RATsynthesizers/FXcursion-HW/3D/Common parts/tmp/iso-7380-din-7380-parafuso-oval-sextavado-1.snapshot.6/ISO 7380 - DIN 7380.JPG

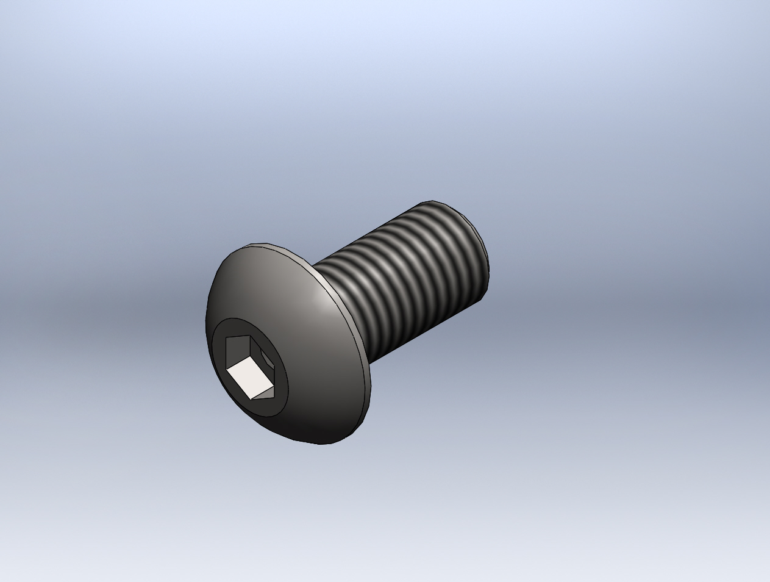
3D/Common parts/tmp/iso-7380-din-7380-parafuso-oval-sextavado-1.snapshot.6/ISO 7380 - DIN 7380.JPG
