RATsynthesizers/FXcursion-HW/HW/3D_design_approx/main.PcbDoc.htm

Reporting Options

# File in Newer Format

Date | : | 28.10.2026
Time | : | 22:34:09
Filename | : | C:\Users\romte\Desktop\FXcursion-HW\HW\3D_design_approx\main.PcbDoc

Version | Warning
Release 23.6 | CAUTION - The PCB document contains Footprint parameters. These will be lost when opening the document in a version of Altium Designer that does not support this functionality.

This file was generated by a later version of the software
