RATsynthesizers/FXcursion-HW/HW/H743ZI_SD_LCD_DRAM_Dev/Docs/NUCLEO-144pins_Altium_Schematics-Layout/MB1137.PcbDoc.htm

Reporting Options

# File in Newer Format

Date | : | 4/4/2026
Time | : | 5:01:34 PM
Filename | : | D:\TMP\Desktop\FXcursion-HW\HW\H743ZI_SD_LCD_DRAM_Dev\Docs\NUCLEO-144pins_Altium_Schematics-Layout\MB1137.PcbDoc

Version | Warning
Release 12 | CAUTION - Air Gap Width previously controlled by Clearance rule is now controlled by Polygon Connect Style rule's newly introduced Air Gap Width (set to default value). Suggest reviewing each Polygon Connect Style rule's Air Gap Width attribute for correctness.
Release 13 | CAUTION - Silkscreen Over Component Pads Rules are converted to Silk To Solder Mask Clearance Rules. Suggest examining rule scopes for accuracy.

This file was generated by an earlier version of the software
