RATsynthesizers/FXcursion-HW/HW/_3D/pcb's/3D_design_approx/test_4/IDFReport_3d_design_approx.html

Altium customize

# IDF File Translation Report

Date: | | 2/19/2024
Time: | | 11:19:47 PM
Elapsed Time: | | 00:00:00
PCB Filename | : | D:\YandexDisk\FXcursion-HW\HW\3D_design_approx\3d_design_approx.PcbDoc
IDF Board Filename | : | D:\YandexDisk\FXcursion-HW\HW\_3D\pcb's\3D_design_approx\test_4\3d_design_approx.brd
IDF Library Filename | : | D:\YandexDisk\FXcursion-HW\HW\_3D\pcb's\3D_design_approx\test_4\3d_design_approx.pro

Errors

Back to top

Warnings

Back to top

Save Warnings

Back to top

Save Errors

Back to top

Export Warnings

Library Component SOT-666 is missing Comment, resulting in missing Part Number. Suggest using 'Replace Blank Component Fields With' Export IDF option.

Back to top

Export Errors

Back to top
