RATsynthesizers/FXcursion-HW/HW/README_pedalboard_hw.docx

Actual pinouts are:

\HW\_Docs\ _AUDIO_PINOUT

\HW\_Docs\_GUI_PINOUT

Мы поняли, что у нас:

- По 2 плашки 512 мегабит ОЗУ (128 мегабайт в сумме) на каждом мк
- Из них где-то 25 мегабайт – активный размер лупера для сохранения на сд-карту (x2 на ctrl+z, и ещё x2 для двух луперов – всего 100 мегабайт под лупер в ОЗУ)
- Что даёт нам бюджет моно звука для обоих луперов (48khz, 25 мегабайт, данные упакованы):

16-bit: ~4 min 20 sec

24-bit: ~2 min 54 sec

32-bit: ~2 min 10 sec

- То есть, в самом худшем случае – 2 стерео-лупера – имеем макс. длину лупа:

16-bit: ~1 min 5 sec

24-bit: ~43 sec

32-bit: ~32sec

- При самом низком музыкальном BPM=40 длина 4 баров = 24сек, так что на 24-bit звуке будем иметь двойной запас при BPM=45. И на 32-bit звуке будет двойной запас при BPM=60.
- Передача 25 мегабайт по каналу SPI c выделенной для этого полосой 80 мегабит займёт ~2.5 сек. При этом по SPI 96MHz может ещё одновременно передаваться 4 канала рекордера.
- Размер ОЗУ GUI тоже составляет 128 мегабайт, так что туда спокойно поместится до 4 сохранений лупера. После этого нужно будет ждать сохранения этого буфера на SD-карту.

Last commit:

Pinout checking, bridging audio testboard and main board

Give SD_DETECT a defined inactive state, typically using about 10 kΩ with polarity chosen for the socket switch. Check the card controller's CMD/DAT pull-ups against the selected SD mode and card specification. Add a low-capacitance ESD protector close to the socket.

P0 — Power board, page 13: MT3608 boost output is set to approximately 6.6 V

The schematic shows R17 = 10 kΩ from the output to FB and R20 = 1 kΩ from FB to ground. The MT3608 uses a nominal 0.6 V feedback reference:

\[ V_{OUT}=0.6\left(1+\frac{10k}{1k}\right)=6.6\text{ V} \]

This conflicts with the +5V net label and could overvoltage the connected 5 V circuits. The MT3608 datasheet confirms the feedback equation.

Fix: If R20 remains 1 kΩ, use approximately 7.32 kΩ for R17 for about 4.99 V nominal. Recalculate using the chosen resistor tolerances and the actual converter variant, then verify output under light load, full load, startup, and battery-voltage extremes. Check the PCB feedback route is short and kept away from the switch node.

The project notes already flag recalculating this divider and adding 5 V overvoltage protection.

Codec interface, page 9: the two I2C1_SCL branches are gated using SN74LVC1G08 AND gates controlled by CODEC_GPIO1 and CODEC_GPIO2. TI specifies this device's output as push-pull, not open-drain.

I²C back propagation thru isolators, SDA ack problems

Pullups on every stage

SDMMC clock, QSPI clock, FMC/SDRAM clock, SPI SCK, SAI bit clock

These nets include high-edge-rate signals and some route through connectors

Add optional source-series resistor footprints, initially around 22–33 Ω, at the driver for clocks where ringing is a concern. Tune with the real PCB and oscilloscope; do not populate blanket resistors on every line without evidence.

DISPLAY LEDK CURRENT DRIVER instead of resistors
