RATsynthesizers/FXcursion-HW/HW/H743ZI_SD_LCD_DRAM_Dev/pinout_devboard.ods

PIN | FUNCTION | DEV_FUNCTION
PB5 | FMC_SDCKE1
PB6 | FMC_SDNE1
PC0 | FMC_SDNWE
PC2_C | FMC_SDNE0
PC3_C | FMC_SDCKE0
PC7 | FMC_NE1
PD0 | FMC_D2
PD1 | FMC_D3
PD4 | FMC_NOE
PD5 | FMC_NWE
PD8 | FMC_D13
PD9 | FMC_D14
PD10 | FMC_D15
PD14 | FMC_D0
PD15 | FMC_D1
PE0 | FMC_NBL0
PE1 | FMC_NBL1
PE5 | FMC_A21
PE6 | FMC_A22
PE7 | FMC_D4
PE8 | FMC_D5
PE9 | FMC_D6
PE10 | FMC_D7
PE11 | FMC_D8
PE12 | FMC_D9
PE13 | FMC_D10
PE14 | FMC_D11
PE15 | FMC_D12
PF0 | FMC_A0
PF1 | FMC_A1
PF2 | FMC_A2
PF3 | FMC_A3
PF4 | FMC_A4
PF5 | FMC_A5
PF11 | FMC_SDNRAS
PF12 | FMC_A6
PF13 | FMC_A7
PF14 | FMC_A8
PF15 | FMC_A9
PG0 | FMC_A10
PG1 | FMC_A11
PG4 | FMC_BA0
PG5 | FMC_BA1
PG8 | FMC_SDCLK
PG12 | FMC_NE4
PG15 | FMC_SDNCAS
PB2 | MY_LCD_TE_EXTI2
PC6 | MY_LCD_RESET
PC8 | SDMMC1_D0
PC9 | SDMMC1_D1
PC10 | SDMMC1_D2
PC11 | SDMMC1_D3
PC12 | SDMMC1_CK
PD2 | SDMMC1_CMD
PA10 | MY_SD_DETECT
PG2 | MY_FOOT3 | ENC_PARAM_B
PG3 | MY_FOOT2 | ENC_PARAM_A
PG7 | MY_FOOT1 | FOOT_1
PA7 | TIM8_CH1N | RGB_1
PB0 | TIM8_CH2N | RGB_2
PB1 | TIM8_CH3N | RGB_3
PG13 | MY_CHR2 | UP
PG14 | MY_CHR1 | DOWN
PB4 (NJTRST) | MY_CHST | YES
PB7 | MY_ADCON | NO
PE3 | MY_AUDIO_RST | ENC_A
PE4 | MY_AUDIO_BOOT | ENC_B
PA6 | ADC1_INP3 | ADC_VOL
PD11 | QUADSPI_BK1_IO0
PD12 | QUADSPI_BK1_IO1
PD13 | QUADSPI_BK1_IO3
PE2 | QUADSPI_BK1_IO2
PF10 | QUADSPI_CLK
PG6 | QUADSPI_BK1_NCS
PG9 | SPI1_MISO
PD7 | SPI1_MOSI
PG10 | SPI1_NSS
PG11 | SPI1_SCK
PB14 | SPI2_MISO
PB15 | SPI2_MOSI
PB12 | SPI2_NSS
PB13 | SPI2_SCK
PA2 | USART2_TX
PD6 | USART2_RX
PA0 | UART4_TX
PA1 | UART4_RX
PA8 | USB_OTG_FS_SOF
