RATsynthesizers/FXcursion-HW/3D/Pedal_V0/Fragment.png

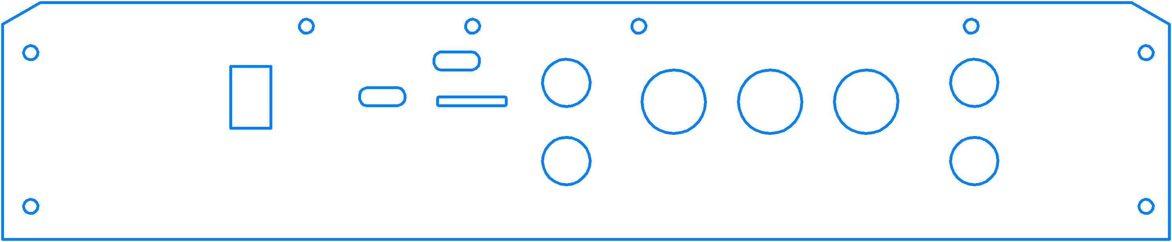
3D/Pedal_V0/Fragment.png
