RATsynthesizers/FXcursion-HW/3D/Pedal_V0/Pedal_assy_2/photo_export.jpg

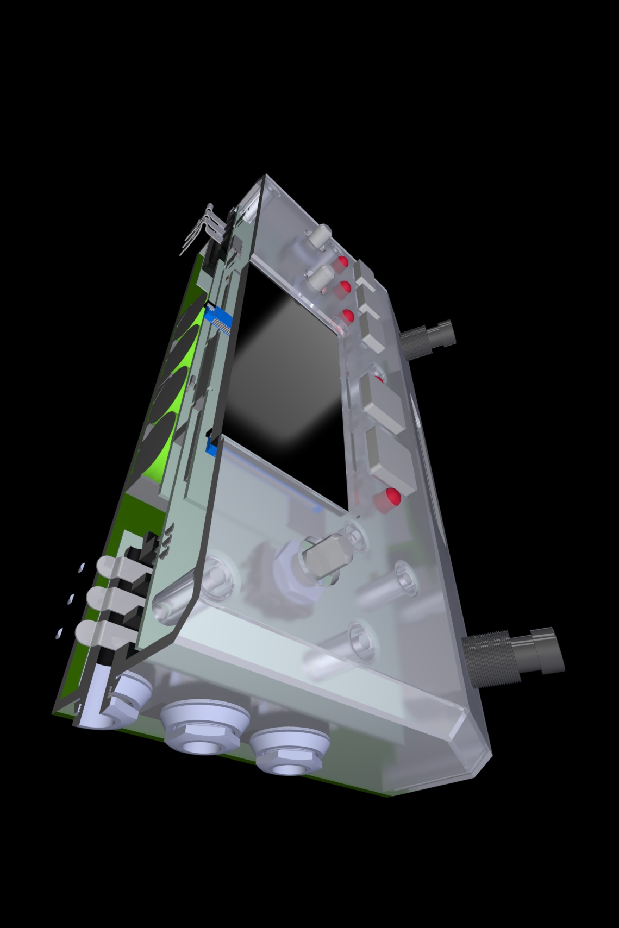
3D/Pedal_V0/Pedal_assy_2/photo_export.jpg
