RATsynthesizers/FXcursion-HW/3D/Pedal_V0/Pedal_assy_2/real_time_Pedal_assy_21.jpg

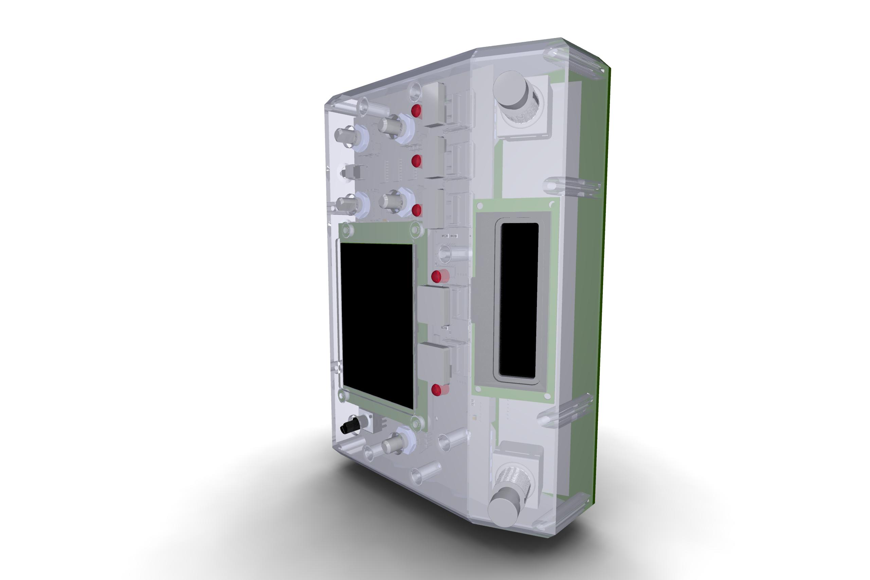
3D/Pedal_V0/Pedal_assy_2/real_time_Pedal_assy_21.jpg
