RATsynthesizers/FXcursion-HW/common docs/Pedal.png

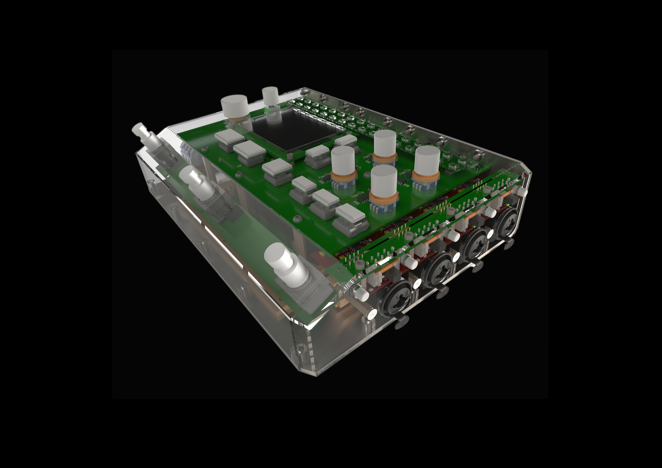
common docs/Pedal.png
