RATsynthesizers/FXcursion-HW/common docs/photo_2026-09-20_17-13-00.jpg

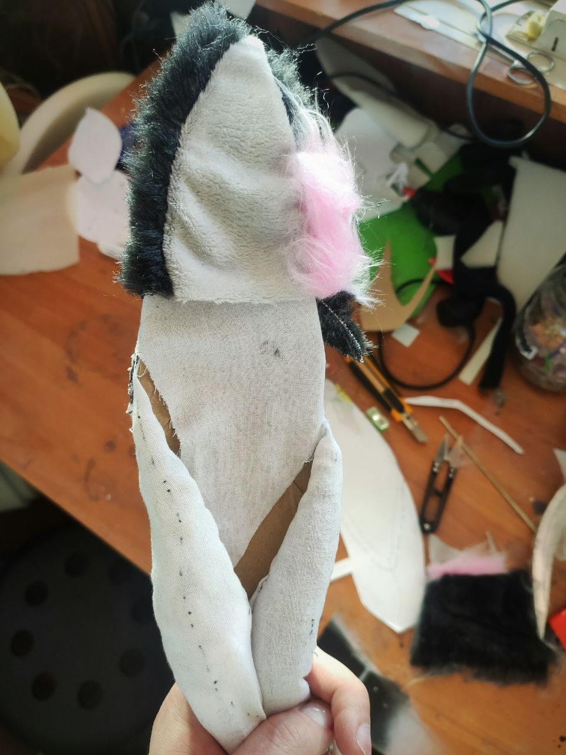
common docs/photo_2026-09-20_17-13-00.jpg
