RATsynthesizers/FXcursion-HW/common docs/photo_2026-09-29_17-15-21.jpg

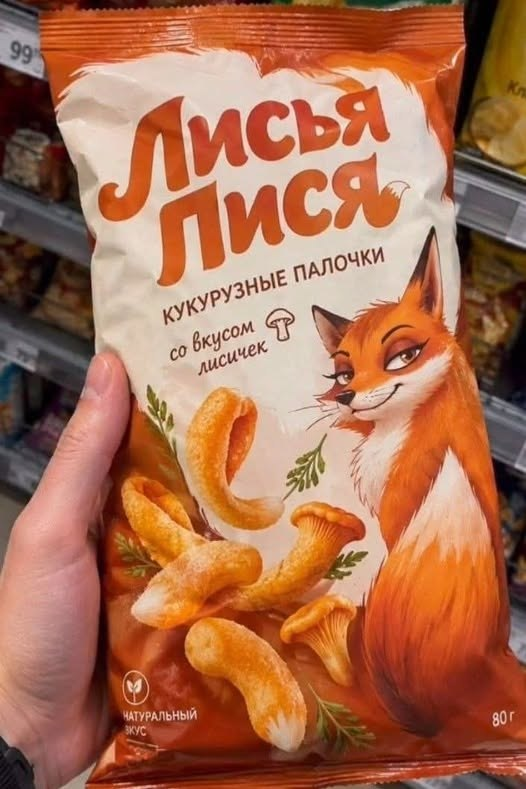
common docs/photo_2026-09-29_17-15-21.jpg
