RATsynthesizers/FXcursion-HW/HW/_Pics/MCP73831_loadshare_mcu2.png

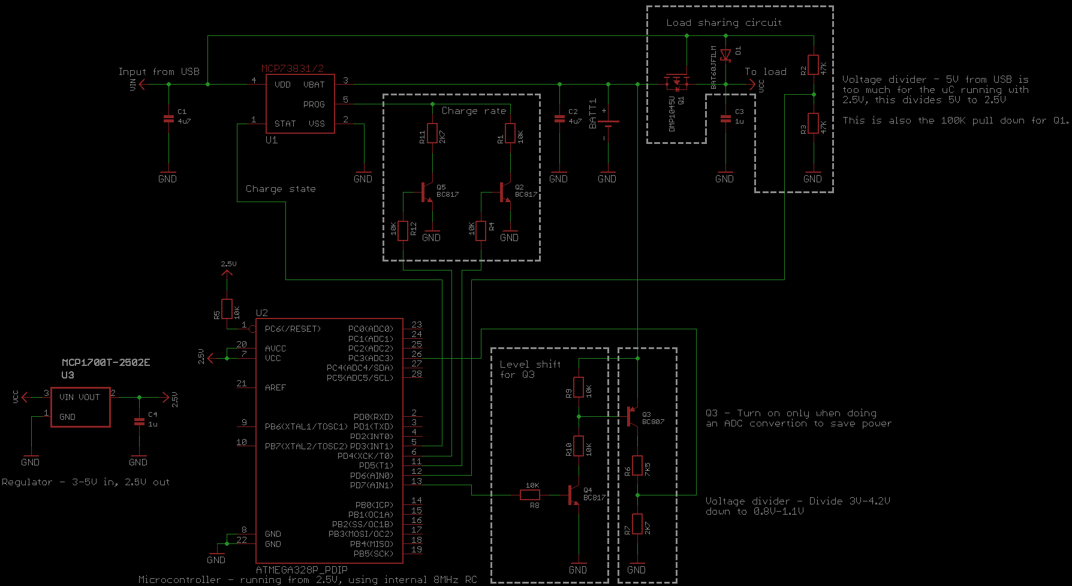
HW/_Pics/MCP73831_loadshare_mcu2.png
