RATsynthesizers/FXcursion-HW/HW/_Pics/xlr2.png

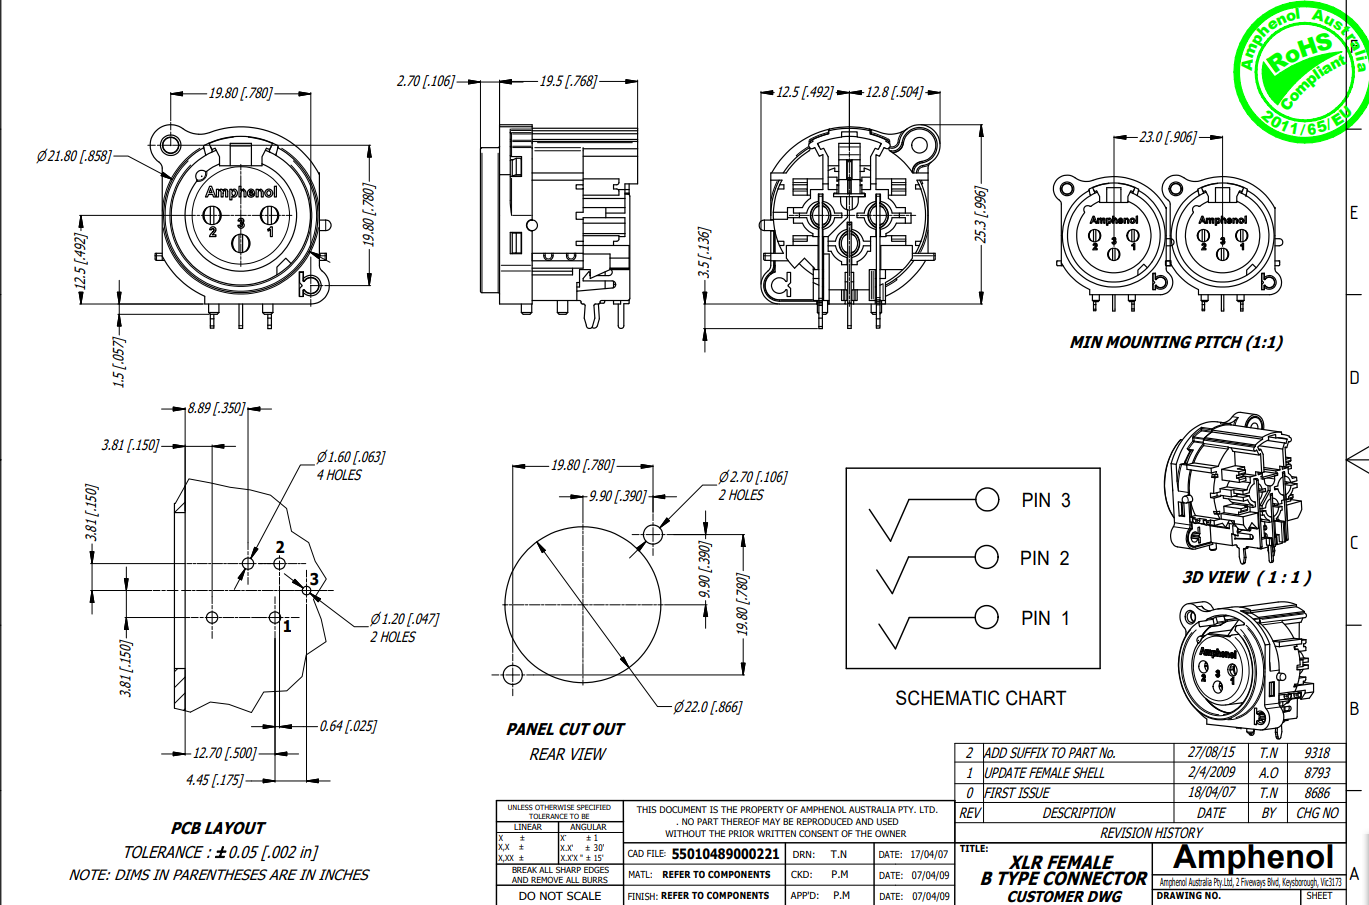
HW/_Pics/xlr2.png
