RATsynthesizers/FXcursion-HW/HW/Test_MultiBoard_Project/Project Outputs for Pedal_MultiBoard_Project/Pedal_MultiBoard_Project.xlsx

Line # | Name | Description | Designator | ModuleAssembly | Quantity | Part Number | Manufacturer 1 | Manufacturer Part Number 1 | Manufacturer Lifecycle 1 | Supplier 1 | Supplier Part Number 1 | Supplier Unit Price 1 | Supplier Subtotal 1
 |  |  |  | SOM_Codec_WM8731.PcbDoc, Pedal_XLR.PcbDoc, Pedal_SW.PcbDoc | 16
 | 1043 | BATTERY HOLDER 18650 PC PIN | B1, B2, B3, B4 | Pedal_Power.PcbDoc | 4 | 1043 |  |  |  | DigiKey | 36-1043-ND
 | 2.2 µF | CAP CER 2.2UF 10V X7R 0805 | C1, C2, C9, C10 | main.PcbDoc | 4 | C0805C225K8RAC7800 |  |  |  | DigiKey | 399-C0805C225K8RAC7800CT-ND
 | 10 µF | CAP CER 10UF 10V X5R 0805 | C1, C3, C4, C6, C7, C9, C11, C28, C30, C71, C74, C84, C85, C87, C88, C92, C93, C95 | SOM_Codec_WM8731.PcbDoc, Pedal_Power.PcbDoc, main.PcbDoc | 19 | C0805C106K8PAC7800 |  |  |  | DigiKey | 399-C0805C106K8PAC7800CT-ND
 | 0.1µF | CAP CER 0.1UF 16V X7R 0402 | C1, C3, C5, C7, C8, C10, C11, C12, C13, C14, C15, C16, C17, C18, C19, C20, C21, C22, C23, C24, C25, C26, C27, C28, C29, C30, C31, C32, C33, C34, C35, C36, C37, C38, C39, C40, C41, C42, C43, C44, C45, C46, C47, C48, C49, C50, C51, C52, C53, C54, C55, C56, C57, C58, C59, C60 | Pedal_SD_USB.PcbDoc, SOM_Codec_WM8731.PcbDoc, main.PcbDoc | 63 | C0402C104K4RACAUTO |  |  |  | DigiKey | 399-6828-1-ND
 | 10000 pF | CAP CER 10000PF 1KV X7R 1210 | C2 | Pedal_SD_USB.PcbDoc | 1 | C1210C103KDRAC7800 |  |  |  | DigiKey | 399-C1210C103KDRAC7800CT-ND
 | 1 µF | CAP CER 1UF 16V X7R 0805 | C2, C4, C5, C6, C69, C70, C72, C75, C76, C89 | SOM_Codec_WM8731.PcbDoc, Pedal_Power.PcbDoc, main.PcbDoc | 10 | C0805C105K4RAC7800 |  |  |  | DigiKey | 399-C0805C105K4RAC7800CT-ND
 | 9pF | CAP CER 9PF 250V C0G/NP0 0805 | C3, C4, C5, C6, C31, C32, C33 | main.PcbDoc, SOM_Codec_WM8731.PcbDoc | 7 | CBR08C909CAGAC |  |  |  | DigiKey | 399-8711-1-ND
 | 22 µF | CAP CER 22UF 25V X5R 0805 | C7, C8, C10, C12, C13 | Pedal_Power.PcbDoc | 5 | GRM21BR61E226ME44K |  |  |  | DigiKey | 490-14661-1-ND
 | 10µF | CAP TANT 10UF 10% 10V 1206 | C13, C14, C19, C20 | SOM_Codec_WM8731.PcbDoc | 4 | T491A106K010AT |  |  |  | DigiKey | 399-3684-1-ND
 | 220 pF | CAP CER 220PF 50V X7R 0603 | C17, C18, C21, C22 | SOM_Codec_WM8731.PcbDoc | 4 | C0603C221K5RAC7867 |  |  |  | DigiKey | 399-C0603C221K5RAC7867CT-ND
 | 47µF | CAP TANT 47UF 10% 10V 2917 | C23, C25 | SOM_Codec_WM8731.PcbDoc | 2 | 293D476X9010D2TE3 |  |  |  | DigiKey | 718-1088-1-ND
 | 0.1 µF | CAP CER 0.1UF 50V X7R 0603 | C61, C62, C63, C64, C65, C73, C77_IC101, C77_IC102, C77_IC103, C77_IC104, C77_IC105, C78_IC101, C78_IC102, C78_IC103, C78_IC104, C78_IC105, C79_IC101, C79_IC102, C79_IC103, C79_IC104, C79_IC105, C80, C81, C86 | main.PcbDoc | 24 | C0603C104K5RAC7411 |  |  |  | DigiKey | 399-C0603C104K5RAC7411CT-ND
 | 7 pF | CAP CER 7PF 50V C0G/NPO 0805 | C67, C68 | main.PcbDoc | 2 | CC0805DRNPO9BN7R0 |  |  |  | DigiKey | 311-1096-1-ND
 | 22 µF | CAP CER 22UF 25V X5R 0805 | C90, C91, C94, C96, C97 | main.PcbDoc | 5 | CC0805MKX5R8BB226 |  |  |  | DigiKey | 311-1903-1-ND
 | 1N4148W-TP | DIODE GEN PURP 100V 150MA SOD123 | D1 | main.PcbDoc | 1 | 1N4148W-TP |  |  |  | DigiKey | 1N4148WTPMSCT-ND
 | SS24 | DIODE SCHOTTKY 40V 2A DO214AA | D1, D2, D3 | Pedal_Power.PcbDoc, main.PcbDoc | 4 | SS24 |  |  |  | DigiKey | SS24FSCT-ND
 | Red | LED RED CLEAR 0805 SMD | D3, D4 | Pedal_Power.PcbDoc, main.PcbDoc | 2 | LSM0805412V |  |  |  | DigiKey | 28-LSM0805412VCT-ND
 | Comment |  | Designator3, Designator4, Designator5, Designator6 | Pedal_XLR.PcbDoc, Pedal_SW.PcbDoc | 8
 | Encoder_15mm |  | ENC1, ENC2, ENC3, ENC4, ENC5 | main.PcbDoc | 5
 | 220 Ohms @ 100 MHz | FERRITE BEAD 220 OHM 0805 1LN | FB1, FB2, FB3, FB4, FB5 | main.PcbDoc | 5 | BLM21PG221SN1D |  |  |  | DigiKey | 490-1054-1-ND
 | Z=90Ohm | ACM Series 0805 360 Ohm 220mA 500 mOhm DCR 50 V SMT Common Mode Filter | FL1 | Pedal_SD_USB.PcbDoc | 1
 | FootSwitch |  | FSW1, FSW2, FSW3 | FootSW.PcbDoc | 3
 | FFC_50_DBG |  | H1, H2, H3 | Pedal_Display.PcbDoc, main.PcbDoc | 3
 | arduino_header_6 |  | H1, H2, H3, H4 | main.PcbDoc, Pedal_SD_USB.PcbDoc | 6
 | STM32H743ZIT6U | Integrated Circuit | IC1, IC2 | main.PcbDoc | 2
 | ams1117-3.3v | Integrated Circuit | IC1, IC10 | SOM_Codec_WM8731.PcbDoc, main.PcbDoc | 2 |  |  |  |  | LCSC | C6186
 | DMP1045U-7 | MOSFET P-CH 12V 4A SOT23 | IC2, IC20 | Pedal_Power.PcbDoc, main.PcbDoc | 2 | DMP1045U-7 |  |  |  | DigiKey | DMP1045U-7DICT-ND
 | LY68L6400SLIT | Integrated Circuit | IC3 | main.PcbDoc | 1
 | MT3608 | Integrated Circuit | IC3, IC21 | Pedal_Power.PcbDoc, main.PcbDoc | 2
 | SN74LVC1G125DBVR | Integrated Circuit | IC4, IC18, IC19 | main.PcbDoc | 3
 | IP2312 | Integrated Circuit | IC4, IC23 | Pedal_Power.PcbDoc, main.PcbDoc | 2
 | N25Q128A13ESE40F | Integrated Circuit | IC6, IC55 | main.PcbDoc | 2
 | AT24C128BN-SH-B | Integrated Circuit | IC7, IC8 | main.PcbDoc | 2
 | LD1117DT33TR | Integrated Circuit | IC9, IC22 | main.PcbDoc | 2
 | 74VHCT14AM | Integrated Circuit | IC11_IC101, IC11_IC102, IC11_IC103, IC11_IC104, IC11_IC105 | main.PcbDoc | 5
 | SN74HC245PWR | Integrated Circuit | IC14 | main.PcbDoc | 1
 | 74HC165D_BJ_ | Integrated Circuit | IC15, IC16, IC17 | main.PcbDoc | 3
 | DF9-41P-1V_32_ | Connector | J1 | SOM_Codec_WM8731.PcbDoc | 1
 | 0528081271 | Connector | J1, J2, J3, J4, J5, J6, J7 | main.PcbDoc, Pedal_XLR.PcbDoc, Jacks.PcbDoc, FootSW.PcbDoc, Pedal_Power.PcbDoc, SOM_Codec_WM8731.PcbDoc | 17
 | TYPE-C-31-M-12 | USB Connectors 24 Receptacle 1 8.94*7.3mm RoHS | J1, J20 | Pedal_SD_USB.PcbDoc, main.PcbDoc | 2
 | SCHA4B0400 | SD card Connector | J2 | Pedal_SD_USB.PcbDoc | 1
 |  |  | J4, J5, J6, J7, J8, J9, J14, J15, J16, J17, J18, J19 | main.PcbDoc | 12
 | MIDI_IN | DIN5 | JK1 | main.PcbDoc | 1
 | MIDI_OUT/THRU | DIN5 | JK2 | main.PcbDoc | 1
 | 3.3 µH | FIXED IND 3.3UH 2.5A 28 MOHM SMD | L1, L2 | main.PcbDoc, SOM_Codec_WM8731.PcbDoc, Pedal_Power.PcbDoc | 5 | SRR6028-3R3Y |  |  |  | DigiKey | 118-SRR6028-3R3YCT-ND
 | WS2812B | Address LED | LED1, LED2, LED3, LED4, LED5, LED6, LED7, LED8, LED9, LED10, LED11, LED12, LED13, LED14, LED15, LED16, LED17, LED18, LED19, LED20, LED21, LED22, LED23, LED24, LED25, LED26, LED27, LED28, LED29, LED30, LED31, LED32 | main.PcbDoc | 32
 | MountingHole |  | MH1, MH2, MH3, MH4, MH5, MH6, MH7, MH8, MH9, MH10 | main.PcbDoc, SOM_Codec_WM8731.PcbDoc, Pedal_Display.PcbDoc, Pedal_SD_USB.PcbDoc | 20
 | PJ-609AE | 6.3mm jack HOOYA | PJ1, PJ2, PJ3, PJ4 | main.PcbDoc, Jacks.PcbDoc | 7
 | MMBT3904-7-F | TRANS NPN 40V 0.2A SOT23-3 | Q1, Q2, Q4, Q5, Q6 | main.PcbDoc, Pedal_Power.PcbDoc | 8 | MMBT3904-7-F |  |  |  | DigiKey | MMBT3904-FDICT-ND
 | 3906 |  | Q3 | main.PcbDoc, Pedal_Power.PcbDoc | 2
 |  | RES SMD 1M OHM 1% 1/10W 0603 | R1 | Pedal_SD_USB.PcbDoc | 1 | ERJ-3EKF1004V |  |  |  | DigiKey | P1.00MHCT-ND
 | YC164-JR-07100RL | RES ARRAY 4 RES 100 OHM 1206 | R1, R2 | main.PcbDoc | 2 | YC164-JR-07100RL |  |  |  | DigiKey | YC164J-100CT-ND
 | 5.6 kOhms | RES SMD 5.6K OHM 0.5% 1/10W 0603 | R1, R2, R3, R4, R5, R6, R7, R8, R13, R14, R15, R16, R17, R18 | SOM_Codec_WM8731.PcbDoc, main.PcbDoc | 14 | RT0603DRE075K6L |  |  |  | DigiKey | 311-2635-1-ND
 | 10 kOhms | RES SMD 10K OHM 1% 1/10W 0603 | R1, R3, R8, R9, R11, R13, R24, R25 | Pedal_Power.PcbDoc | 8 | RT0603FRE0710KL |  |  |  | DigiKey | YAG2321CT-ND
 | =Value | RES SMD 0 OHM JUMPER 1/10W 0603 | R2, R4, R135, R136 | Pedal_Power.PcbDoc, Pedal_SD_USB.PcbDoc, main.PcbDoc | 5 | RCA06030000ZSEA |  |  |  | DigiKey | 541-2192-1-ND
 | 100 Ohms | RES SMD 100 OHM 1% 1/16W 0402 | R3, R4, R8, R72, R73, R74, R75, R76, R77, R87, R88, R89, R90, R91, R92, R93, R94, R95, R96, R97, R98, R99, R100, R101, R108, R110, R111, R112, R113, R114, R115, R116, R117, R118, R119, R120, R121, R122, R123, R124, R132 | main.PcbDoc, Pedal_Power.PcbDoc | 42 | CRCW0402100RFKEE |  |  |  | DigiKey | 541-2953-1-ND
 | 10 kOhms | RES SMD 10K OHM 1% 1/10W 0603 | R5, R6, R7, R8, R9, R10, R11, R12, R17, R19, R21, R22, R23, R24, R25, R26, R27, R28, R29, R30, R31, R32, R33, R34, R35, R36, R38, R46, R47_IC101, R47_IC102, R47_IC103, R47_IC104, R47_IC105, R48_IC101, R48_IC102, R48_IC103, R48_IC104, R48_IC105, R49_IC101, R49_IC102, R49_IC103, R49_IC104, R49_IC105, R50, R78, R79, R80, R81, R82, R83, R84, R85, R86, R106, R107, R109, R133, R134 | main.PcbDoc, Pedal_SD_USB.PcbDoc | 63 | ERJ-3EKF1002V |  |  |  | DigiKey, [NoParam] | P10.0KHCT-ND, [NoParam]
 | 1 MOhms | RES SMD 1M OHM 1% 1/10W 0603 | R6 | Pedal_SD_USB.PcbDoc | 1 | ERJ-3EKF1004V |  |  |  | DigiKey | P1.00MHCT-ND
 | 47 kOhms | RES SMD 47K OHM 1% 1/10W 0603 | R9, R13 | SOM_Codec_WM8731.PcbDoc | 2 | RT0603FRE0747KL |  |  |  | DigiKey | YAG3355CT-ND
 | 7.5 kOhms | RES 7.5K OHM 1% 1/10W 0603 | R10 | Pedal_Power.PcbDoc | 1 | RC0603FR-077K5L |  |  |  | DigiKey | 311-7.50KHRCT-ND
 | YC164-JR-0733RL | RES ARRAY 4 RES 33 OHM 1206 | R11, R12 | SOM_Codec_WM8731.PcbDoc | 2 | YC164-JR-0733RL |  |  |  | DigiKey | YC164J-33CT-ND
 | 2.7 kOhms | RES 2.7K OHM 1% 1/10W 0603 | R12 | Pedal_Power.PcbDoc | 1 | RC0603FR-072K7L |  |  |  | DigiKey | 311-2.70KHRCT-ND
 | 1 kOhms | RES SMD 1K OHM 1% 1/10W 0603 | R14 | Pedal_Power.PcbDoc | 1 | RT0603FRE071KL |  |  |  | DigiKey | YAG2323CT-ND
 | 100 Ohms | RES SMD 100 OHM 1% 1/16W 0402 | R15, R16 | SOM_Codec_WM8731.PcbDoc | 2 | RT0402FRE07100RL |  |  |  | DigiKey | YAG3342CT-ND
 | 1 kOhms | RES 1K OHM 5% 1/10W 0603 | R15, R18, R19 | Pedal_Power.PcbDoc | 3 | RC0603JR-071KP |  |  |  | DigiKey | YAG1311CT-ND
 | 2 Ohms | RES 2 OHM 1% 1/10W 0603 | R16 | Pedal_Power.PcbDoc | 1 | RC0603FR-072RL |  |  |  | DigiKey | 311-2.00HRCT-ND
 | 500 mOhms | RES 0.5 OHM 1% 1/10W 0603 | R17 | Pedal_Power.PcbDoc | 1 | RL0603FR-070R5L |  |  |  | DigiKey | 311-.5QCT-ND
 | Value | RES SMD 0 OHM JUMPER 1/10W 0603 | R18 | main.PcbDoc | 1 | RCA06030000ZSEA |  |  |  | DigiKey | 541-2192-1-ND
 | 51 kOhms | RES 51K OHM 1% 1/10W 0603 | R20, R23 | Pedal_Power.PcbDoc | 2 | RC0603FR-0751KL |  |  |  | DigiKey | 311-51.0KHRCT-ND
 | 1 kOhms | RES SMD 1K OHM 1% 1/10W 0603 | R20, R52, R127 | main.PcbDoc | 3 | CRCW06031K00FKEB |  |  |  | DigiKey | 541-2985-1-ND
 | 330 kOhms | RES 330K OHM 5% 1/10W 0603 | R21 | Pedal_Power.PcbDoc | 1 | RC0603JR-07330KL |  |  |  | DigiKey | 311-330KGRCT-ND
 | 220 kOhms | RES 220K OHM 1% 1/10W 0603 | R22 | Pedal_Power.PcbDoc | 1 | RC0603FR-07220KL |  |  |  | DigiKey | 311-220KHRCT-ND
 | 100k |  | R37 | main.PcbDoc | 1
 | 7.5 kOhms | RES 7.5K OHM 1% 1/10W 0603 SMD | R39 | main.PcbDoc | 1 | ERJ-U03F7501V |  |  |  | DigiKey | 10-ERJ-U03F7501VCT-ND
 | 22 Ohms | RES 22 OHM 5% 1/16W 0402 | R40, R41, R54, R55, R56, R57, R58, R59, R60, R61, R62, R63, R64, R65, R66, R67, R68, R69, R70, R71, R104 | main.PcbDoc | 21 | RMCF0402JT22R0 |  |  |  | DigiKey | RMCF0402JT22R0CT-ND
 | 10 Ohms | RES SMD 10 OHM 1% 1/3W 0603 | R42, R43, R44, R45, R102, R103, R105 | main.PcbDoc | 7 | ERJ-PA3F10R0V |  |  |  | DigiKey | P10.00BYCT-ND
 | 2.7 kOhms | RES 2.7K OHM 1% 1/10W 0603 | R51 | main.PcbDoc | 1 | CRCW06032K70FKEAC |  |  |  | DigiKey | 541-5328-1-ND
 | 2 Ohms | RES 2 OHM 1% 1/10W 0603 SMD | R53 | main.PcbDoc | 1 | ERJ-U03F2R00V |  |  |  | DigiKey | 10-ERJ-U03F2R00VCT-ND
 | 500 mOhms | RES 0.5 OHM 1% 1/10W 0603 | R125 | main.PcbDoc | 1 | RLT0816-C-R500-FNH |  |  |  | DigiKey | 2037-RLT0816-C-R500-FNHCT-ND
 |  | RES SMD 1K OHM 1% 1/10W 0603 | R126 | main.PcbDoc | 1 | CRCW06031K00FKEB |  |  |  | DigiKey | 541-2985-1-ND
 | 51 kOhms | RES 51K OHM 1% 1/10W 0603 | R128, R131 | main.PcbDoc | 2 | RMCF0603FT51K0 |  |  |  | DigiKey | RMCF0603FT51K0CT-ND
 | 330 kOhms | RES 330K OHM 5% 1/10W 0603 | R129 | main.PcbDoc | 1 | RMCF0603JG330K |  |  |  | DigiKey | RMCF0603JG330KCT-ND
 | 220 kOhms | RES 220K OHM 1% 1/10W 0603 | R130 | main.PcbDoc | 1 | CRCW0603220KFKEAC |  |  |  | DigiKey | 541-4039-1-ND
 | SS312SAH4-R | SWITCH SLIDE SPDT 0.4VA 28V | S1 | main.PcbDoc | 1 | SS312SAH4-R |  |  |  | DigiKey | 360-2924-1-ND
 | Kailh | Kailh keyboard switch, hotswap rgb, dual-side hotswap options + low prifile variant | SW1, SW2, SW3, SW4, SW5, SW6, SW7 | main.PcbDoc | 7
 | UART4_TX |  | TP1 | main.PcbDoc | 1
 | UART4_RX |  | TP2 | main.PcbDoc | 1
 | SAI2_SCK |  | TP3 | main.PcbDoc | 1
 | SAI2_FS |  | TP4 | main.PcbDoc | 1
 | USER_DBG1 |  | TP5 | main.PcbDoc | 1
 | USER_DBG2 |  | TP6 | main.PcbDoc | 1
 |  |  | TP7, TP8, TP9 | main.PcbDoc | 3
 | UART1_RX_boot |  | TP10 | main.PcbDoc | 1
 | UART1_TX_boot |  | TP11 | main.PcbDoc | 1
 | ToPower |  | TP12, TP13, TP14 | main.PcbDoc | 3
 | ToBAT+ |  | TP15 | main.PcbDoc | 1
 | ToBAT- |  | TP16 | main.PcbDoc | 1
 |  | Very Low Capacitance Esd Protection | U1 | Pedal_SD_USB.PcbDoc | 1
 | WM8731 | Stero in/ot audio codec | U1, U2 | SOM_Codec_WM8731.PcbDoc | 2
 | CONN-TH_NCJ6FA-H |  | U1, U2, U3, U4 | Pedal_XLR.PcbDoc | 4
 | W9812G6KH-6 |  | U1, U2, U3, U4 | main.PcbDoc | 4
 | H11L1 | OPTOISO 4.17KV OPN COLL 6SMD | U6 | main.PcbDoc | 1
 | 24.576MHz | CRYSTAL 24.5760MHZ 10PF SMD | Y1 | SOM_Codec_WM8731.PcbDoc | 1 | ABM8G-24.576MHZ-B4Y-T |  |  |  | DigiKey | 535-10296-1-ND
 | 24MHz | CRYSTAL 24MHZ 9PF SMD | Y1, Y2 | main.PcbDoc | 2 | NX3225SA-24MHZ-EXS00A-CS07532 |  |  |  | DigiKey | 644-1393-1-ND
 | ABS07-32.768KHZ-7-T | Crystal or Oscillator | Y3 | main.PcbDoc | 1
