RATsynthesizers/FXcursion-HW/HW/_Docs/New Folder (2)/pinout ioc h743zi_gui/pinout ioc h743zi_gui.csv

Position | Name | Type | Signal | Label
1 | PE2 | I/O | QUADSPI_BK1_IO2
2 | PE3 | I/O
3 | PE4 | I/O
4 | PE5 | I/O | FMC_A21
5 | PE6 | I/O | FMC_A22
6 | VBAT | Power
7 | PC13 | Output | GPIO_Output | MY_UI_RESET
8 | PC14-OSC32_IN (OSC32_IN) | I/O | RCC_OSC32_IN
9 | PC15-OSC32_OUT (OSC32_OUT) | I/O | RCC_OSC32_OUT
10 | PF0 | I/O | FMC_A0
11 | PF1 | I/O | FMC_A1
12 | PF2 | I/O | FMC_A2
13 | PF3 | I/O | FMC_A3
14 | PF4 | I/O | FMC_A4
15 | PF5 | I/O | FMC_A5
16 | VSS | Power
17 | VDD | Power
18 | PF6 | I/O | SPI5_NSS
19 | PF7 | I/O | SPI5_SCK
20 | PF8 | I/O | SPI5_MISO
21 | PF9 | I/O | SPI5_MOSI
22 | PF10 | I/O | QUADSPI_CLK
23 | PH0-OSC_IN (PH0) | I/O | RCC_OSC_IN
24 | PH1-OSC_OUT (PH1) | I/O | RCC_OSC_OUT
25 | NRST | Reset
26 | PC0 | I/O | FMC_SDNWE
27 | PC1 | I/O | ADC1_INP11
28 | PC2_C | I/O | FMC_SDNE0
29 | PC3_C | I/O | FMC_SDCKE0
30 | VDD | Power
31 | VSSA | Power
32 | VREF+ | MonoIO
33 | VDDA | Power
34 | PA0 | I/O | UART4_TX
35 | PA1 | I/O | UART4_RX
36 | PA2 | I/O | USART2_TX
37 | PA3 | I/O | ADC1_INP15
38 | VSS | Power
39 | VDD | Power
40 | PA4 | I/O | ADC1_INP18
41 | PA5 | I/O | ADC1_INP19
42 | PA6 | I/O | ADC1_INP3
43 | PA7 | I/O | ADC1_INP7
44 | PC4 | I/O | ADC1_INP4
45 | PC5 | I/O | ADC1_INP8
46 | PB0 | I/O | ADC1_INP9
47 | PB1 | I/O | ADC1_INP5
48 | PB2 | Output | GPIO_Output | MY_GUI_PB2
49 | PF11 | I/O | FMC_SDNRAS
50 | PF12 | I/O | FMC_A6
51 | VSS | Power
52 | VDD | Power
53 | PF13 | I/O | FMC_A7
54 | PF14 | I/O | FMC_A8
55 | PF15 | I/O | FMC_A9
56 | PG0 | I/O | FMC_A10
57 | PG1 | I/O | FMC_A11
58 | PE7 | I/O | FMC_D4
59 | PE8 | I/O | FMC_D5
60 | PE9 | I/O | FMC_D6
61 | VSS | Power
62 | VDD | Power
63 | PE10 | I/O | FMC_D7
64 | PE11 | I/O | FMC_D8
65 | PE12 | I/O | FMC_D9
66 | PE13 | I/O | FMC_D10
67 | PE14 | I/O | FMC_D11
68 | PE15 | I/O | FMC_D12
69 | PB10 | I/O | I2C2_SCL
70 | PB11 | I/O | I2C2_SDA
71 | VCAP | Power
72 | VDD | Power
73 | PB12 | I/O | SPI2_NSS
74 | PB13 | I/O | SPI2_SCK
75 | PB14 | I/O | SPI2_MISO
76 | PB15 | I/O | SPI2_MOSI
77 | PD8 | I/O | FMC_D13
78 | PD9 | I/O | FMC_D14
79 | PD10 | I/O | FMC_D15
80 | PD11 | I/O | QUADSPI_BK1_IO0
81 | PD12 | I/O | QUADSPI_BK1_IO1
82 | PD13 | I/O | QUADSPI_BK1_IO3
83 | VSS | Power
84 | VDD | Power
85 | PD14 | I/O | FMC_D0
86 | PD15 | I/O | FMC_D1
87 | PG2 | I/O
88 | PG3 | I/O
89 | PG4 | I/O | FMC_BA0
90 | PG5 | I/O | FMC_BA1
91 | PG6 | I/O | QUADSPI_BK1_NCS
92 | PG7 | I/O
93 | PG8 | I/O | FMC_SDCLK
94 | VSS | Power
95 | VDD33_USB | Power
96 | PC6 | Output | GPIO_Output | MY_LCD_RESET
97 | PC7 | I/O | FMC_NE1
98 | PC8 | I/O | SDMMC1_D0
99 | PC9 | I/O | SDMMC1_D1
100 | PA8 | I/O | USB_OTG_FS_SOF
101 | PA9 | I/O | USB_OTG_FS_VBUS
102 | PA10 | Input | GPIO_Input | MY_SD_DETECT
103 | PA11 | I/O | USB_OTG_FS_DM
104 | PA12 | I/O | USB_OTG_FS_DP
105 | PA13 (JTMS/SWDIO) | I/O | DEBUG_JTMS-SWDIO
106 | VCAP | Power
107 | VSS | Power
108 | VDD | Power
109 | PA14 (JTCK/SWCLK) | I/O | DEBUG_JTCK-SWCLK
110 | PA15 (JTDI) | I/O | DEBUG_JTDI
111 | PC10 | I/O | SDMMC1_D2
112 | PC11 | I/O | SDMMC1_D3
113 | PC12 | I/O | SDMMC1_CK
114 | PD0 | I/O | FMC_D2
115 | PD1 | I/O | FMC_D3
116 | PD2 | I/O | SDMMC1_CMD
117 | PD3 | I/O
118 | PD4 | I/O | FMC_NOE
119 | PD5 | I/O | FMC_NWE
120 | VSS | Power
121 | VDD | Power
122 | PD6 | I/O | USART2_RX
123 | PD7 | I/O | SPI1_MOSI
124 | PG9 | I/O | SPI1_MISO
125 | PG10 | I/O | SPI1_NSS
126 | PG11 | I/O | SPI1_SCK
127 | PG12 | I/O | FMC_NE4
128 | PG13 | I/O | SPI6_SCK
129 | PG14 | I/O | SPI6_MOSI
130 | VSS | Power
131 | VDD | Power
132 | PG15 | I/O | FMC_SDNCAS
133 | PB3 (JTDO/TRACESWO) | I/O | DEBUG_JTDO-SWO
134 | PB4 (NJTRST) | I/O | DEBUG_JTRST
135 | PB5 | I/O | FMC_SDCKE1
136 | PB6 | I/O | FMC_SDNE1
137 | PB7 | I/O
138 | BOOT0 | Boot
139 | PB8 | I/O | I2C4_SCL
140 | PB9 | I/O | I2C4_SDA
141 | PE0 | I/O | FMC_NBL0
142 | PE1 | I/O | FMC_NBL1
143 | PDR_ON | Reset
144 | VDD | Power
