RATsynthesizers/FXcursion-HW/HW/_Docs/New Folder (2)/pinout ioc h743zi_gui/pinout ioc h743zi_gui_alt.csv

Position | Name | Type | Signal | Label | AF0 | AF1 | AF2 | AF3 | AF4 | AF5 | AF6 | AF7 | AF8 | AF9 | AF10 | AF11 | AF12 | AF13 | AF14
1 | PE2 | I/O | QUADSPI_BK1_IO2 |  | DEBUG_TRACECLK |  | SAI1_CK1 |  |  | SPI4_SCK | SAI1_MCLK_A |  | SAI4_MCLK_A | QUADSPI_BK1_IO2 | SAI4_CK1 | ETH_TXD3 | FMC_A23
2 | PE3 | I/O |  |  | DEBUG_TRACED0 |  |  |  | TIM15_BKIN |  | SAI1_SD_B |  | SAI4_SD_B |  |  |  | FMC_A19
3 | PE4 | I/O |  |  | DEBUG_TRACED1 |  | SAI1_D2 | DFSDM1_DATIN3 | TIM15_CH1N | SPI4_NSS | SAI1_FS_A |  | SAI4_FS_A |  | SAI4_D2 |  | FMC_A20 | DCMI_D4 | LTDC_B0
4 | PE5 | I/O | FMC_A21 |  | DEBUG_TRACED2 |  | SAI1_CK2 | DFSDM1_CKIN3 | TIM15_CH1 | SPI4_MISO | SAI1_SCK_A |  | SAI4_SCK_A |  | SAI4_CK2 |  | FMC_A21 | DCMI_D6 | LTDC_G0
5 | PE6 | I/O | FMC_A22 |  | DEBUG_TRACED3 | TIM1_BKIN2 | SAI1_D1 |  | TIM15_CH2 | SPI4_MOSI | SAI1_SD_A |  | SAI4_SD_A | SAI4_D1 | SAI2_MCLK_B | TIM1_BKIN2_COMP1/TIM1_BKIN2_COMP2 | FMC_A22 | DCMI_D7 | LTDC_G1
6 | VBAT | Power
7 | PC13 | Output | GPIO_Output | MY_UI_RESET
8 | PC14-OSC32_IN (OSC32_IN) | I/O | RCC_OSC32_IN
9 | PC15-OSC32_OUT (OSC32_OUT) | I/O | RCC_OSC32_OUT
10 | PF0 | I/O | FMC_A0 |  |  |  |  |  | I2C2_SDA |  |  |  |  |  |  |  | FMC_A0
11 | PF1 | I/O | FMC_A1 |  |  |  |  |  | I2C2_SCL |  |  |  |  |  |  |  | FMC_A1
12 | PF2 | I/O | FMC_A2 |  |  |  |  |  | I2C2_SMBA |  |  |  |  |  |  |  | FMC_A2
13 | PF3 | I/O | FMC_A3 |  |  |  |  |  |  |  |  |  |  |  |  |  | FMC_A3
14 | PF4 | I/O | FMC_A4 |  |  |  |  |  |  |  |  |  |  |  |  |  | FMC_A4
15 | PF5 | I/O | FMC_A5 |  |  |  |  |  |  |  |  |  |  |  |  |  | FMC_A5
16 | VSS | Power
17 | VDD | Power
18 | PF6 | I/O | SPI5_NSS |  |  | TIM16_CH1 |  |  |  | SPI5_NSS | SAI1_SD_B | UART7_RX | SAI4_SD_B | QUADSPI_BK1_IO3
19 | PF7 | I/O | SPI5_SCK |  |  | TIM17_CH1 |  |  |  | SPI5_SCK | SAI1_MCLK_B | UART7_TX | SAI4_MCLK_B | QUADSPI_BK1_IO2
20 | PF8 | I/O | SPI5_MISO |  |  | TIM16_CH1N |  |  |  | SPI5_MISO | SAI1_SCK_B | UART7_DE/UART7_RTS | SAI4_SCK_B | TIM13_CH1 | QUADSPI_BK1_IO0
21 | PF9 | I/O | SPI5_MOSI |  |  | TIM17_CH1N |  |  |  | SPI5_MOSI | SAI1_FS_B | UART7_CTS | SAI4_FS_B | TIM14_CH1 | QUADSPI_BK1_IO1
22 | PF10 | I/O | QUADSPI_CLK |  |  | TIM16_BKIN | SAI1_D3 |  |  |  |  |  |  | QUADSPI_CLK | SAI4_D3 |  |  | DCMI_D11 | LTDC_DE
23 | PH0-OSC_IN (PH0) | I/O | RCC_OSC_IN
24 | PH1-OSC_OUT (PH1) | I/O | RCC_OSC_OUT
25 | NRST | Reset
26 | PC0 | I/O | FMC_SDNWE |  |  |  |  | DFSDM1_CKIN0 |  |  | DFSDM1_DATIN4 |  | SAI2_FS_B |  | USB_OTG_HS_ULPI_STP |  | FMC_SDNWE |  | LTDC_R5
27 | PC1 | I/O | ADC1_INP11 |  | DEBUG_TRACED0 |  | SAI1_D1 | DFSDM1_DATIN0 | DFSDM1_CKIN4 | I2S2_SDO/SPI2_MOSI | SAI1_SD_A |  | SAI4_SD_A | SDMMC2_CK | SAI4_D1 | ETH_MDC | MDIOS_MDC
28 | PC2_C | I/O | FMC_SDNE0 |  |  |  |  | DFSDM1_CKIN1 |  | I2S2_SDI/SPI2_MISO | DFSDM1_CKOUT |  |  |  | USB_OTG_HS_ULPI_DIR | ETH_TXD2 | FMC_SDNE0
29 | PC3_C | I/O | FMC_SDCKE0 |  |  |  |  | DFSDM1_DATIN1 |  | I2S2_SDO/SPI2_MOSI |  |  |  |  | USB_OTG_HS_ULPI_NXT | ETH_TX_CLK | FMC_SDCKE0
30 | VDD | Power
31 | VSSA | Power
32 | VREF+ | MonoIO
33 | VDDA | Power
34 | PA0 | I/O | UART4_TX |  |  | TIM2_CH1/TIM2_ETR | TIM5_CH1 | TIM8_ETR | TIM15_BKIN |  |  | USART2_CTS/USART2_NSS | UART4_TX | SDMMC2_CMD | SAI2_SD_B | ETH_CRS
35 | PA1 | I/O | UART4_RX |  |  | TIM2_CH2 | TIM5_CH2 | LPTIM3_OUT | TIM15_CH1N |  |  | USART2_DE/USART2_RTS | UART4_RX | QUADSPI_BK1_IO3 | SAI2_MCLK_B | ETH_REF_CLK/ETH_RX_CLK |  |  | LTDC_R2
36 | PA2 | I/O | USART2_TX |  |  | TIM2_CH3 | TIM5_CH3 | LPTIM4_OUT | TIM15_CH1 |  |  | USART2_TX | SAI2_SCK_B |  |  | ETH_MDIO | MDIOS_MDIO |  | LTDC_R1
37 | PA3 | I/O | ADC1_INP15 |  |  | TIM2_CH4 | TIM5_CH4 | LPTIM5_OUT | TIM15_CH2 |  |  | USART2_RX |  | LTDC_B2 | USB_OTG_HS_ULPI_D0 | ETH_COL |  |  | LTDC_B5
38 | VSS | Power
39 | VDD | Power
40 | PA4 | I/O | ADC1_INP18 |  |  |  | TIM5_ETR |  |  | I2S1_WS/SPI1_NSS | I2S3_WS/SPI3_NSS | USART2_CK | SPI6_NSS |  |  |  | USB_OTG_HS_SOF | DCMI_HSYNC | LTDC_VSYNC
41 | PA5 | I/O | ADC1_INP19 |  |  | TIM2_CH1/TIM2_ETR |  | TIM8_CH1N |  | I2S1_CK/SPI1_SCK |  |  | SPI6_SCK |  | USB_OTG_HS_ULPI_CK |  |  |  | LTDC_R4
42 | PA6 | I/O | ADC1_INP3 |  |  | TIM1_BKIN | TIM3_CH1 | TIM8_BKIN |  | I2S1_SDI/SPI1_MISO |  |  | SPI6_MISO | TIM13_CH1 | TIM8_BKIN_COMP1/TIM8_BKIN_COMP2 | MDIOS_MDC | TIM1_BKIN_COMP1/TIM1_BKIN_COMP2 | DCMI_PIXCLK | LTDC_G2
43 | PA7 | I/O | ADC1_INP7 |  |  | TIM1_CH1N | TIM3_CH2 | TIM8_CH1N |  | I2S1_SDO/SPI1_MOSI |  |  | SPI6_MOSI | TIM14_CH1 |  | ETH_CRS_DV/ETH_RX_DV | FMC_SDNWE
44 | PC4 | I/O | ADC1_INP4 |  |  |  |  | DFSDM1_CKIN2 |  | I2S1_MCK |  |  |  | SPDIFRX1_IN2 |  | ETH_RXD0 | FMC_SDNE0
45 | PC5 | I/O | ADC1_INP8 |  |  |  | SAI1_D3 | DFSDM1_DATIN2 |  |  |  |  |  | SPDIFRX1_IN3 | SAI4_D3 | ETH_RXD1 | FMC_SDCKE0 | COMP1_OUT
46 | PB0 | I/O | ADC1_INP9 |  |  | TIM1_CH2N | TIM3_CH3 | TIM8_CH2N |  |  | DFSDM1_CKOUT |  | UART4_CTS | LTDC_R3 | USB_OTG_HS_ULPI_D1 | ETH_RXD2 |  |  | LTDC_G1
47 | PB1 | I/O | ADC1_INP5 |  |  | TIM1_CH3N | TIM3_CH4 | TIM8_CH3N |  |  | DFSDM1_DATIN1 |  |  | LTDC_R6 | USB_OTG_HS_ULPI_D2 | ETH_RXD3 |  |  | LTDC_G0
48 | PB2 | Output | GPIO_Output | MY_GUI_PB2 | RTC_OUT_ALARM/RTC_OUT_CALIB |  | SAI1_D1 |  | DFSDM1_CKIN1 |  | SAI1_SD_A | I2S3_SDO/SPI3_MOSI | SAI4_SD_A | QUADSPI_CLK | SAI4_D1
49 | PF11 | I/O | FMC_SDNRAS |  |  |  |  |  |  | SPI5_MOSI |  |  |  |  | SAI2_SD_B |  | FMC_SDNRAS | DCMI_D12
50 | PF12 | I/O | FMC_A6 |  |  |  |  |  |  |  |  |  |  |  |  |  | FMC_A6
51 | VSS | Power
52 | VDD | Power
53 | PF13 | I/O | FMC_A7 |  |  |  |  | DFSDM1_DATIN6 | I2C4_SMBA |  |  |  |  |  |  |  | FMC_A7
54 | PF14 | I/O | FMC_A8 |  |  |  |  | DFSDM1_CKIN6 | I2C4_SCL |  |  |  |  |  |  |  | FMC_A8
55 | PF15 | I/O | FMC_A9 |  |  |  |  |  | I2C4_SDA |  |  |  |  |  |  |  | FMC_A9
56 | PG0 | I/O | FMC_A10 |  |  |  |  |  |  |  |  |  |  |  |  |  | FMC_A10
57 | PG1 | I/O | FMC_A11 |  |  |  |  |  |  |  |  |  |  |  |  |  | FMC_A11
58 | PE7 | I/O | FMC_D4 |  |  | TIM1_ETR |  | DFSDM1_DATIN2 |  |  |  | UART7_RX |  |  | QUADSPI_BK2_IO0 |  | FMC_D4/FMC_DA4
59 | PE8 | I/O | FMC_D5 |  |  | TIM1_CH1N |  | DFSDM1_CKIN2 |  |  |  | UART7_TX |  |  | QUADSPI_BK2_IO1 |  | FMC_D5/FMC_DA5 | COMP2_OUT
60 | PE9 | I/O | FMC_D6 |  |  | TIM1_CH1 |  | DFSDM1_CKOUT |  |  |  | UART7_DE/UART7_RTS |  |  | QUADSPI_BK2_IO2 |  | FMC_D6/FMC_DA6
61 | VSS | Power
62 | VDD | Power
63 | PE10 | I/O | FMC_D7 |  |  | TIM1_CH2N |  | DFSDM1_DATIN4 |  |  |  | UART7_CTS |  |  | QUADSPI_BK2_IO3 |  | FMC_D7/FMC_DA7
64 | PE11 | I/O | FMC_D8 |  |  | TIM1_CH2 |  | DFSDM1_CKIN4 |  | SPI4_NSS |  |  |  |  | SAI2_SD_B |  | FMC_D8/FMC_DA8 |  | LTDC_G3
65 | PE12 | I/O | FMC_D9 |  |  | TIM1_CH3N |  | DFSDM1_DATIN5 |  | SPI4_SCK |  |  |  |  | SAI2_SCK_B |  | FMC_D9/FMC_DA9 | COMP1_OUT | LTDC_B4
66 | PE13 | I/O | FMC_D10 |  |  | TIM1_CH3 |  | DFSDM1_CKIN5 |  | SPI4_MISO |  |  |  |  | SAI2_FS_B |  | FMC_D10/FMC_DA10 | COMP2_OUT | LTDC_DE
67 | PE14 | I/O | FMC_D11 |  |  | TIM1_CH4 |  |  |  | SPI4_MOSI |  |  |  |  | SAI2_MCLK_B |  | FMC_D11/FMC_DA11 |  | LTDC_CLK
68 | PE15 | I/O | FMC_D12 |  |  | TIM1_BKIN |  |  |  |  |  |  |  |  |  |  | FMC_D12/FMC_DA12 | TIM1_BKIN_COMP1/TIM1_BKIN_COMP2 | LTDC_R7
69 | PB10 | I/O | I2C2_SCL |  |  | TIM2_CH3 | HRTIM_SCOUT | LPTIM2_IN1 | I2C2_SCL | I2S2_CK/SPI2_SCK | DFSDM1_DATIN7 | USART3_TX |  | QUADSPI_BK1_NCS | USB_OTG_HS_ULPI_D3 | ETH_RX_ER |  |  | LTDC_G4
70 | PB11 | I/O | I2C2_SDA |  |  | TIM2_CH4 | HRTIM_SCIN | LPTIM2_ETR | I2C2_SDA |  | DFSDM1_CKIN7 | USART3_RX |  |  | USB_OTG_HS_ULPI_D4 | ETH_TX_EN |  |  | LTDC_G5
71 | VCAP | Power
72 | VDD | Power
73 | PB12 | I/O | SPI2_NSS |  |  | TIM1_BKIN |  |  | I2C2_SMBA | I2S2_WS/SPI2_NSS | DFSDM1_DATIN1 | USART3_CK |  | FDCAN2_RX | USB_OTG_HS_ULPI_D5 | ETH_TXD0 | USB_OTG_HS_ID | TIM1_BKIN_COMP1/TIM1_BKIN_COMP2 | UART5_RX
74 | PB13 | I/O | SPI2_SCK |  |  | TIM1_CH1N |  | LPTIM2_OUT |  | I2S2_CK/SPI2_SCK | DFSDM1_CKIN1 | USART3_CTS/USART3_NSS |  | FDCAN2_TX | USB_OTG_HS_ULPI_D6 | ETH_TXD1 |  |  | UART5_TX
75 | PB14 | I/O | SPI2_MISO |  |  | TIM1_CH2N | TIM12_CH1 | TIM8_CH2N | USART1_TX | I2S2_SDI/SPI2_MISO | DFSDM1_DATIN2 | USART3_DE/USART3_RTS | UART4_DE/UART4_RTS | SDMMC2_D0 |  |  | USB_OTG_HS_DM
76 | PB15 | I/O | SPI2_MOSI |  | RTC_REFIN | TIM1_CH3N | TIM12_CH2 | TIM8_CH3N | USART1_RX | I2S2_SDO/SPI2_MOSI | DFSDM1_CKIN2 |  | UART4_CTS | SDMMC2_D1 |  |  | USB_OTG_HS_DP
77 | PD8 | I/O | FMC_D13 |  |  |  |  | DFSDM1_CKIN3 |  |  | SAI3_SCK_B | USART3_TX |  | SPDIFRX1_IN1 |  |  | FMC_D13/FMC_DA13
78 | PD9 | I/O | FMC_D14 |  |  |  |  | DFSDM1_DATIN3 |  |  | SAI3_SD_B | USART3_RX |  |  |  |  | FMC_D14/FMC_DA14
79 | PD10 | I/O | FMC_D15 |  |  |  |  | DFSDM1_CKOUT |  |  | SAI3_FS_B | USART3_CK |  |  |  |  | FMC_D15/FMC_DA15 |  | LTDC_B3
80 | PD11 | I/O | QUADSPI_BK1_IO0 |  |  |  |  | LPTIM2_IN2 | I2C4_SMBA |  |  | USART3_CTS/USART3_NSS |  | QUADSPI_BK1_IO0 | SAI2_SD_A |  | FMC_A16
81 | PD12 | I/O | QUADSPI_BK1_IO1 |  |  | LPTIM1_IN1 | TIM4_CH1 | LPTIM2_IN1 | I2C4_SCL |  |  | USART3_DE/USART3_RTS |  | QUADSPI_BK1_IO1 | SAI2_FS_A |  | FMC_A17
82 | PD13 | I/O | QUADSPI_BK1_IO3 |  |  | LPTIM1_OUT | TIM4_CH2 |  | I2C4_SDA |  |  |  |  | QUADSPI_BK1_IO3 | SAI2_SCK_A |  | FMC_A18
83 | VSS | Power
84 | VDD | Power
85 | PD14 | I/O | FMC_D0 |  |  |  | TIM4_CH3 |  |  |  | SAI3_MCLK_B |  | UART8_CTS |  |  |  | FMC_D0/FMC_DA0
86 | PD15 | I/O | FMC_D1 |  |  |  | TIM4_CH4 |  |  |  | SAI3_MCLK_A |  | UART8_DE/UART8_RTS |  |  |  | FMC_D1/FMC_DA1
87 | PG2 | I/O |  |  |  |  |  | TIM8_BKIN |  |  |  |  |  |  |  | TIM8_BKIN_COMP1/TIM8_BKIN_COMP2 | FMC_A12
88 | PG3 | I/O |  |  |  |  |  | TIM8_BKIN2 |  |  |  |  |  |  |  | TIM8_BKIN2_COMP1/TIM8_BKIN2_COMP2 | FMC_A13
89 | PG4 | I/O | FMC_BA0 |  |  | TIM1_BKIN2 |  |  |  |  |  |  |  |  |  | TIM1_BKIN2_COMP1/TIM1_BKIN2_COMP2 | FMC_A14/FMC_BA0
90 | PG5 | I/O | FMC_BA1 |  |  | TIM1_ETR |  |  |  |  |  |  |  |  |  |  | FMC_A15/FMC_BA1
91 | PG6 | I/O | QUADSPI_BK1_NCS |  |  | TIM17_BKIN | HRTIM_CHE1 |  |  |  |  |  |  |  | QUADSPI_BK1_NCS |  | FMC_NE3 | DCMI_D12 | LTDC_R7
92 | PG7 | I/O |  |  |  |  | HRTIM_CHE2 |  |  |  | SAI1_MCLK_A | USART6_CK |  |  |  |  | FMC_INT | DCMI_D13 | LTDC_CLK
93 | PG8 | I/O | FMC_SDCLK |  |  |  |  | TIM8_ETR |  | SPI6_NSS |  | USART6_DE/USART6_RTS | SPDIFRX1_IN2 |  |  | ETH_PPS_OUT | FMC_SDCLK |  | LTDC_G7
94 | VSS | Power
95 | VDD33_USB | Power
96 | PC6 | Output | GPIO_Output | MY_LCD_RESET |  | HRTIM_CHA1 | TIM3_CH1 | TIM8_CH1 | DFSDM1_CKIN3 | I2S2_MCK |  | USART6_TX | SDMMC1_D0DIR | FMC_NWAIT | SDMMC2_D6 |  | SDMMC1_D6 | DCMI_D0 | LTDC_HSYNC
97 | PC7 | I/O | FMC_NE1 |  | DEBUG_TRGIO | HRTIM_CHA2 | TIM3_CH2 | TIM8_CH2 | DFSDM1_DATIN3 |  | I2S3_MCK | USART6_RX | SDMMC1_D123DIR | FMC_NE1 | SDMMC2_D7 | SWPMI1_TX | SDMMC1_D7 | DCMI_D1 | LTDC_G6
98 | PC8 | I/O | SDMMC1_D0 |  | DEBUG_TRACED1 | HRTIM_CHB1 | TIM3_CH3 | TIM8_CH3 |  |  |  | USART6_CK | UART5_DE/UART5_RTS | FMC_NCE/FMC_NE2 |  | SWPMI1_RX | SDMMC1_D0 | DCMI_D2
99 | PC9 | I/O | SDMMC1_D1 |  | RCC_MCO_2 |  | TIM3_CH4 | TIM8_CH4 | I2C3_SDA | I2S_CKIN |  |  | UART5_CTS | QUADSPI_BK1_IO0 | LTDC_G3 | SWPMI1_SUSPEND | SDMMC1_D1 | DCMI_D3 | LTDC_B2
100 | PA8 | I/O | USB_OTG_FS_SOF |  | RCC_MCO_1 | TIM1_CH1 | HRTIM_CHB2 | TIM8_BKIN2 | I2C3_SCL |  |  | USART1_CK |  |  | USB_OTG_FS_SOF | UART7_RX | TIM8_BKIN2_COMP1/TIM8_BKIN2_COMP2 | LTDC_B3 | LTDC_R6
101 | PA9 | I/O | USB_OTG_FS_VBUS |  |  | TIM1_CH2 | HRTIM_CHC1 | LPUART1_TX | I2C3_SMBA | I2S2_CK/SPI2_SCK |  | USART1_TX |  |  |  |  |  | DCMI_D0 | LTDC_R5
102 | PA10 | Input | GPIO_Input | MY_SD_DETECT |  | TIM1_CH3 | HRTIM_CHC2 | LPUART1_RX |  |  |  | USART1_RX |  |  | USB_OTG_FS_ID | MDIOS_MDIO | LTDC_B4 | DCMI_D1 | LTDC_B1
103 | PA11 | I/O | USB_OTG_FS_DM |  |  | TIM1_CH4 | HRTIM_CHD1 | LPUART1_CTS |  | I2S2_WS/SPI2_NSS | UART4_RX | USART1_CTS/USART1_NSS |  | FDCAN1_RX | USB_OTG_FS_DM |  |  |  | LTDC_R4
104 | PA12 | I/O | USB_OTG_FS_DP |  |  | TIM1_ETR | HRTIM_CHD2 | LPUART1_DE/LPUART1_RTS |  | I2S2_CK/SPI2_SCK | UART4_TX | USART1_DE/USART1_RTS | SAI2_FS_B | FDCAN1_TX | USB_OTG_FS_DP |  |  |  | LTDC_R5
105 | PA13 (JTMS/SWDIO) | I/O | DEBUG_JTMS-SWDIO |  | DEBUG_JTMS-SWDIO
106 | VCAP | Power
107 | VSS | Power
108 | VDD | Power
109 | PA14 (JTCK/SWCLK) | I/O | DEBUG_JTCK-SWCLK |  | DEBUG_JTCK-SWCLK
110 | PA15 (JTDI) | I/O | DEBUG_JTDI |  | DEBUG_JTDI | TIM2_CH1/TIM2_ETR | HRTIM_FLT1 |  | CEC | I2S1_WS/SPI1_NSS | I2S3_WS/SPI3_NSS | SPI6_NSS | UART4_DE/UART4_RTS |  |  | UART7_TX
111 | PC10 | I/O | SDMMC1_D2 |  |  |  | HRTIM_EEV1 | DFSDM1_CKIN5 |  |  | I2S3_CK/SPI3_SCK | USART3_TX | UART4_TX | QUADSPI_BK1_IO1 |  |  | SDMMC1_D2 | DCMI_D8 | LTDC_R2
112 | PC11 | I/O | SDMMC1_D3 |  |  |  | HRTIM_FLT2 | DFSDM1_DATIN5 |  |  | I2S3_SDI/SPI3_MISO | USART3_RX | UART4_RX | QUADSPI_BK2_NCS |  |  | SDMMC1_D3 | DCMI_D4
113 | PC12 | I/O | SDMMC1_CK |  | DEBUG_TRACED3 |  | HRTIM_EEV2 |  |  |  | I2S3_SDO/SPI3_MOSI | USART3_CK | UART5_TX |  |  |  | SDMMC1_CK | DCMI_D9
114 | PD0 | I/O | FMC_D2 |  |  |  |  | DFSDM1_CKIN6 |  |  | SAI3_SCK_A |  | UART4_RX | FDCAN1_RX |  |  | FMC_D2/FMC_DA2
115 | PD1 | I/O | FMC_D3 |  |  |  |  | DFSDM1_DATIN6 |  |  | SAI3_SD_A |  | UART4_TX | FDCAN1_TX |  |  | FMC_D3/FMC_DA3
116 | PD2 | I/O | SDMMC1_CMD |  | DEBUG_TRACED2 |  | TIM3_ETR |  |  |  |  |  | UART5_RX |  |  |  | SDMMC1_CMD | DCMI_D11
117 | PD3 | I/O |  |  |  |  |  | DFSDM1_CKOUT |  | I2S2_CK/SPI2_SCK |  | USART2_CTS/USART2_NSS |  |  |  |  | FMC_CLK | DCMI_D5 | LTDC_G7
118 | PD4 | I/O | FMC_NOE |  |  |  | HRTIM_FLT3 |  |  |  | SAI3_FS_A | USART2_DE/USART2_RTS |  |  |  |  | FMC_NOE
119 | PD5 | I/O | FMC_NWE |  |  |  | HRTIM_EEV3 |  |  |  |  | USART2_TX |  |  |  |  | FMC_NWE
120 | VSS | Power
121 | VDD | Power
122 | PD6 | I/O | USART2_RX |  |  |  | SAI1_D1 | DFSDM1_CKIN4 | DFSDM1_DATIN1 | I2S3_SDO/SPI3_MOSI | SAI1_SD_A | USART2_RX | SAI4_SD_A |  | SAI4_D1 | SDMMC2_CK | FMC_NWAIT | DCMI_D10 | LTDC_B2
123 | PD7 | I/O | SPI1_MOSI |  |  |  |  | DFSDM1_DATIN4 |  | I2S1_SDO/SPI1_MOSI | DFSDM1_CKIN1 | USART2_CK |  | SPDIFRX1_IN0 |  | SDMMC2_CMD | FMC_NE1
124 | PG9 | I/O | SPI1_MISO |  |  |  |  |  |  | I2S1_SDI/SPI1_MISO |  | USART6_RX | SPDIFRX1_IN3 | QUADSPI_BK2_IO2 | SAI2_FS_B |  | FMC_NCE/FMC_NE2 | DCMI_VSYNC
125 | PG10 | I/O | SPI1_NSS |  |  |  | HRTIM_FLT5 |  |  | I2S1_WS/SPI1_NSS |  |  |  | LTDC_G3 | SAI2_SD_B |  | FMC_NE3 | DCMI_D2 | LTDC_B2
126 | PG11 | I/O | SPI1_SCK |  |  | LPTIM1_IN2 | HRTIM_EEV4 |  |  | I2S1_CK/SPI1_SCK |  |  | SPDIFRX1_IN0 |  | SDMMC2_D2 | ETH_TX_EN |  | DCMI_D3 | LTDC_B3
127 | PG12 | I/O | FMC_NE4 |  |  | LPTIM1_IN1 | HRTIM_EEV5 |  |  | SPI6_MISO |  | USART6_DE/USART6_RTS | SPDIFRX1_IN1 | LTDC_B4 |  | ETH_TXD1 | FMC_NE4 |  | LTDC_B1
128 | PG13 | I/O | SPI6_SCK |  | DEBUG_TRACED0 | LPTIM1_OUT | HRTIM_EEV10 |  |  | SPI6_SCK |  | USART6_CTS/USART6_NSS |  |  |  | ETH_TXD0 | FMC_A24 |  | LTDC_R0
129 | PG14 | I/O | SPI6_MOSI |  | DEBUG_TRACED1 | LPTIM1_ETR |  |  |  | SPI6_MOSI |  | USART6_TX |  | QUADSPI_BK2_IO3 |  | ETH_TXD1 | FMC_A25 |  | LTDC_B0
130 | VSS | Power
131 | VDD | Power
132 | PG15 | I/O | FMC_SDNCAS |  |  |  |  |  |  |  |  | USART6_CTS/USART6_NSS |  |  |  |  | FMC_SDNCAS | DCMI_D13
133 | PB3 (JTDO/TRACESWO) | I/O | DEBUG_JTDO-SWO |  | DEBUG_JTDO-SWO | TIM2_CH2 | HRTIM_FLT4 |  |  | I2S1_CK/SPI1_SCK | I2S3_CK/SPI3_SCK |  | SPI6_SCK | SDMMC2_D2 | CRS_SYNC | UART7_RX
134 | PB4 (NJTRST) | I/O | DEBUG_JTRST |  |  | TIM16_BKIN | TIM3_CH1 | HRTIM_EEV6 |  | I2S1_SDI/SPI1_MISO | I2S3_SDI/SPI3_MISO | I2S2_WS/SPI2_NSS | SPI6_MISO | SDMMC2_D3 |  | UART7_TX
135 | PB5 | I/O | FMC_SDCKE1 |  |  | TIM17_BKIN | TIM3_CH2 | HRTIM_EEV7 | I2C1_SMBA | I2S1_SDO/SPI1_MOSI | I2C4_SMBA | I2S3_SDO/SPI3_MOSI | SPI6_MOSI | FDCAN2_RX | USB_OTG_HS_ULPI_D7 | ETH_PPS_OUT | FMC_SDCKE1 | DCMI_D10 | UART5_RX
136 | PB6 | I/O | FMC_SDNE1 |  |  | TIM16_CH1N | TIM4_CH1 | HRTIM_EEV8 | I2C1_SCL | CEC | I2C4_SCL | USART1_TX | LPUART1_TX | FDCAN2_TX | QUADSPI_BK1_NCS | DFSDM1_DATIN5 | FMC_SDNE1 | DCMI_D5 | UART5_TX
137 | PB7 | I/O |  |  |  | TIM17_CH1N | TIM4_CH2 | HRTIM_EEV9 | I2C1_SDA |  | I2C4_SDA | USART1_RX | LPUART1_RX |  |  | DFSDM1_CKIN5 | FMC_NL | DCMI_VSYNC
138 | BOOT0 | Boot
139 | PB8 | I/O | I2C4_SCL |  |  | TIM16_CH1 | TIM4_CH3 | DFSDM1_CKIN7 | I2C1_SCL |  | I2C4_SCL | SDMMC1_CKIN | UART4_RX | FDCAN1_RX | SDMMC2_D4 | ETH_TXD3 | SDMMC1_D4 | DCMI_D6 | LTDC_B6
140 | PB9 | I/O | I2C4_SDA |  |  | TIM17_CH1 | TIM4_CH4 | DFSDM1_DATIN7 | I2C1_SDA | I2S2_WS/SPI2_NSS | I2C4_SDA | SDMMC1_CDIR | UART4_TX | FDCAN1_TX | SDMMC2_D5 | I2C4_SMBA | SDMMC1_D5 | DCMI_D7 | LTDC_B7
141 | PE0 | I/O | FMC_NBL0 |  |  | LPTIM1_ETR | TIM4_ETR | HRTIM_SCIN | LPTIM2_ETR |  |  |  | UART8_RX |  | SAI2_MCLK_A |  | FMC_NBL0 | DCMI_D2
142 | PE1 | I/O | FMC_NBL1 |  |  | LPTIM1_IN2 |  | HRTIM_SCOUT |  |  |  |  | UART8_TX |  |  |  | FMC_NBL1 | DCMI_D3
143 | PDR_ON | Reset
144 | VDD | Power
