RATsynthesizers/FXcursion-HW/common docs/закупки на 14.09.25.ods

date | item | price | group | comment | financed
06.09 | SW rings | 115 | keybd
06.09 | Keys for keybd | 147 | keybd | sample
06.09 | RGB ws2812 2020 | 376 | keybd
06.09 | FFC 24p bottom contact | 385 | keybd
01.09 | stm32f103c4t6 | 360 | keybd
21.08 | stm32f103c6t6 | 112 | keybd
 | 1n4148 sod-123 | 57 | keybd
-------------- | -------------- | -------------- | -------------- | --------------
 | TOTAL: | 1552
30.08 | Push SW DPDT | 63 | modular
30.08 | Push SW cap | 37 | modular
06.09 | Rotary SW | 92 | modular | sample
06.09 | IDC 10 | 79 | modular
06.09 | pls 2x40 | 136 | modular
06.09 | IDC 10 female | 93 | modular
06.09 | Jack 6.3mm korp | 57 | modular | sample
06.09 | SP12T rotary sw | 83 | modular | sample
06.09 | Push SW DPDT | 60 | modular
06.09 | галетный toggle | 150 | modular | sample
21.08 | pots 9mm 100k & 10k & 50k | 117 | modular
 | галетный toggle | 206 | modular
 | pbs 2x3 | 549 | modular
 | rotary SW | 296 | modular
 | pld 2x3 2mm | 312 | modular | waste
05.08 | stm32f103rct6 | 832 | modular | future
22.08 | chipdip | 872 | modular | caps res
-------------- | -------------- | -------------- | -------------- | --------------
 | TOTAL: | 4034
30.08 | Sd-sniffer | 96 | pedal
30.08 | Kailh LP SW | 3359 | pedal
06.09 | Slide SW | 165 | pedal
06.09 | FFC pcb adapter | 71 | pedal
06.09 | FFC pcb adapter | 63 | pedal
06.09 | FFC pcb adapter | 60 | pedal
06.09 | FFC pcb adapter | 77 | pedal
06.09 | pbs 1x6 | 84 | pedal
06.09 | 8 MHz | 115 | pedal
06.09 | стойки платик | 100 | pedal
06.09 | pls 1x40 | 88 | pedal
06.09 | AMS 3v3 | 106 | pedal
06.09 | sw on/off pins | 73 | pedal | sample
06.09 | sw on/off | 68 | pedal | sample
06.09 | KLS SPDT sw | 121 | pedal
06.09 | Encoder 12.5mm 20pos | 156 | pedal
21.08 | XLR | 163 | pedal | sample
21.08 | trimpots 10k & 1meg | 188 | pedal | future
21.08 | XLR | 140 | pedal | sample
21.08 | Jacks 6.3mm | 375 | pedal
18.08 | Nucleo F743ZIT | 4794 | pedal
 | power module 1w | 372 | pedal | modular
24.07 | RGB ws2812 2020 | 323 | pedal | keybd
26.08 | chipdip | 1120 | pedal
21.08 | CHIPdip | 1259 | pedal | maket
20.10.24 | chipdip | 5510 | pedal | stm32h743zit
22.08 | rezonit | 8566 | pedal | maket
-------------- | -------------- | -------------- | -------------- | --------------
 | TOTAL: | 27612
06.09 | pls 1x40 angle | 83 |  | future
06.09 | кабель для диска | 65
21.08 | USB module | 150 |  | future
21.08 | magnetic encoder module | 98 |  | future
09.08 | slide SW | 64 |  | future
-------------- | -------------- | -------------- | -------------- | --------------
 | TOTAL: | 460
-------------------------------------------------------------
receiveed
07.08 | на хлр, изол питальники и джеки | 2000
-------------- | -------------- | -------------- | -------------- | --------------
18.Sep | чид микры для тьюритга | 1475 | modular
18.Sep | али микры тьюринг | 687 | modular
Закуп на макет гуи
17.11 | чид детали и разъёмы | 717
17.11 | али экран | 589
17.11 | али нуклео H743ZIT | 4028
17.11 | али жала паяльника | 233
-------------- | -------------- | -------------- | -------------- | --------------
 | TOTAL: | 5567
