RATsynthesizers/FXcursion-HW/common docs/BOM tepl tutorial.txt

https://youtu.be/PqFtSpAXB9Q?si=GuggSsbu07vH1htT&t=5349
