RATsynthesizers/FXcursion-HW/3d tmp/Assembly6/assebly6_1_bomScrew.txt

===Винтики===шпунтики:====

----- loop led ------
o m2.5x3     x2
o m2.5x3c    x2
l m2.5x6.3   x2
----- usb -----------
o m2.5x3     x6
l m2.5x11    x3
----- disp ----------
o m2.5x3     x4
l m2.5x4     x4
----- codec ---------
o m3x10      x5
l m3x4       x5
----- filt ----------
o m3x4       x5
l m3x6.5     x5
----- battery -------
o m3x8c      x4
l m3x3       x4
l m3x6.5     x4
----- main ----------
o m3x10      x7
o m3x8c      x7
grover m3    x7
l m3x36      x7
----- xlr -----------
o m3x8c      x8
l m3x24      x4
----- bottom --------
o m3x8c      x21

======total==========
-----------om2.5----
o m2.5x3c    x12
o m2.5x4     x4
o m2.5x6.3   x5
-----------om3------
o m3x4       x10
o m3x8c      x19+21
o m3x10      x12
-----------gr3------
grover m3    x7
-----------lm2.5----
l m2.5x4     x4
l m2.5x6.3
l m2.5x11    x2
-----------lm3------
l m3x3       x4
l m3x4       x5
l m3x6.5     x5
l m3x24      x4
l m3x36      x7
=====================

===внешние штуки:====
шайб энк    x5
шайб пот    x?
держ xlr    x1
кноп pad    x4
ножк рез    x2
держ нож    x2
держ стнд   x1

кноб мал    x5
кноб бол    x1
кноп мал    x5
кноп квд    x1
кноп бол    x2
                
световод    x1
свет xlr    x8
стекло      x1
кноп вкл    x1
