RATsynthesizers/FXcursion-HW/3D/Common parts/screws/Metric Socket Countersunk Screws/M2.5/Render.png

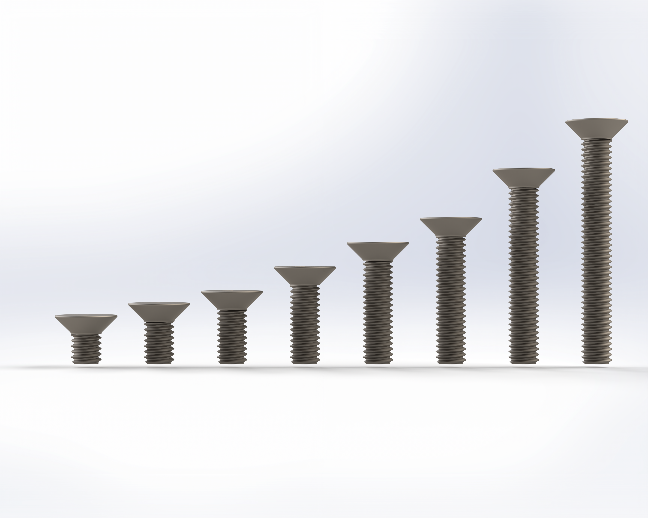
3D/Common parts/screws/Metric Socket Countersunk Screws/M2.5/Render.png
