RATsynthesizers/FXcursion-HW/3D/Common parts/Standoffs/male-female/Standoffs mf.png

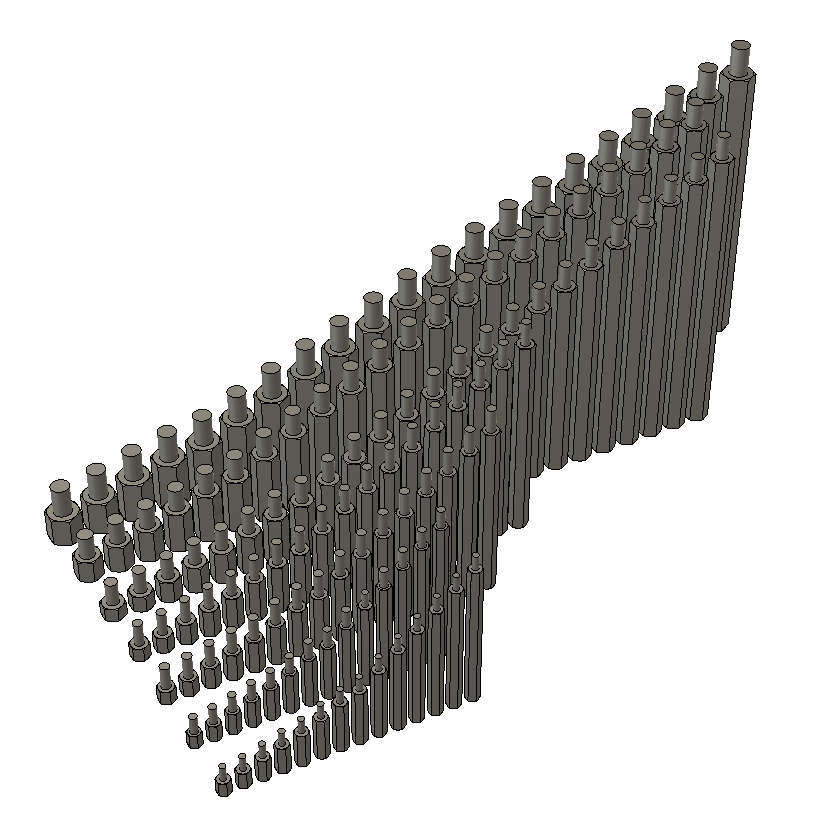
3D/Common parts/Standoffs/male-female/Standoffs mf.png
