RATsynthesizers/FXcursion-HW/3D/Common parts/tmp/18650-retainers-1.snapshot.4/18650 Retainers.PNG

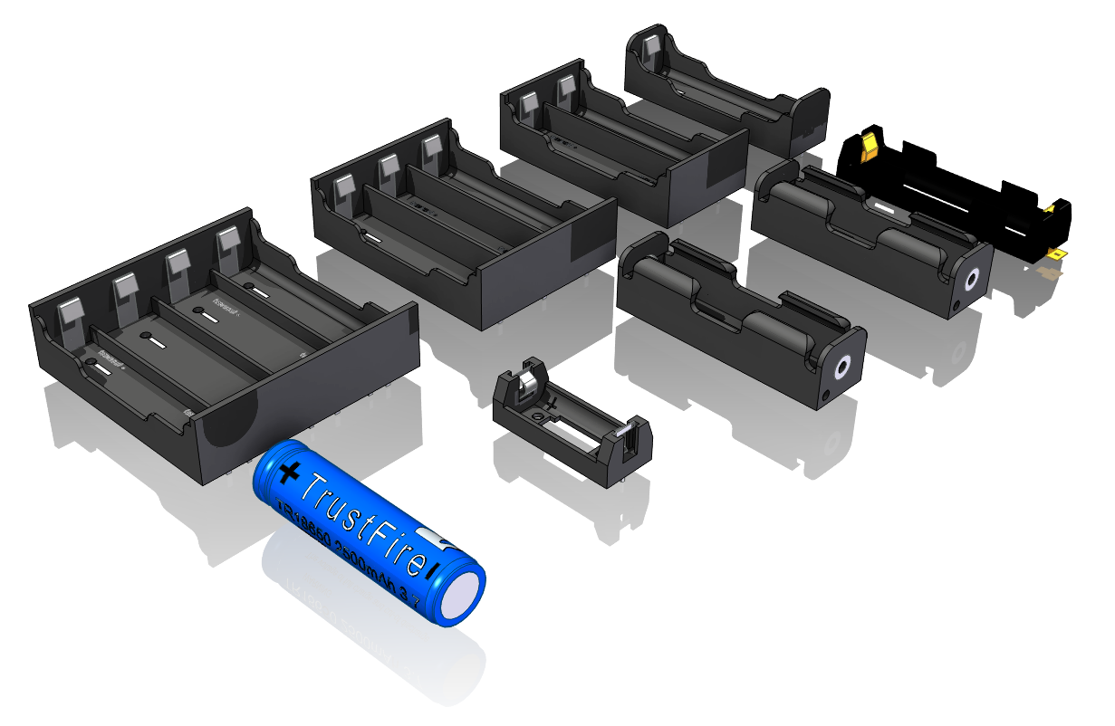
3D/Common parts/tmp/18650-retainers-1.snapshot.4/18650 Retainers.PNG
