RATsynthesizers/FXcursion-HW/3D/Common parts/tmp/cad-library_m3-m12-socket-head-cap-screw-1.snapshot.4/Socket Head Cap Screw_M3~M12__01.jpg

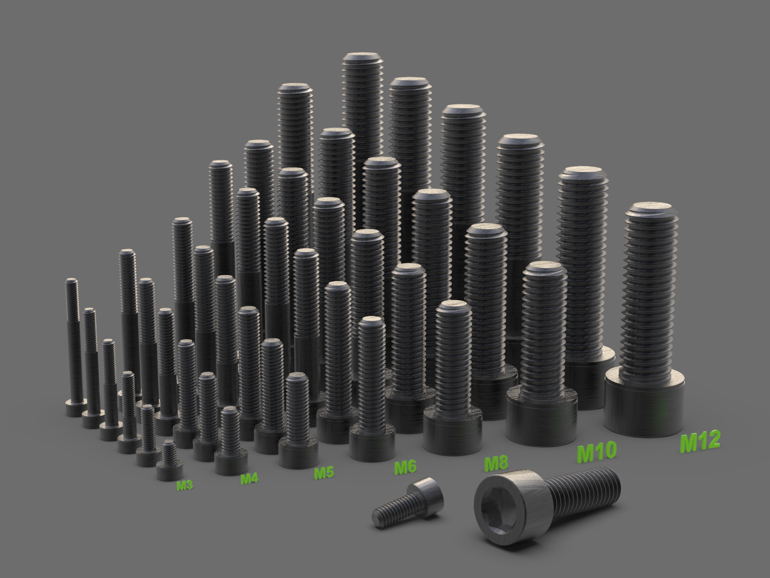
3D/Common parts/tmp/cad-library_m3-m12-socket-head-cap-screw-1.snapshot.4/Socket Head Cap Screw_M3~M12__01.jpg
