RATsynthesizers/FXcursion-HW/3D/Common parts/tmp/m3-allen-bolt-socket-cap-various-lenghts-1.snapshot.23/Renderings/M3.jpg

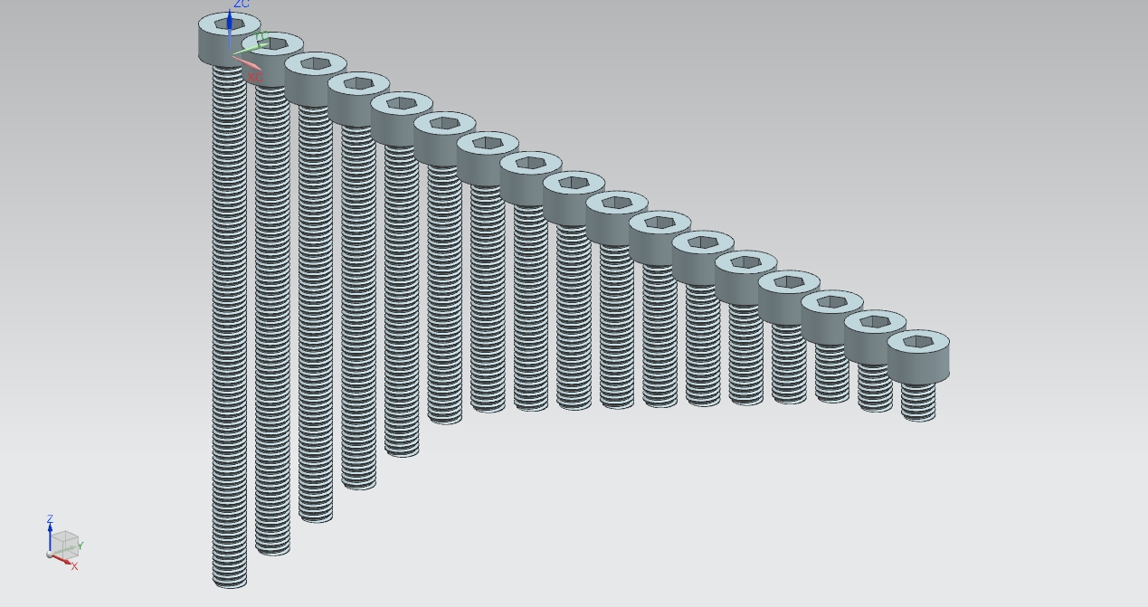
3D/Common parts/tmp/m3-allen-bolt-socket-cap-various-lenghts-1.snapshot.23/Renderings/M3.jpg
