RATsynthesizers/FXcursion-HW/3D/Common parts/tmp/m3-metric-socket-cap-head-screws-1.snapshot.11/Metric Socket Cap Head Screws/M3/Render.png

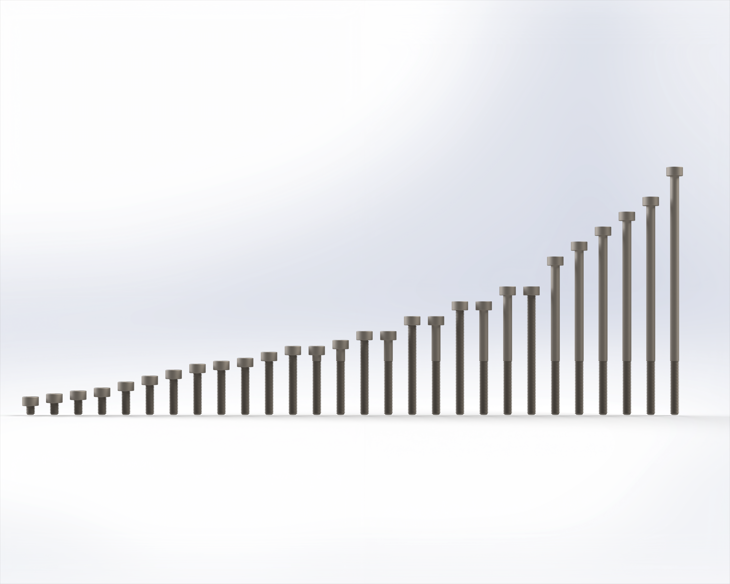
3D/Common parts/tmp/m3-metric-socket-cap-head-screws-1.snapshot.11/Metric Socket Cap Head Screws/M3/Render.png
