RATsynthesizers/FXcursion-HW/3d tmp/3d for picture/main pcb outline.dxf

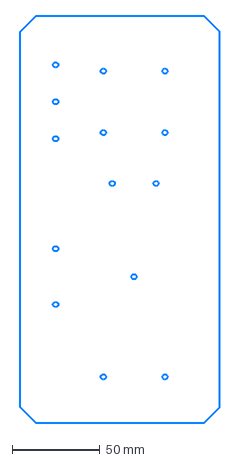
[picture p20: CAD file, 2025-07-26]
3d tmp/3d for picture/main pcb outline.dxf
113.5 x 231.3 mm
