RATsynthesizers/FXcursion-HW/3d tmp/print/main standoff holder.stl

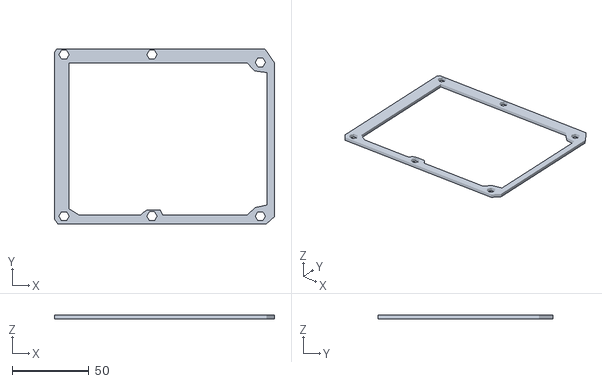
[picture p21: CAD file, 2026-10-26]
3d tmp/print/main standoff holder.stl
143.3 x 113.9 x 2.50
