RATsynthesizers/FXcursion-HW/3d tmp/Assembly6/step/solidworks/stupid_test/Assem1_ms.SLDASM

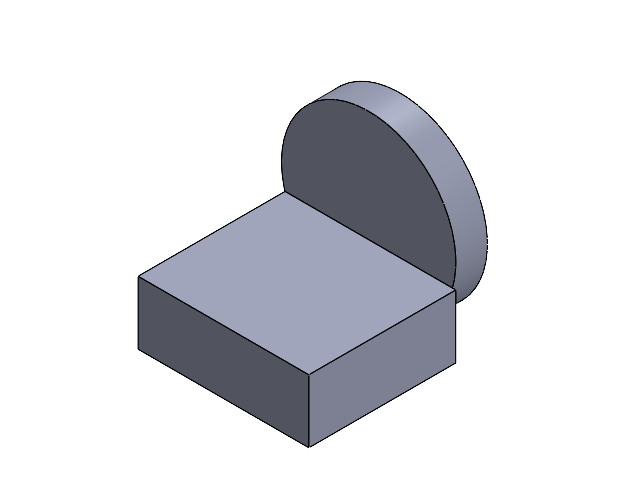
[picture p22: CAD file, 2026-04-04]
3d tmp/Assembly6/step/solidworks/stupid_test/Assem1_ms.SLDASM
ISO 7380-1 M3x4mm v7
