RATsynthesizers/FXcursion-HW/(list of files, cad)

Other CAD files:
HW/_3D/pcb's/3D_design_approx/New folder (16)/Pedal_SD_USB.SLDASM
HW/_3D/pcb's/Batteries/New folder/ENC4_1.step.SLDASM
3d tmp/Assembly6/step/solidworks/main standoff holder.stp
HW/_3D/pcb's/Batteries/New folder/C64_1.step.SLDASM
HW/_3D/pcb's/Batteries/New folder/DS1023-1x6SF11_1.step.SLDASM
HW/_3D/pcb's/Batteries/New folder/R56_1.step.SLDASM
HW/_3D/pcb's/Batteries/New folder/R84_1.step.SLDASM
HW/_3D/pcb's/Batteries/New folder/Y3_1.step.SLDASM
HW/_3D/pcb's/Batteries/New folder/C68_1.step.SLDASM
HW/_3D/pcb's/Batteries/New folder/MH11_1.step.SLDASM
HW/_3D/pcb's/Batteries/New folder/ENC5_1.step.SLDASM
HW/_3D/pcb's/Batteries/New folder/C7_1.step.SLDASM
HW/_3D/pcb's/Batteries/New folder/R86_1.step.SLDASM
HW/_3D/pcb's/Batteries/New folder/IC11_IC102_1.step.SLDASM
HW/_3D/pcb's/Batteries/New folder/Board_2.step.SLDASM
HW/_3D/pcb's/Batteries/New folder/C69_1.step.SLDASM
HW/_3D/pcb's/Batteries/New folder/R26_1.step.SLDASM
HW/_3D/pcb's/Batteries/New folder/R156_1.step.SLDASM
HW/_3D/pcb's/Batteries/New folder/C63_1.step.SLDASM
HW/_3D/pcb's/Batteries/New folder/D1_1.step.SLDASM
HW/_3D/pcb's/Batteries/New folder/C88_1.step.SLDASM
HW/_3D/pcb's/Batteries/New folder/C92_1.step.SLDASM
HW/_3D/pcb's/Batteries/New folder/R12_1.step.SLDASM
HW/_3D/pcb's/Batteries/New folder/R125_1.step.SLDASM
HW/_3D/pcb's/Batteries/New folder/C40_1.step.SLDASM
HW/_3D/pcb's/Batteries/New folder/MH10_1.step.SLDASM
HW/_3D/pcb's/Batteries/New folder/R67_1.step.SLDASM
HW/_3D/pcb's/Batteries/New folder/R33_1.step.SLDASM
HW/_3D/pcb's/Batteries/New folder/J20_1.step.SLDASM
HW/_3D/pcb's/Batteries/New folder/C37_1.step.SLDASM
HW/_3D/pcb's/Batteries/New folder/R49_IC103_1.step.SLDASM
HW/_3D/pcb's/Batteries/New folder/C74_1.step.SLDASM
HW/_3D/pcb's/Batteries/New folder/C34_1.step.SLDASM
HW/_3D/pcb's/Batteries/New folder/R154_1.step.SLDASM
HW/_3D/pcb's/Batteries/New folder/C29_1.step.SLDASM
HW/_3D/pcb's/Batteries/New folder/R11_1.step.SLDASM
HW/_3D/pcb's/Batteries/New folder/R40_1.step.SLDASM
HW/_3D/pcb's/Batteries/New folder/R49_IC102_1.step.SLDASM
HW/_3D/pcb's/Batteries/New folder/R104_1.step.SLDASM
HW/_3D/pcb's/Batteries/New folder/FB2_1.step.SLDASM
HW/_3D/pcb's/Batteries/New folder/Q3_1.step.SLDASM
HW/_3D/pcb's/Batteries/New folder/R19_1.step.SLDASM
HW/_3D/pcb's/Batteries/New folder/R8_1.step.SLDASM
HW/_3D/pcb's/Batteries/New folder/R55_1.step.SLDASM
HW/_3D/pcb's/Batteries/New folder/SMD DIP-6_1.step.SLDASM
HW/_3D/pcb's/Batteries/New folder/C11_1.step.SLDASM
HW/_3D/pcb's/Batteries/New folder/R38_1.step.SLDASM
HW/_3D/pcb's/Batteries/New folder/Q2_1.step.SLDASM
HW/_3D/pcb's/Batteries/New folder/IC11_IC103_1.step.SLDASM
HW/_3D/pcb's/Batteries/New folder/ENC2_1.step.SLDASM
HW/_3D/pcb's/Batteries/New folder/D4_1.step.SLDASM
HW/_3D/pcb's/Batteries/New folder/C10_1.step.SLDASM
HW/_3D/pcb's/Batteries/New folder/JK1_1.step.SLDASM
HW/_3D/pcb's/Batteries/New folder/R18_1.step.SLDASM
HW/_3D/pcb's/Batteries/New folder/C50_1.step.SLDASM
HW/_3D/pcb's/Batteries/New folder/R65_1.step.SLDASM
HW/_3D/pcb's/Batteries/New folder/C41_1.step.SLDASM
HW/_3D/pcb's/Batteries/New folder/C54_1.step.SLDASM
HW/_3D/pcb's/Batteries/New folder/IC2_1.step.SLDASM
HW/_3D/pcb's/Batteries/New folder/C15_1.step.SLDASM
HW/_3D/pcb's/Batteries/New folder/C97_1.step.SLDASM
HW/_3D/pcb's/Batteries/New folder/R62_1.step.SLDASM
HW/_3D/pcb's/Batteries/New folder/R57_1.step.SLDASM
HW/_3D/pcb's/Batteries/New folder/C47_1.step.SLDASM
HW/_3D/pcb's/Batteries/New folder/R54_1.step.SLDASM
HW/_3D/pcb's/Batteries/New folder/Q4_1.step.SLDASM
HW/_3D/pcb's/Batteries/New folder/R48_IC102_1.step.SLDASM
HW/_3D/pcb's/Batteries/New folder/R76_1.step.SLDASM
HW/_3D/pcb's/Batteries/New folder/C93_1.step.SLDASM
HW/_3D/pcb's/Batteries/New folder/C2_1.step.SLDASM
HW/_3D/pcb's/Batteries/New folder/IC4_1.step.SLDASM
HW/_3D/pcb's/Batteries/New folder/IC11_IC104_1.step.SLDASM
HW/_3D/pcb's/Batteries/New folder/C27_1.step.SLDASM
HW/_3D/pcb's/Batteries/New folder/C77_IC102_1.step.SLDASM
HW/_3D/pcb's/Batteries/New folder/R47_IC102_1.step.SLDASM
HW/_3D/pcb's/Batteries/New folder/B3.SLDASM
HW/_3D/pcb's/Batteries/New folder/U5_1.step.SLDASM
HW/_3D/pcb's/Batteries/New folder/C79_IC104_1.step.SLDASM
HW/_3D/pcb's/Batteries/New folder/MH7_1.step.SLDASM
HW/_3D/pcb's/Batteries/New folder/R30_1.step.SLDASM
HW/_3D/pcb's/Batteries/New folder/FB4_1.step.SLDASM
HW/_3D/pcb's/Batteries/New folder/C75_1.step.SLDASM
HW/_3D/pcb's/Batteries/New folder/R5_1.step.SLDASM
HW/_3D/pcb's/Batteries/New folder/H1_2.step.SLDASM
HW/_3D/pcb's/Batteries/New folder/R128_1.step.SLDASM
HW/_3D/pcb's/Batteries/New folder/IC16_1.step.SLDASM
HW/_3D/pcb's/Batteries/New folder/R63_1.step.SLDASM
HW/_3D/pcb's/Batteries/New folder/R25_1.step.SLDASM
HW/_3D/pcb's/Batteries/New folder/SW3_1.step.SLDASM
HW/_3D/pcb's/Batteries/New folder/R132_1.step.SLDASM
HW/_3D/pcb's/Batteries/New folder/R6_1.step.SLDASM
HW/_3D/pcb's/Batteries/New folder/C49_1.step.SLDASM
HW/_3D/pcb's/Batteries/New folder/C26_1.step.SLDASM
HW/_3D/pcb's/Batteries/New folder/R127_1.step.SLDASM
HW/_3D/pcb's/Batteries/New folder/R49_IC101_1.step.SLDASM
HW/_3D/pcb's/Batteries/New folder/C8_1.step.SLDASM
HW/_3D/pcb's/Batteries/New folder/R157_1.step.SLDASM
HW/_3D/pcb's/Batteries/New folder/R141_1.step.SLDASM
HW/_3D/pcb's/Batteries/New folder/Y2_1.step.SLDASM
HW/_3D/pcb's/Batteries/New folder/R82_1.step.SLDASM
HW/_3D/pcb's/Batteries/New folder/MH7_2.step.SLDASM
HW/_3D/pcb's/Batteries/New folder/C45_1.step.SLDASM
HW/_3D/pcb's/Batteries/New folder/C87_1.step.SLDASM
HW/_3D/pcb's/Batteries/New folder/R35_1.step.SLDASM
HW/_3D/pcb's/Batteries/New folder/R23_1.step.SLDASM
HW/_3D/pcb's/Batteries/New folder/MH13_1.step.SLDASM
HW/_3D/pcb's/Batteries/New folder/C18_1.step.SLDASM
HW/_3D/pcb's/Batteries/New folder/R149_1.step.SLDASM
HW/_3D/pcb's/Batteries/New folder/PJ2_1.step.SLDASM
HW/_3D/pcb's/Batteries/New folder/C77_IC103_1.step.SLDASM
HW/_3D/pcb's/Batteries/New folder/IC8_1.step.SLDASM
HW/_3D/pcb's/Batteries/New folder/MH10_2.step.SLDASM
HW/_3D/pcb's/Batteries/New folder/R43_1.step.SLDASM
HW/_3D/pcb's/Batteries/New folder/R21_1.step.SLDASM
HW/_3D/pcb's/Batteries/New folder/MH6_1.step.SLDASM
HW/_3D/pcb's/Batteries/New folder/R155_1.step.SLDASM
HW/_3D/pcb's/Batteries/New folder/J10_1.step.SLDASM
HW/_3D/pcb's/Batteries/New folder/R107_1.step.SLDASM
HW/_3D/pcb's/Batteries/New folder/R4_1.step.SLDASM
HW/_3D/pcb's/Batteries/New folder/SC-59A_1.step.SLDASM
HW/_3D/pcb's/Batteries/New folder/C72_1.step.SLDASM
HW/_3D/pcb's/Batteries/New folder/U1_1.step.SLDASM
HW/_3D/pcb's/Batteries/New folder/R77_1.step.SLDASM
HW/_3D/pcb's/Batteries/New folder/C22_1.step.SLDASM
HW/_3D/pcb's/Batteries/New folder/R37_1.step.SLDASM
HW/_3D/pcb's/Batteries/New folder/R16_1.step.SLDASM
HW/_3D/pcb's/Batteries/New folder/EC11B-SW-Vert-15F-blue_1.step.SLDASM
HW/_3D/pcb's/Batteries/New folder/J12_1.step.SLDASM
HW/_3D/pcb's/Batteries/New folder/IC19_1.step.SLDASM
HW/_3D/pcb's/Batteries/New folder/R15_1.step.SLDASM
HW/_3D/pcb's/Batteries/New folder/U6_1.step.SLDASM
HW/_3D/pcb's/Batteries/New folder/R49_IC105_1.step.SLDASM
HW/_3D/pcb's/Batteries/New folder/C77_IC101_1.step.SLDASM
HW/_3D/pcb's/Batteries/New folder/C78_IC104_1.step.SLDASM
HW/_3D/pcb's/Batteries/New folder/R73_1.step.SLDASM
HW/_3D/pcb's/Batteries/New folder/SW6_1.step.SLDASM
HW/_3D/pcb's/Batteries/New folder/C6_1.step.SLDASM
HW/_3D/pcb's/Batteries/New folder/IC17_1.step.SLDASM
HW/_3D/pcb's/Batteries/New folder/C21_1.step.SLDASM
HW/_3D/pcb's/Batteries/New folder/R130_1.step.SLDASM
HW/_3D/pcb's/Batteries/New folder/L2_1.step.SLDASM
HW/_3D/pcb's/Batteries/New folder/C1_1.step.SLDASM
HW/_3D/pcb's/Batteries/New folder/R139_1.step.SLDASM
HW/_3D/pcb's/Batteries/New folder/C80_1.step.SLDASM
HW/_3D/pcb's/Batteries/New folder/C59_1.step.SLDASM
HW/_3D/pcb's/Batteries/New folder/J11_1.step.SLDASM
3D/Common parts/Standoffs/male-female/Standoff mf - M2 x 10 across flats 4mm.step
3D/Common parts/Standoffs/male-female/Standoff mf - M2 x 12 across flats 4mm.step
3D/Common parts/Standoffs/male-female/Standoff mf - M2 x 15 across flats 4mm.step
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
