RATsynthesizers/FXcursion-HW/3d tmp/Assembly5/real_time_Assembly51.jpg

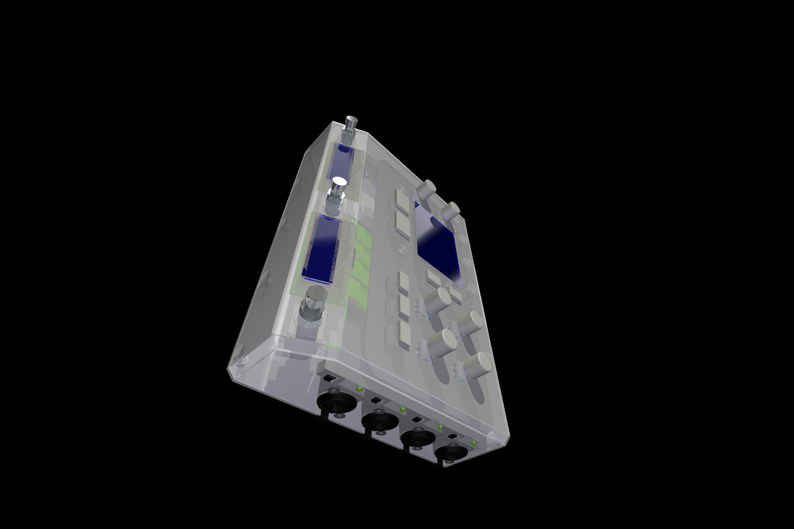
3d tmp/Assembly5/real_time_Assembly51.jpg
