RATsynthesizers/FXcursion-HW/3d tmp/Assembly6/photo_CurrSnapshot1.png

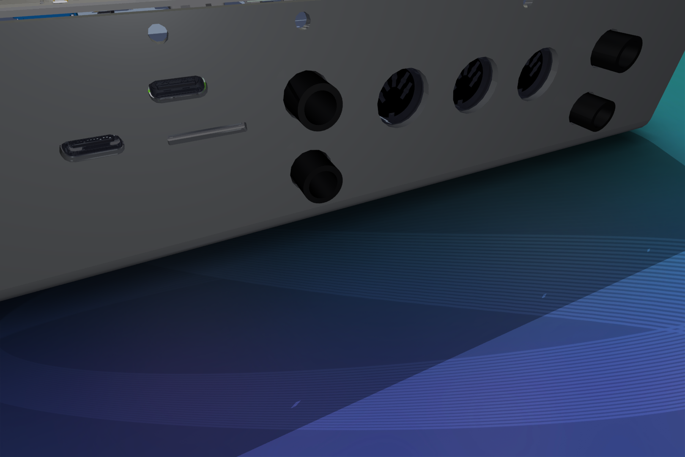
3d tmp/Assembly6/photo_CurrSnapshot1.png
