RATsynthesizers/FXcursion-HW/3d tmp/Assembly6/photo_CurrSnapshot2.png

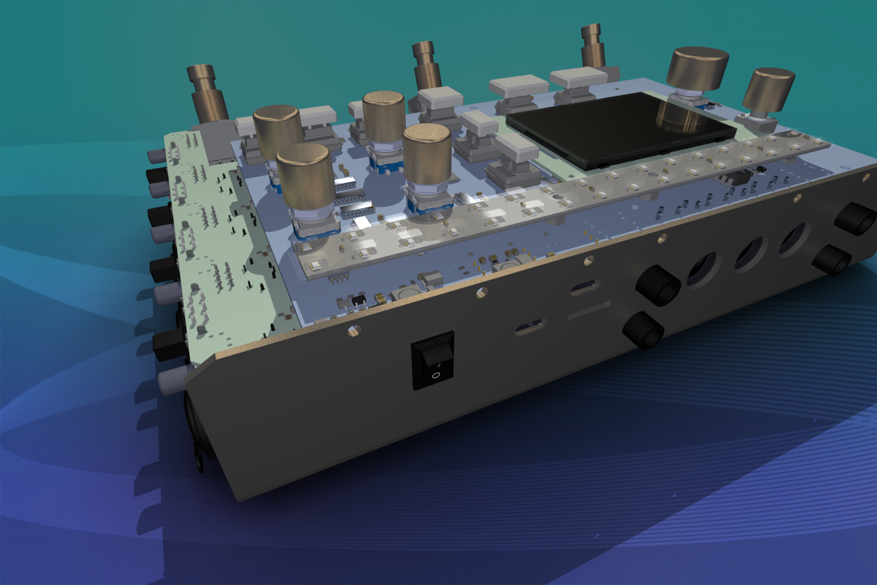
3d tmp/Assembly6/photo_CurrSnapshot2.png
