RATsynthesizers/FXcursion-HW/3d tmp/Assembly6/photo_CurrSnapshot.png

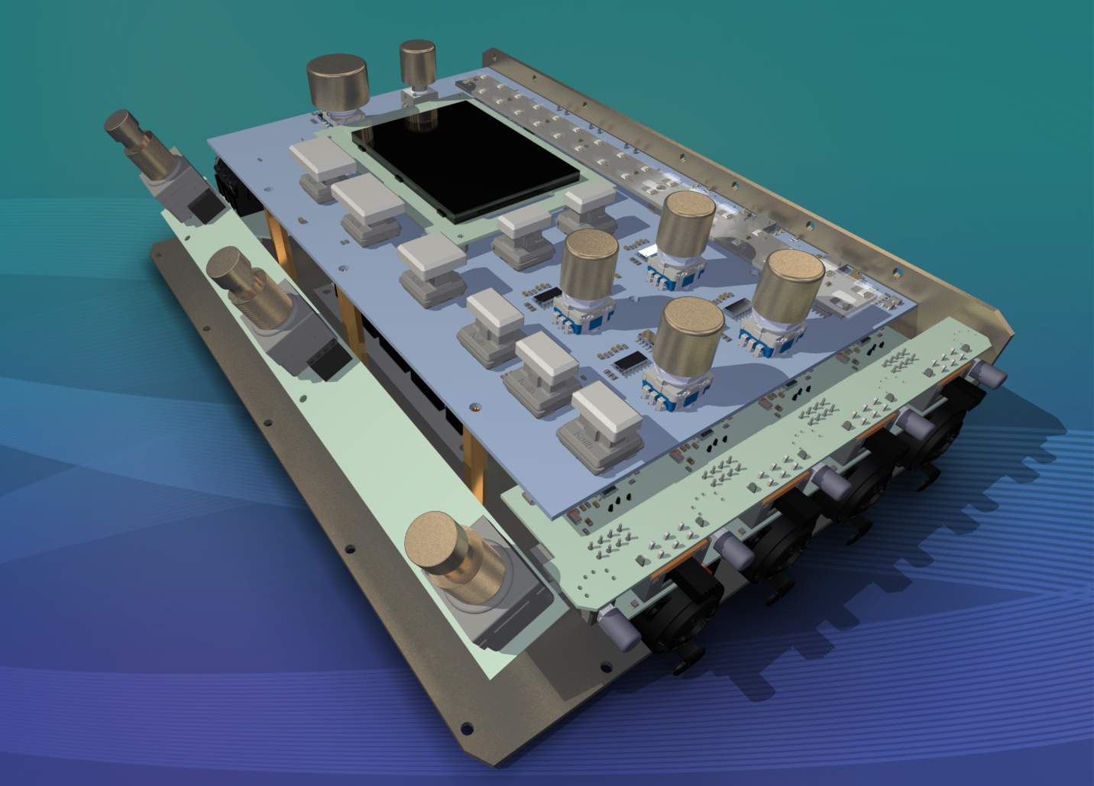
3d tmp/Assembly6/photo_CurrSnapshot.png
