RATsynthesizers/FXcursion-HW/3d tmp/Assembly6/real_time_Assembly62.jpg

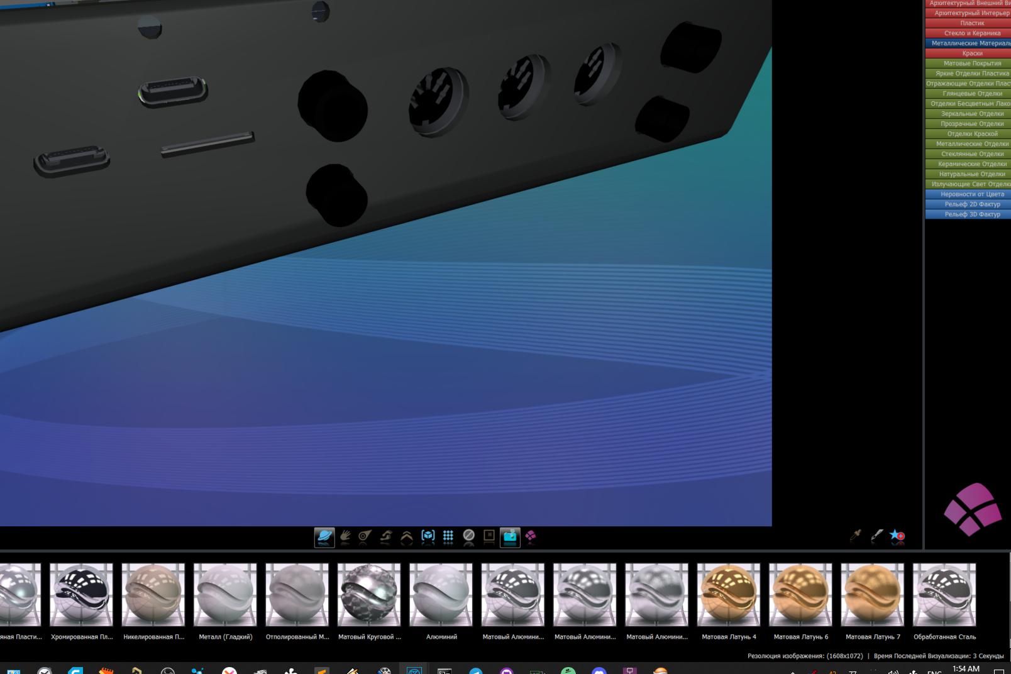
3d tmp/Assembly6/real_time_Assembly62.jpg
