RATsynthesizers/FXcursion-HW/HW/Audio_testboard/Audio_testboard.PcbDoc.htm

Reporting Options

# File in Newer Format

Date | : | 20.07.2026
Time | : | 18:35:37
Filename | : | C:\Users\romte\Desktop\FXcursion-HW\HW\Audio_testboard\Audio_testboard.PcbDoc

Version | Warning
Release 23.6 | CAUTION - The PCB document contains Footprint parameters. These will be lost when opening the document in a version of Altium Designer that does not support this functionality.

This file was generated by a later version of the software
