RATsynthesizers/FXcursion-HW/HW/Audio_testboard/aydio testboard pinout.ods

SAI1_SD_A | PE6
SAI1_SD_B | PE3
SAI1_FS | PE4
SAI1_SCK | PE5
SAI1_MCLK | PE2
SAI2_SD_A | PD11
SAI2_SD_B | PA0
I2S_CKIN | PC9
SPI2_MOSI | PB15
SPI2_MISO | PB14
SPI2_SCK | PB13
SPI2_NSS | PB12
I2S3_SDI | PC11
I2S3_SDO | PC12
I2S3_WS | PA15
I2S3_CK | PC10
I2S3_MCK | PC7
I2C1_SDA | PB9
I2C1_SCL | PB8
GPIO1 | PC13
GPIO2 | PC14
UART2 RX | PA3 | M
UART2 TX | PA2
SPI1_MOSI | PD7
SPI1_MISO | PG9
SPI1_SCK | PG11
SPI1_NSS | PG10
UART1 RX | PA10
UART1 TX | PA9 | O
DBG1 | PA12 | O
DBG2 | PA11 | O
FMC????
