RATsynthesizers/FXcursion-HW/HW/3D_design_approx/Pedal_MB.pdf

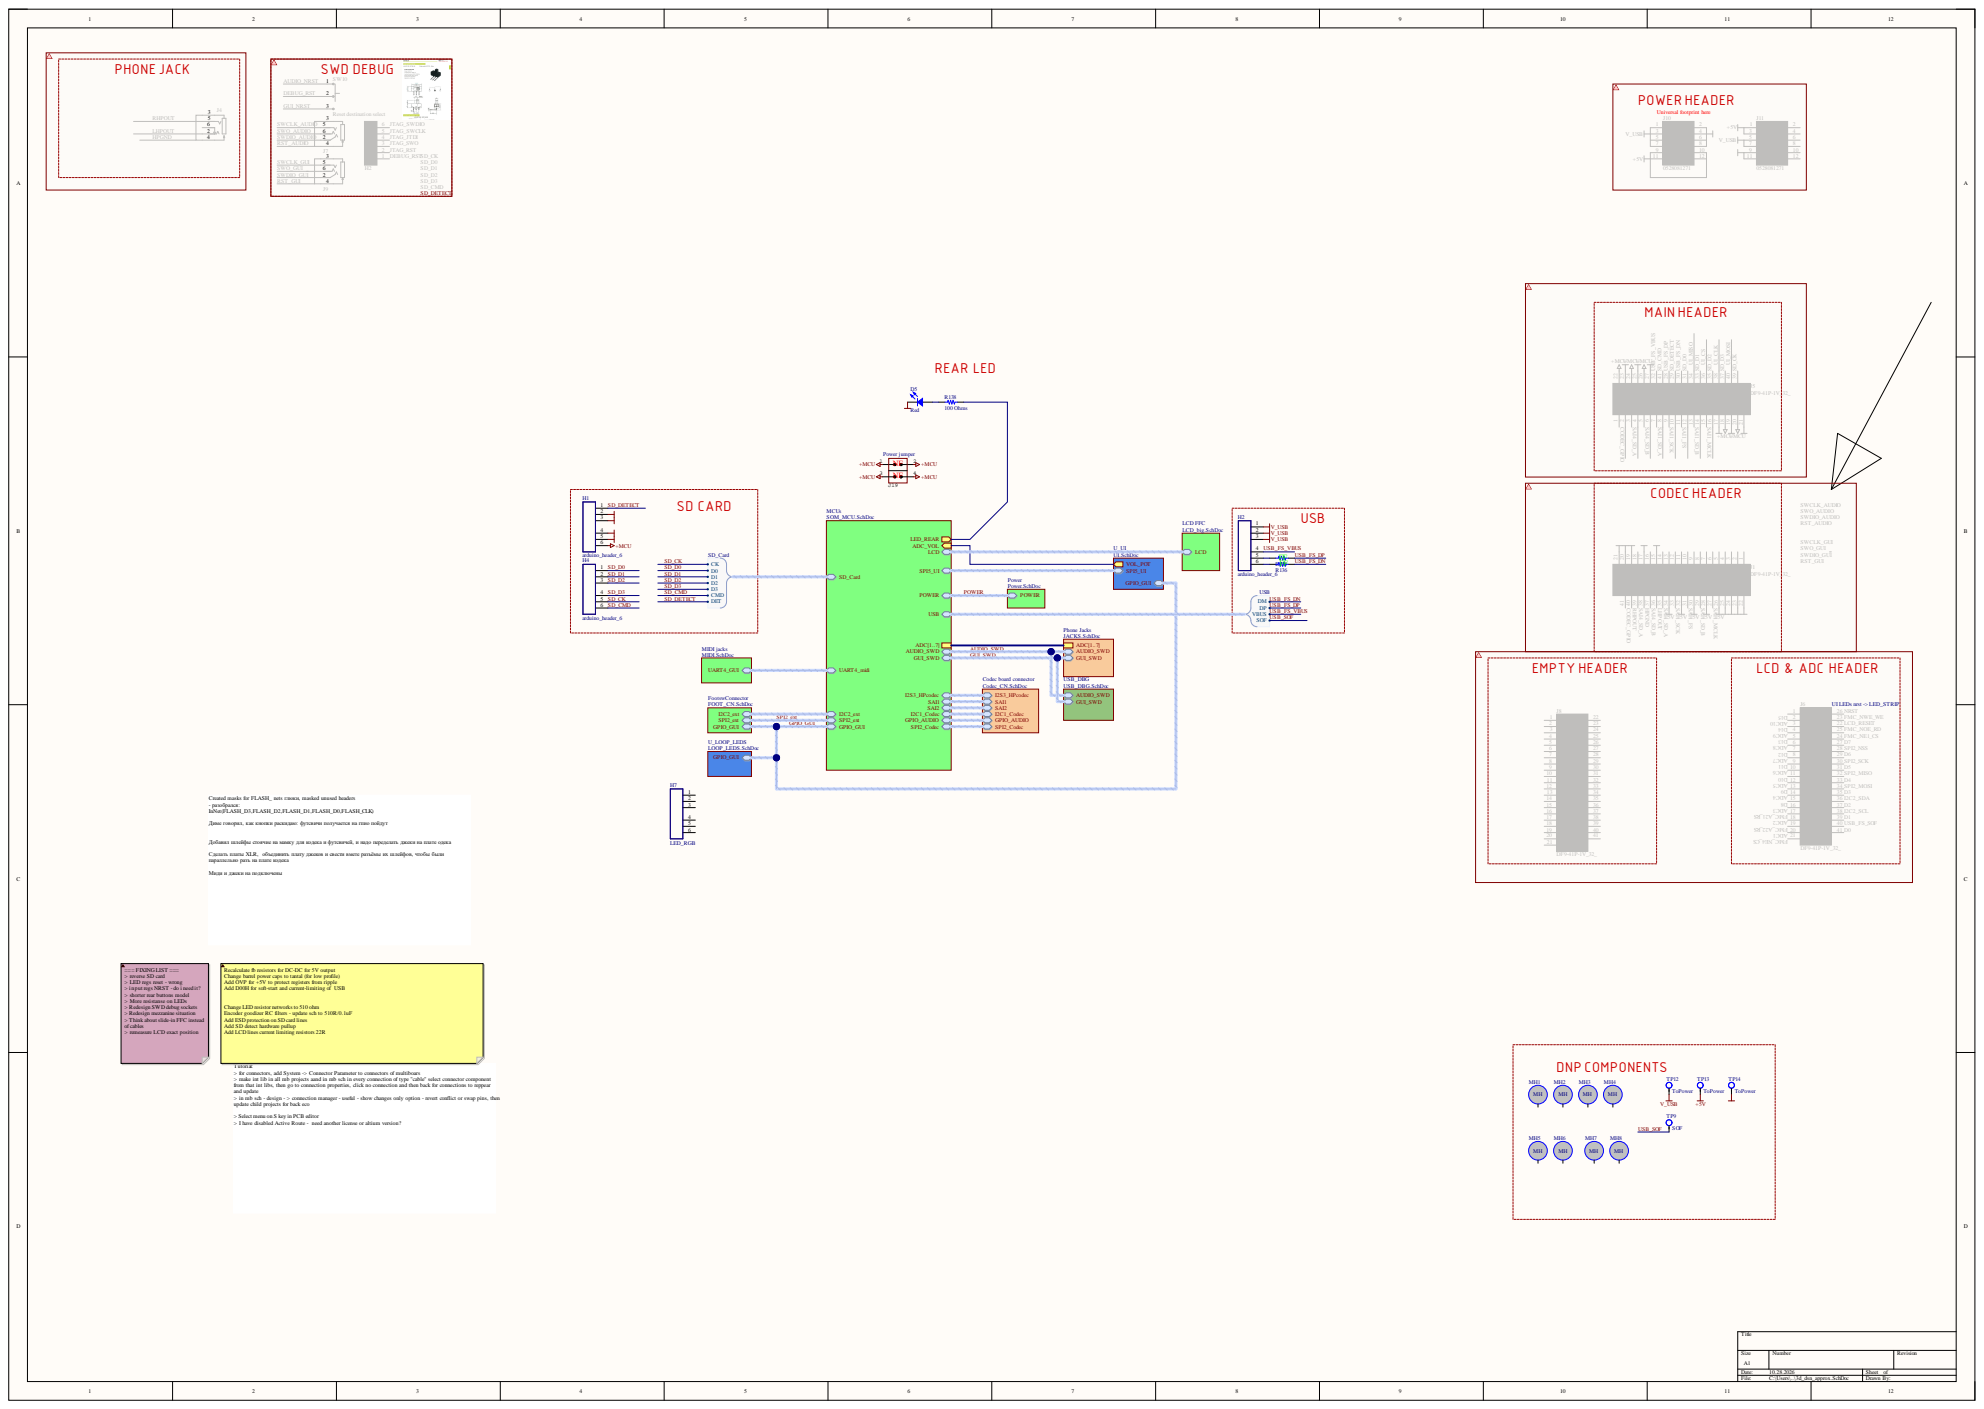
[picture p30: page 1]

UI.SchDoc VOL_POT SPI5_UI GPIO_GUI

Created masks for FLASH_ nets глюки, masked unused headers
- разобрался:
InNet(FLASH_D3,FLASH_D2,FLASH_D1,FLASH_D0,FLASH_CLK)

Диме говорил, как кнопки раскидаю: футсвичи получается на гпио пойдут

Добавил шлейфы стоячие на мамку для кодека и футсвичей, и надо переделать джеки на плате одека

Сделать платы XLR, объединить плату джеков и свести вмете разъёмы их шлейфов, чтобы были
параллельно разъ на плате кодека

Миди и джеки на подключены

=== FIXING LIST ===
> reverse SD card
> LED regs reset - wrong
> input regs NRST - do i need it?
> shorter rear buttons model
> More resistanse on LEDs
> Redesign SWD debug sockets
> Redesign mezzanine situation
> Think about slide-in FFC instead
of cables
> remeasure LCD exact position

Recalculate fb resistors for DC-DC for 5V output
Change barrel power caps to tantal (for low profile)
Add OVP for +5V to protect registers from ripple
Add D00H for soft-start and current-limiting of USB

Change LED resistor networks to 510 ohm
Encoder goodizer RC filters - update sch to 510R/0.1uF
Add ESD protection on SD card lines
Add SD detect hardware pullup
Add LCD lines current limiting resistors 22R

Tutorial:
> for connectors, add System -> Connector Parameter to connectors of multiboars
> make int lib in all mb projects aand in mb sch in every connection of type "cable" select connector component
from that int libs, then go to connection properties, click no connection and then back for connections to reppear
and update
> in mb sch - design - > connection manager - useful - show changes only option - revert conflict or swap pins, then
update child projects for back eco

> Select menu on S key in PCB editor
> I have disabled Active Route - need another license or altium version?

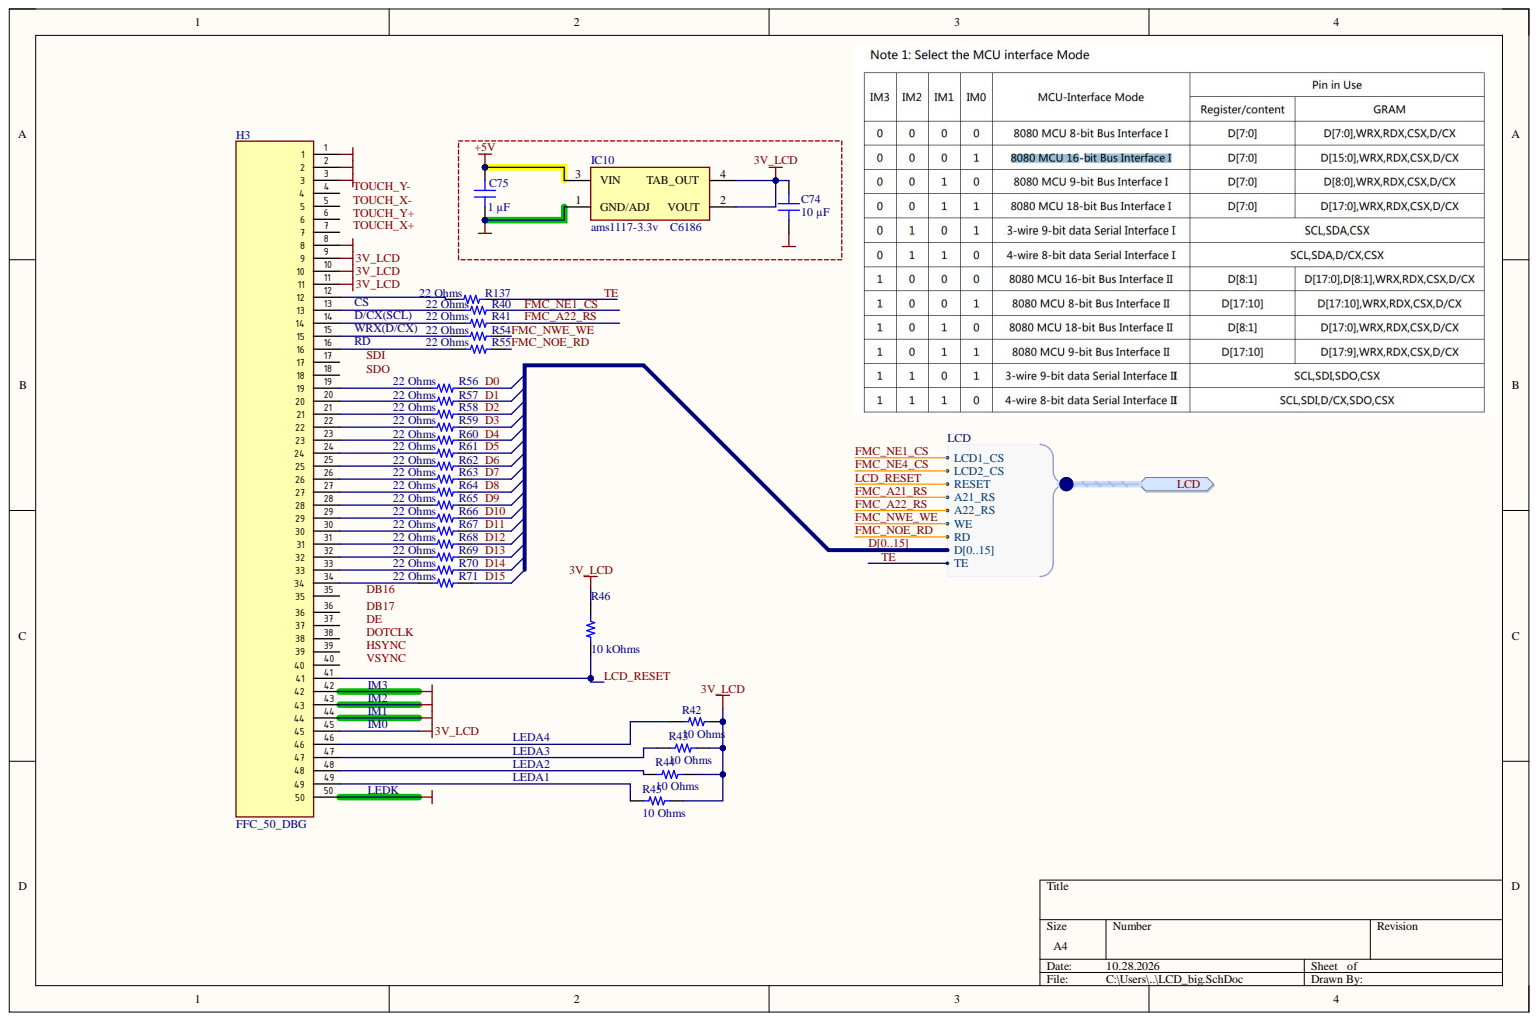
[picture p31: page 2]

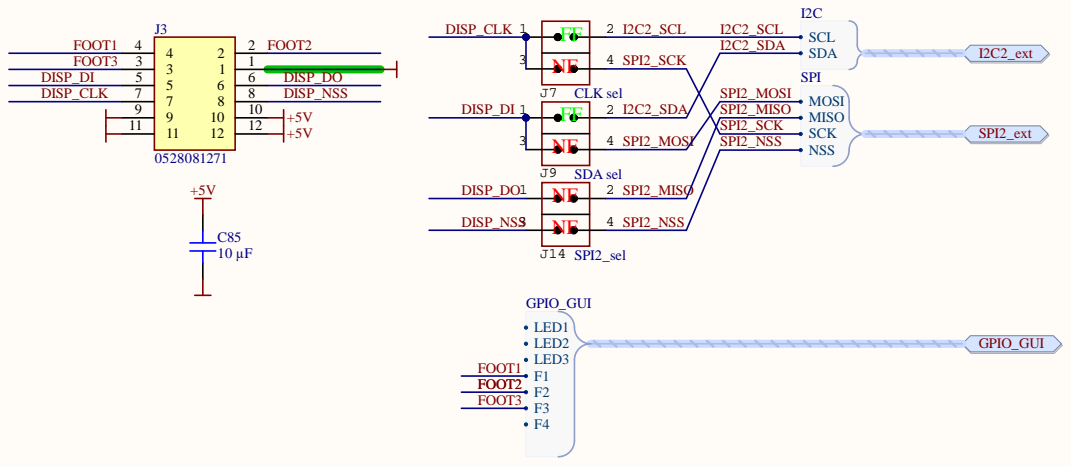
[picture p32: page 3]

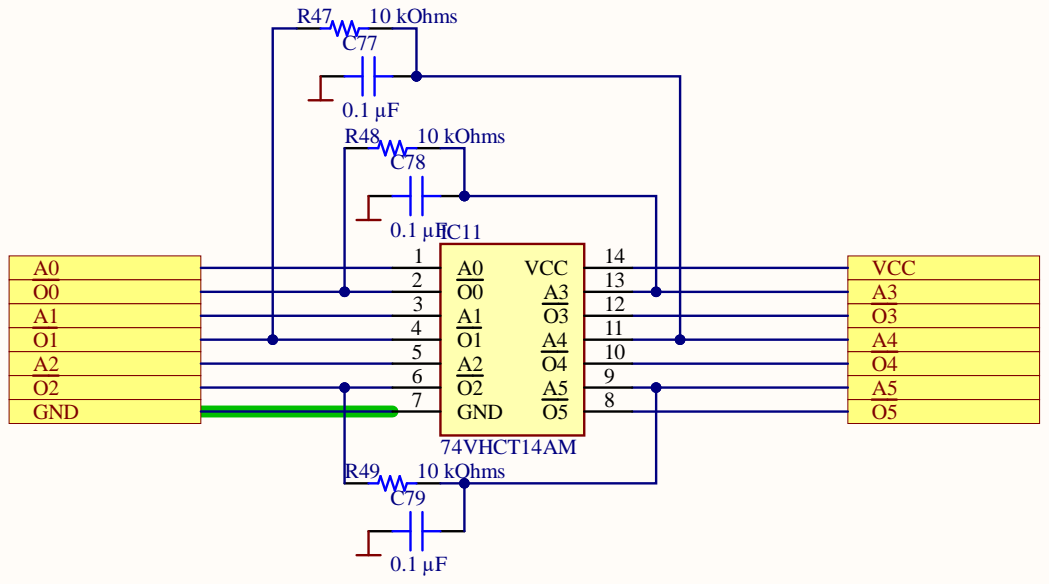
[picture p33: page 4]

A1 | O3
O1 | A4

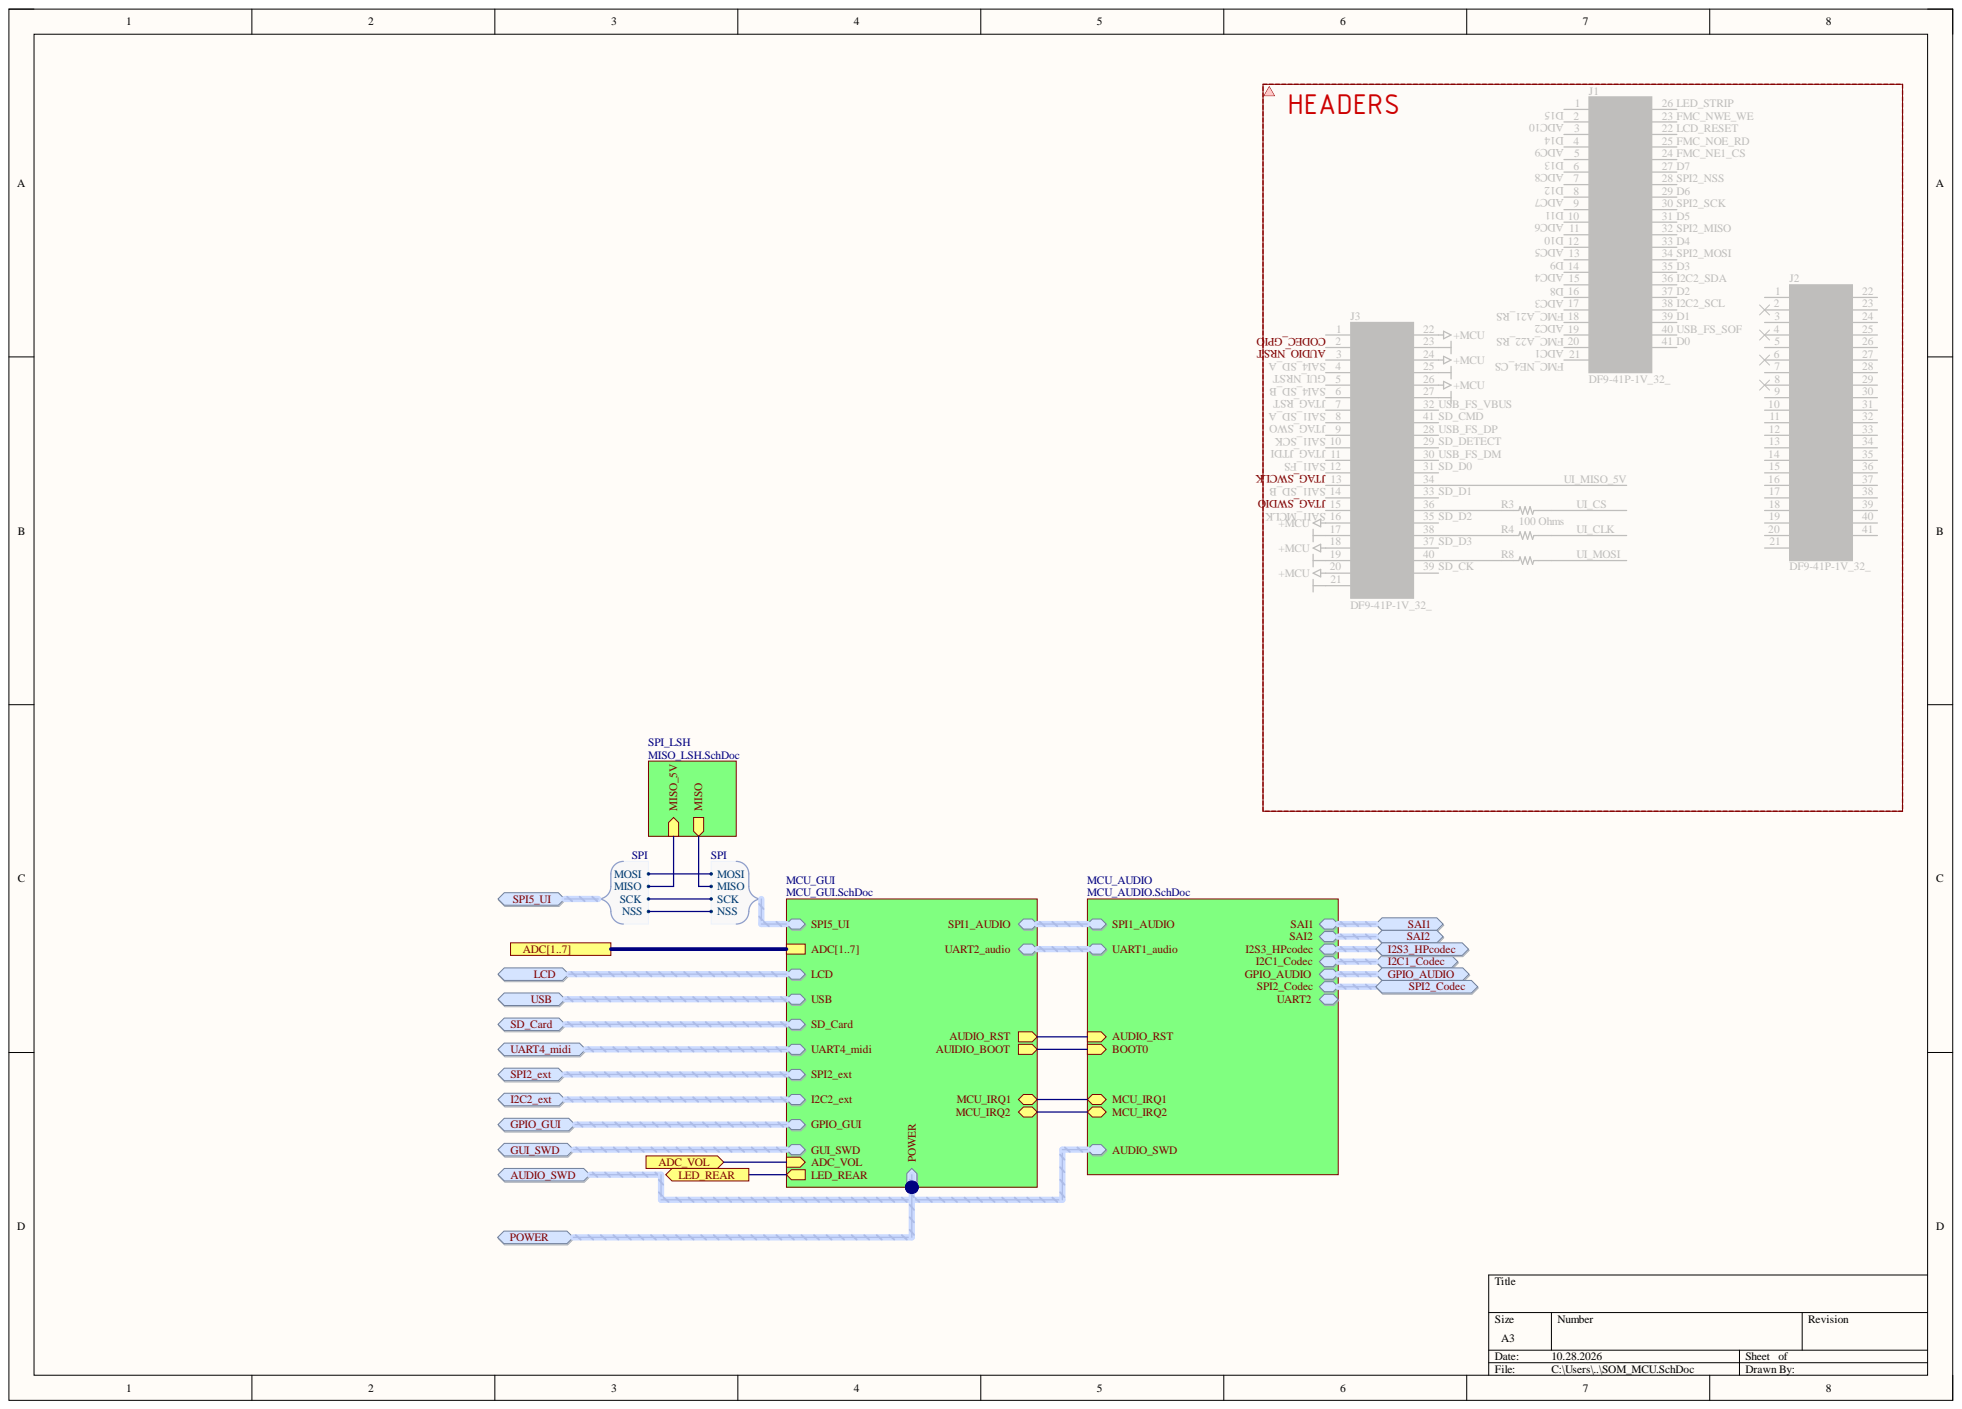
[picture p34: page 5]

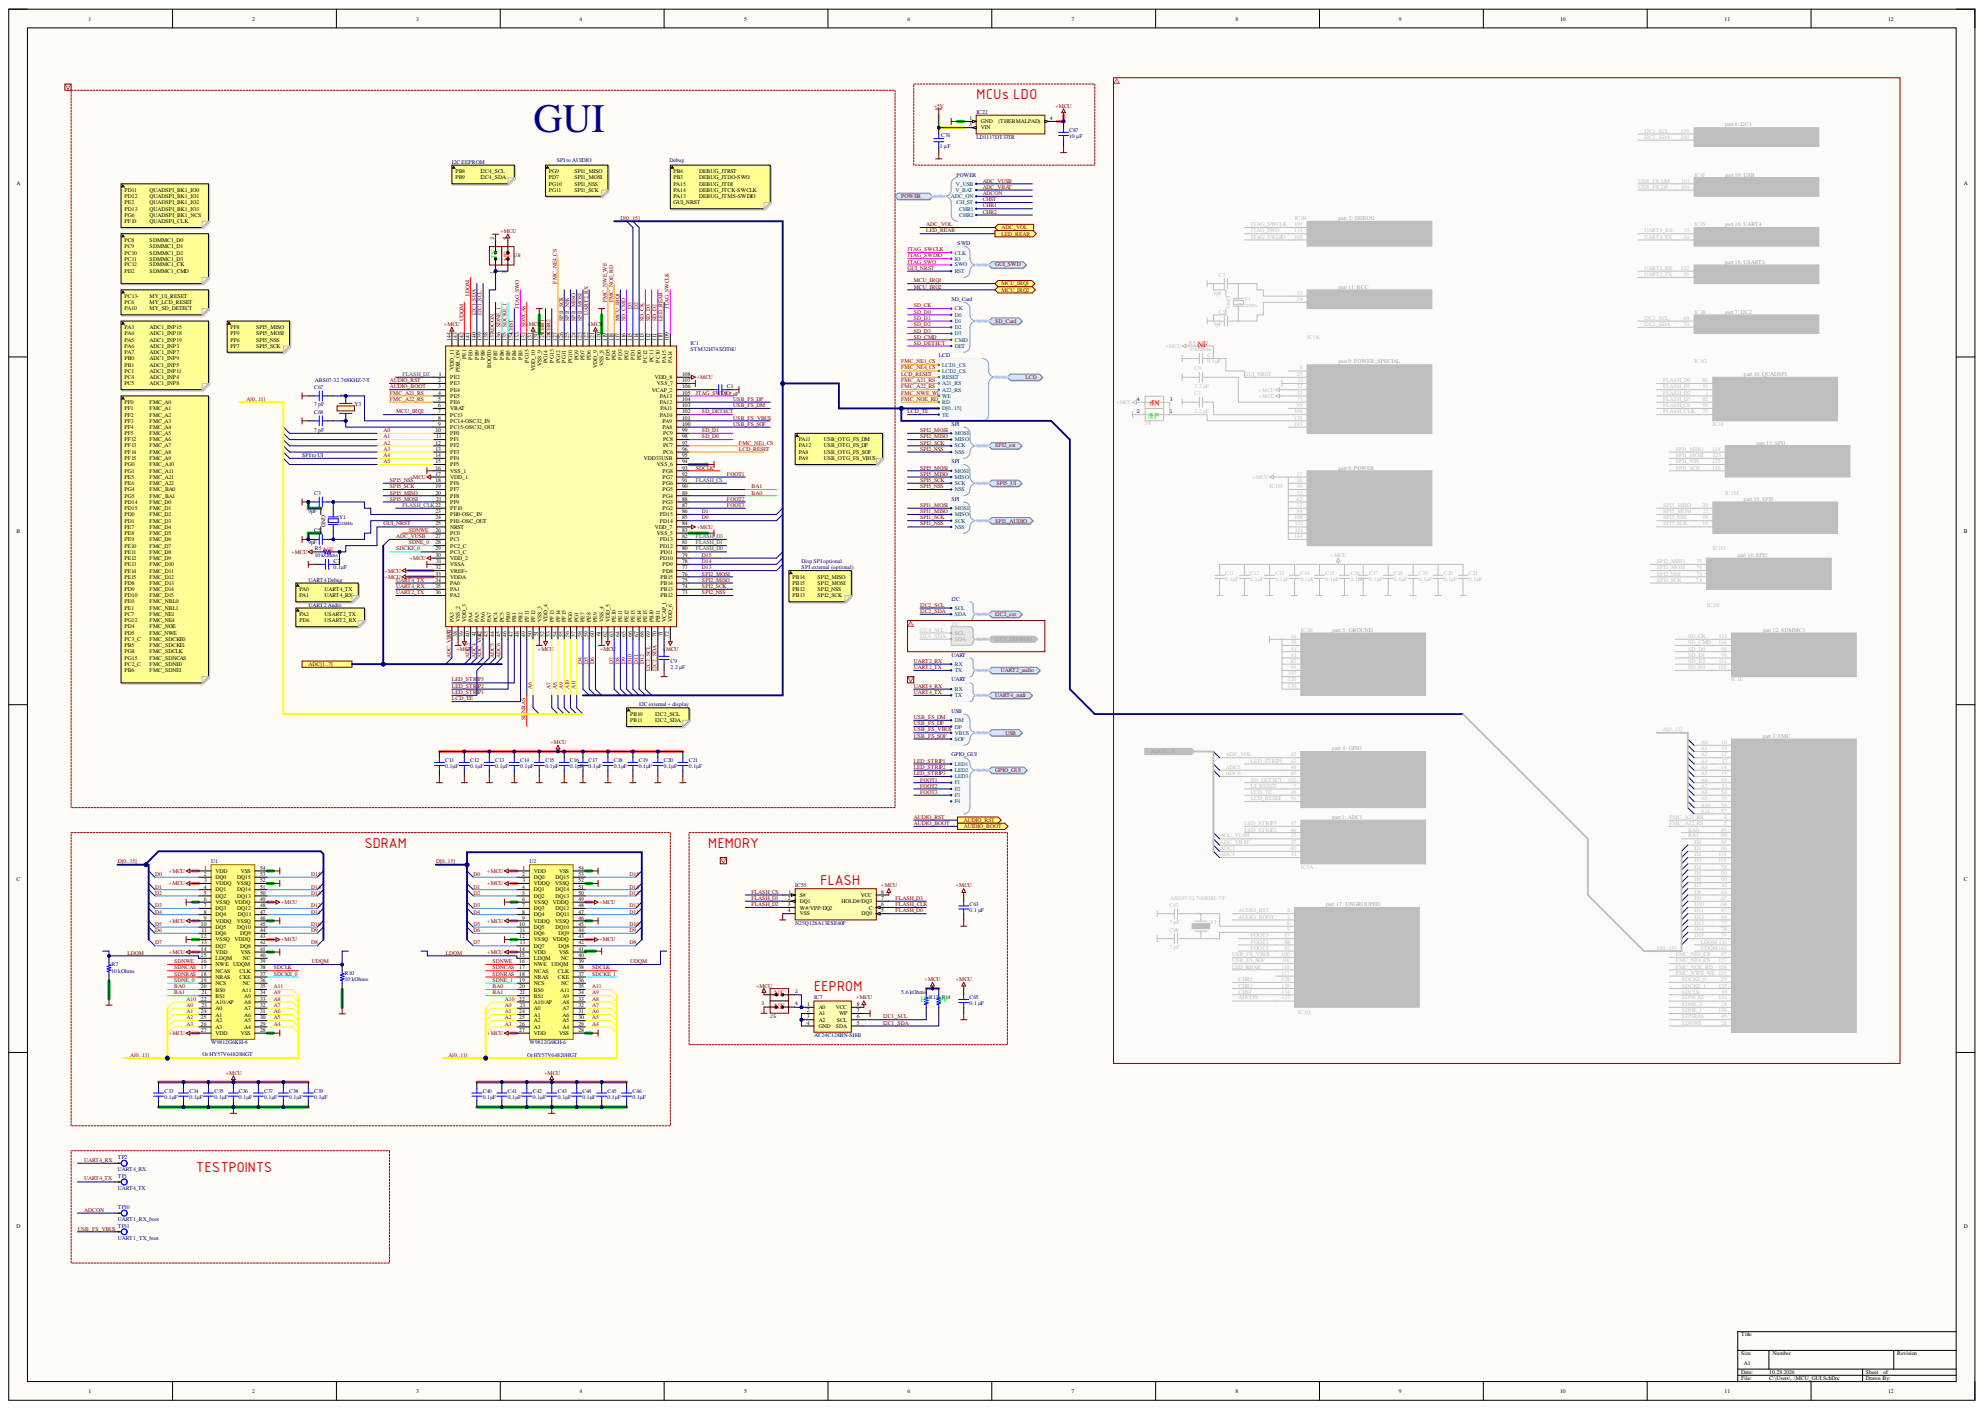
[picture p35: page 6]

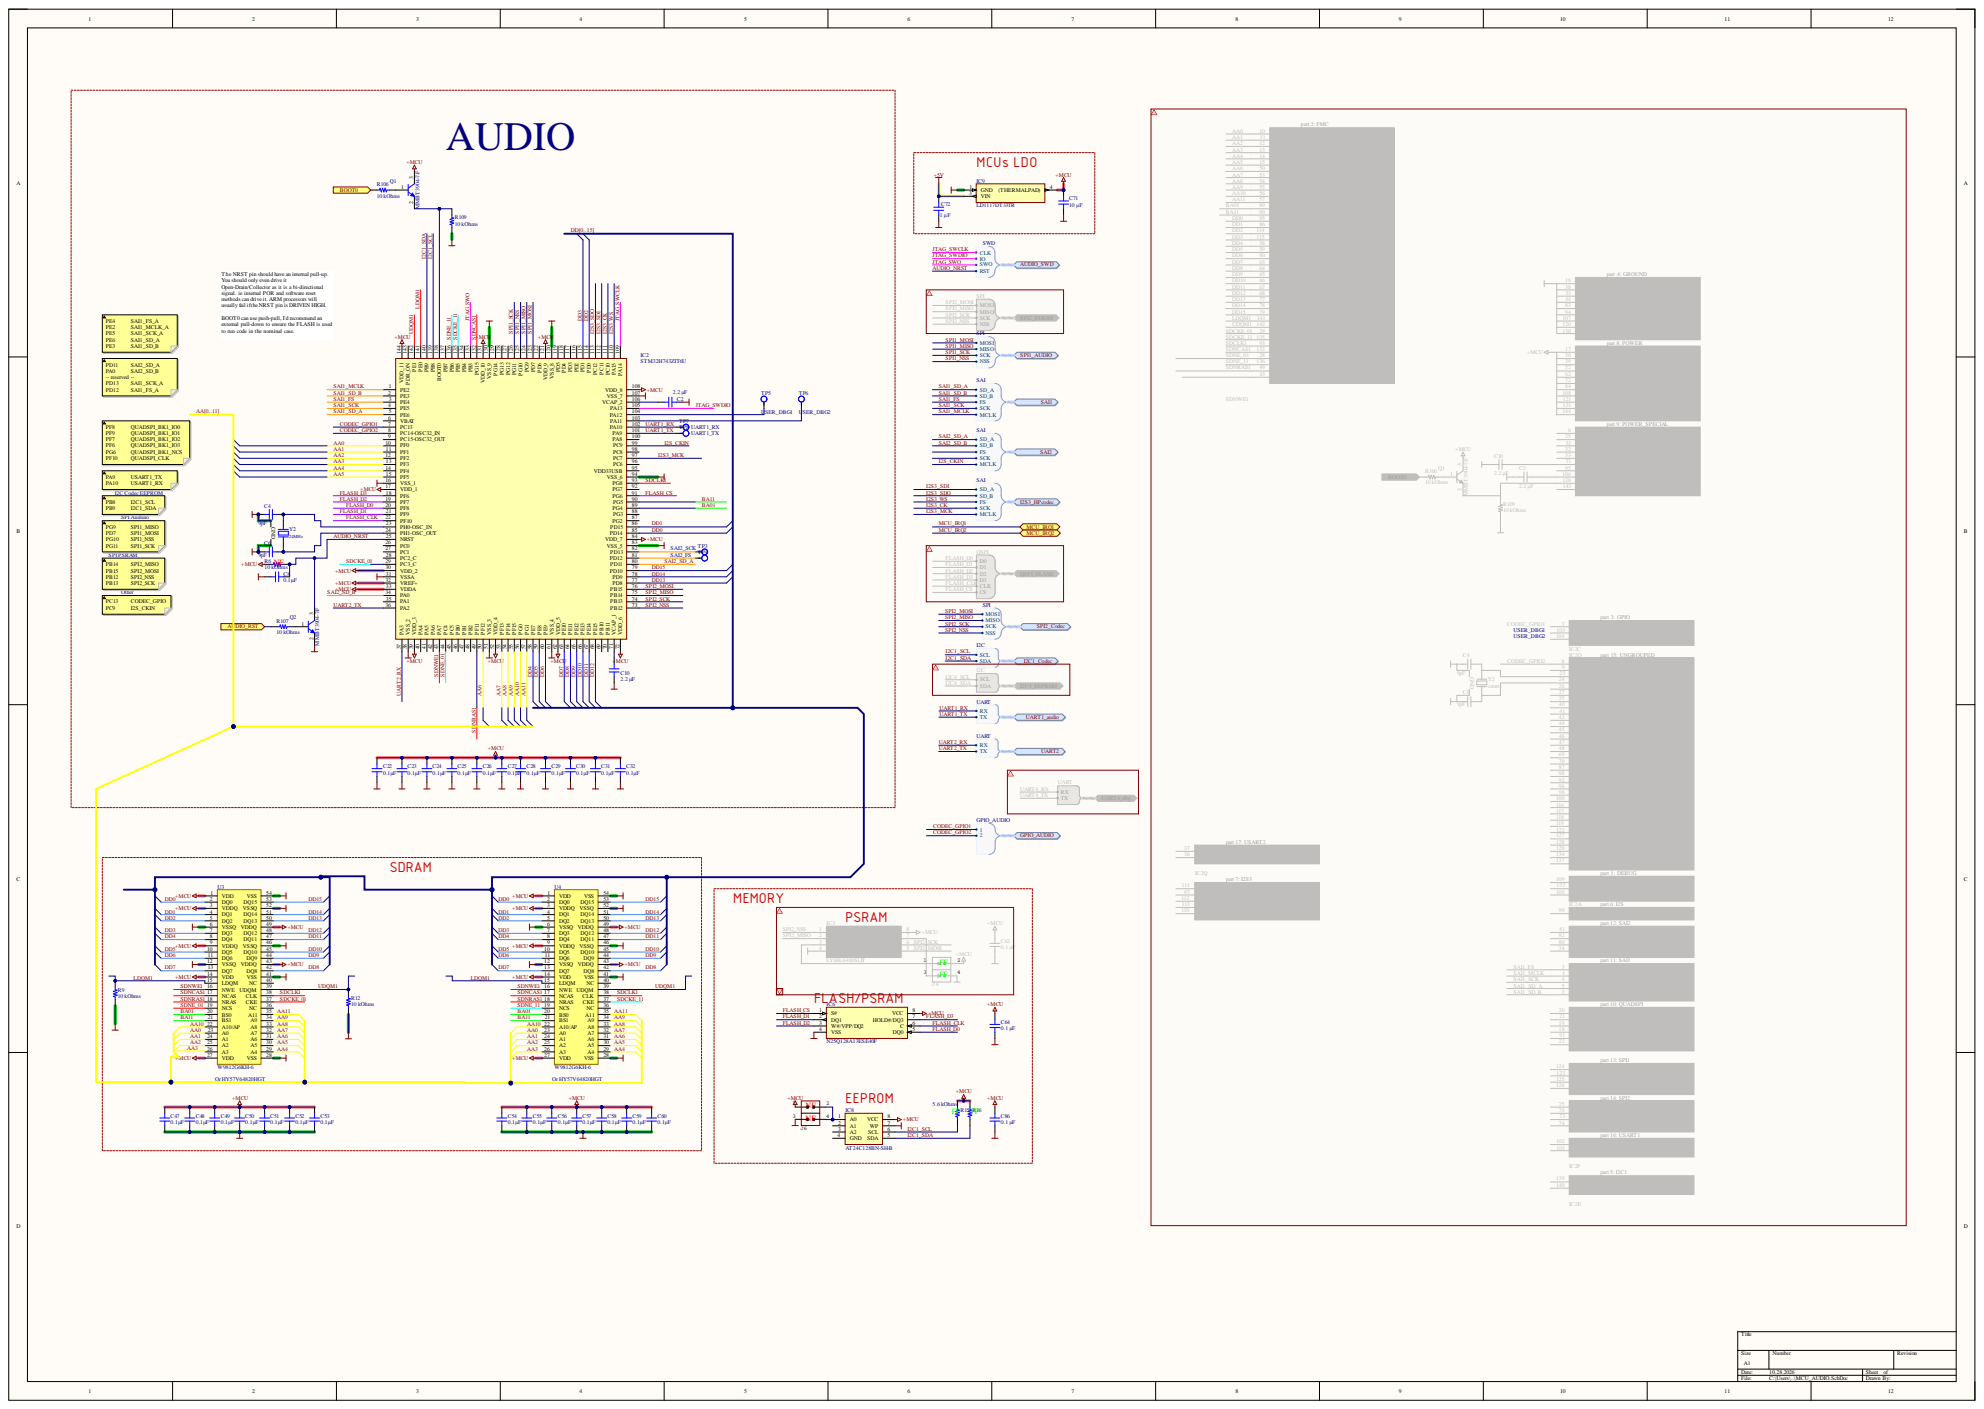
[picture p36: page 7]

T he NRST pin should have an internal pull-up.
You should only even drive it
Open-Drain/Collector as it is a bi-directional
signal. ie internal POR and software reset
methods can drive it. ARM processors will
usually fail ifthe NRST pin is DRIVEN HIGH.

BOOT0 can use push-pull, I'd recommend an
external pull-down to ensure the FLASH is used
to run code in the nominal case.

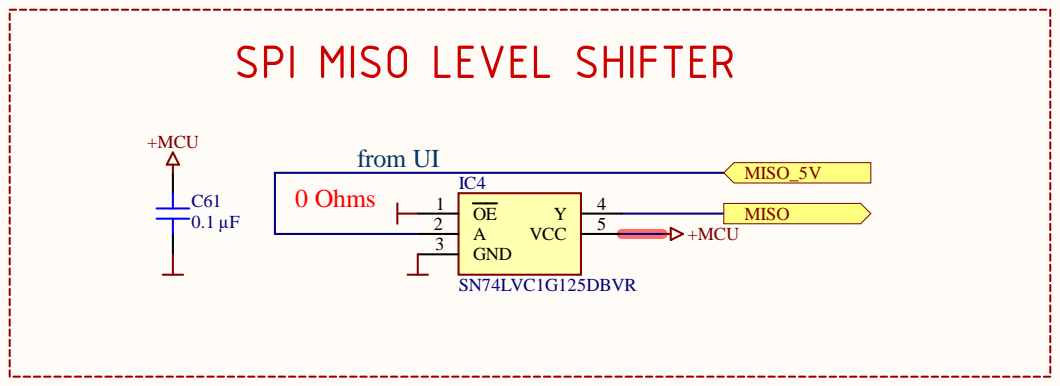
[picture p37: page 8]

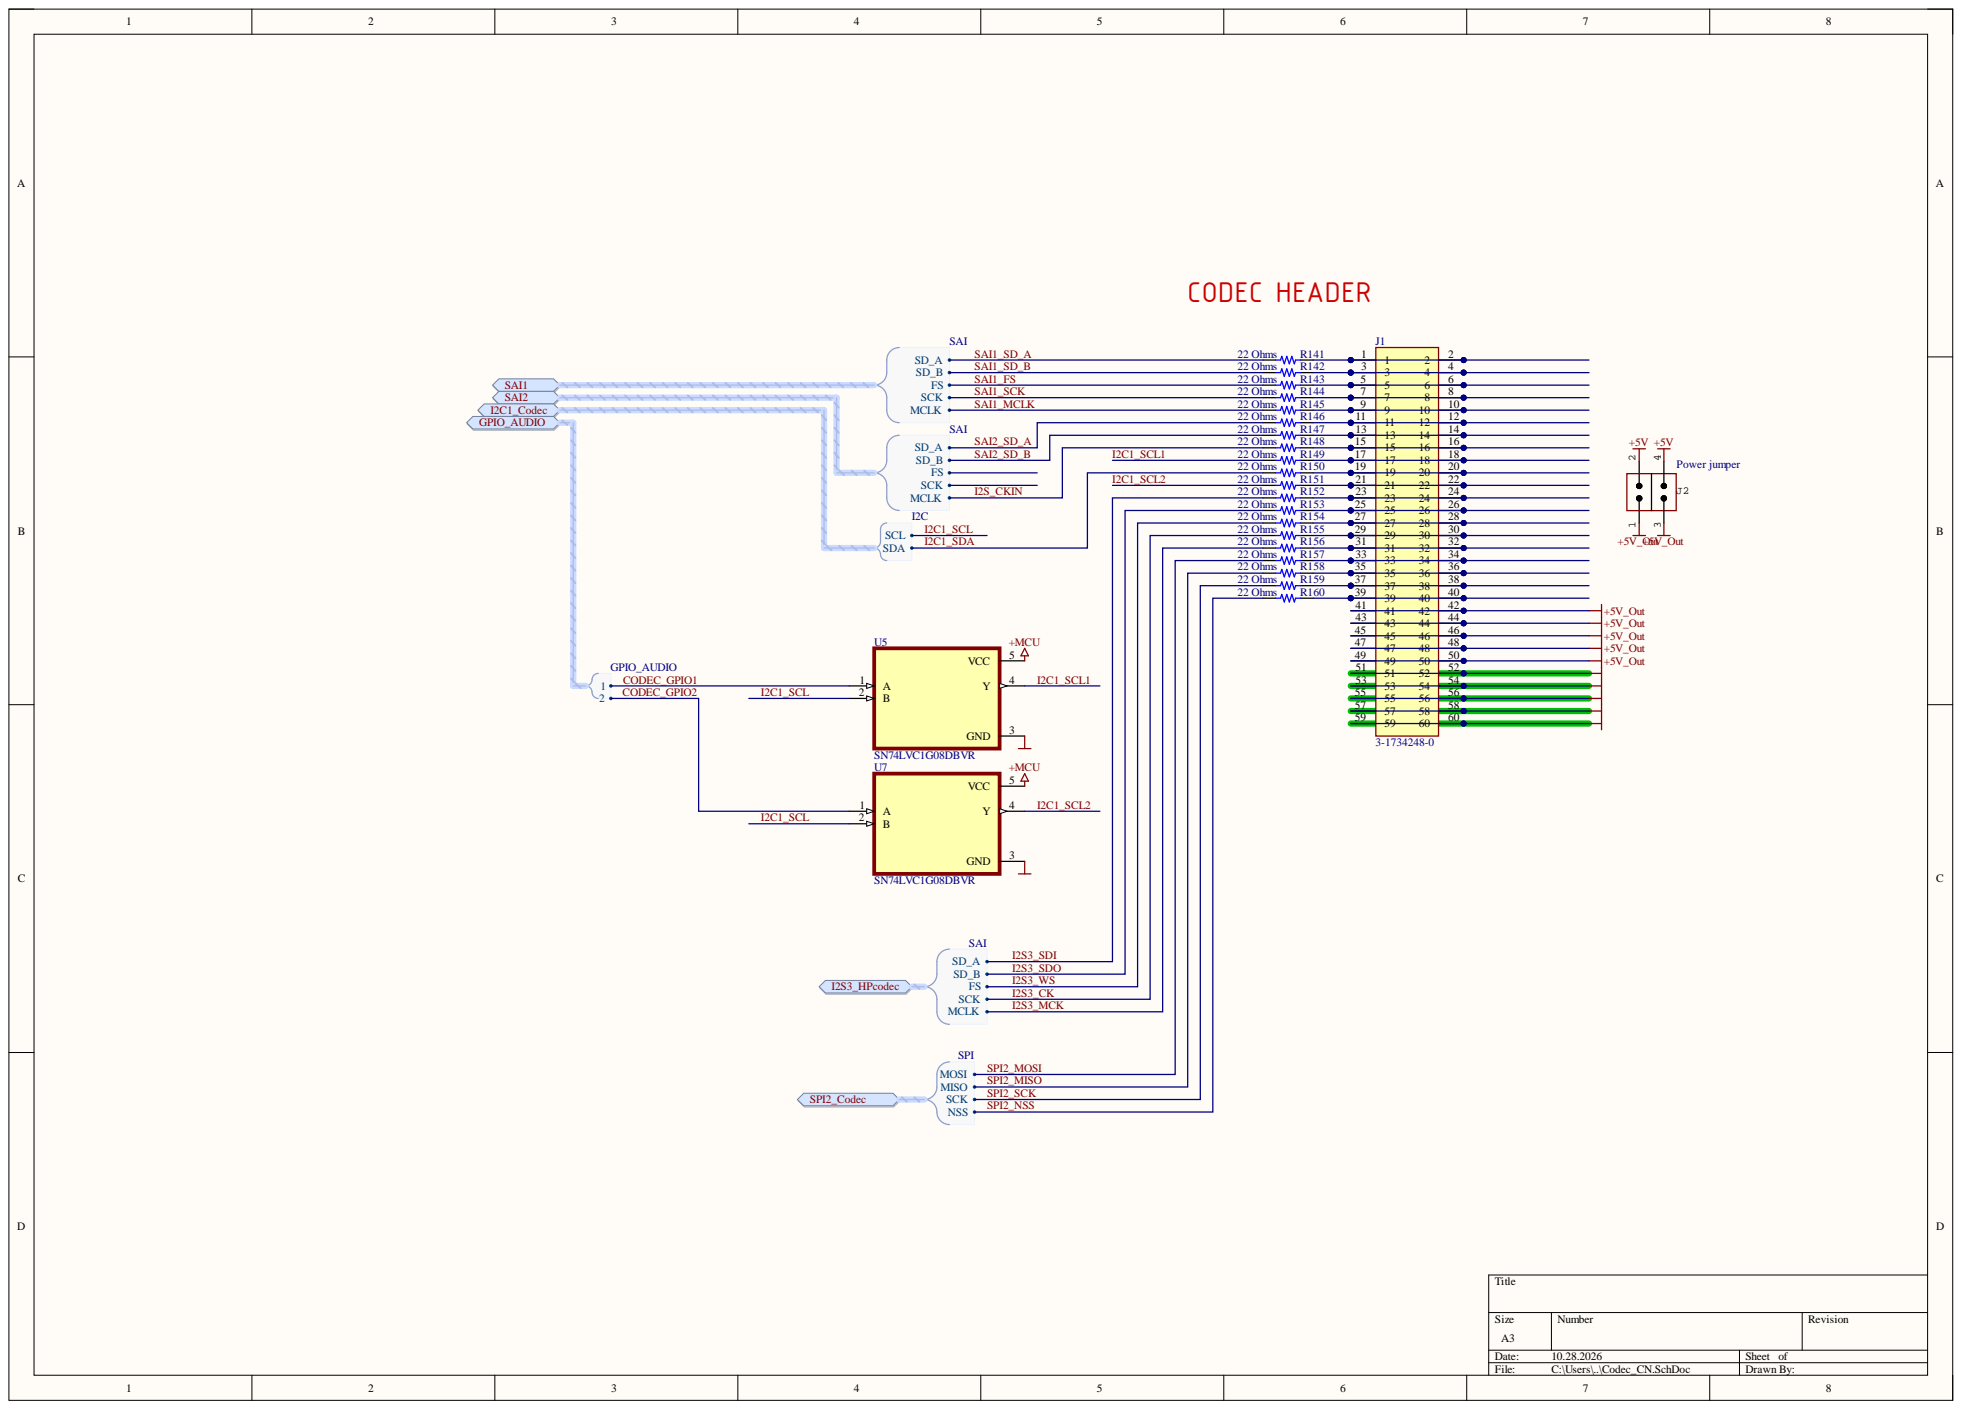
[picture p38: page 9]

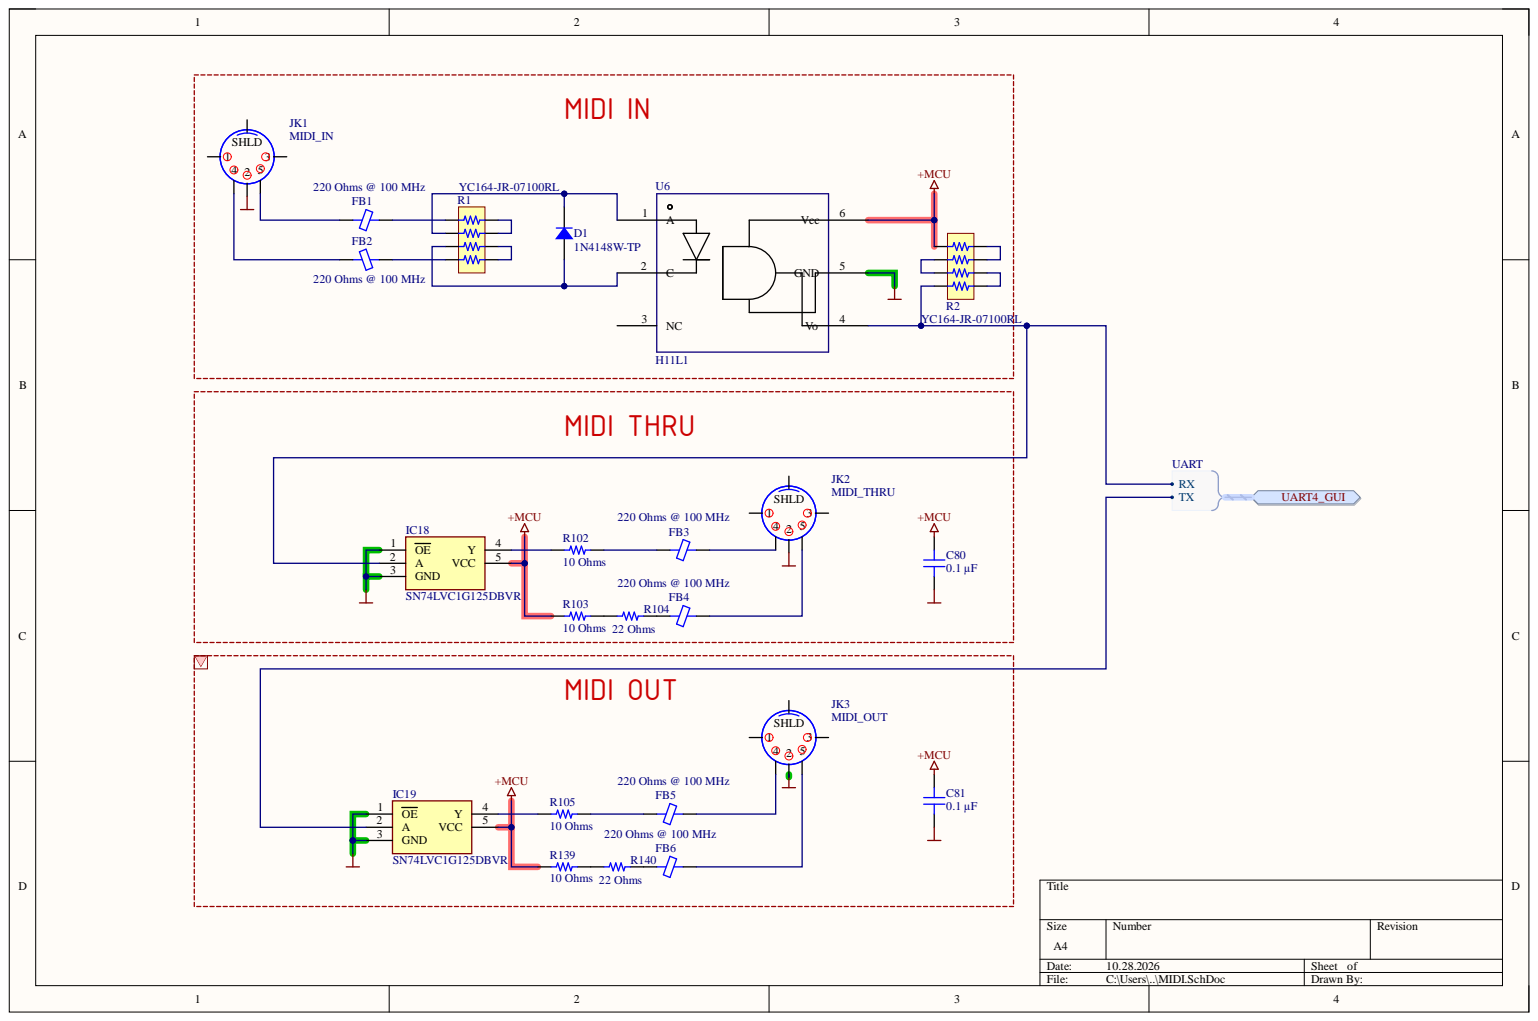
[picture p39: page 10]

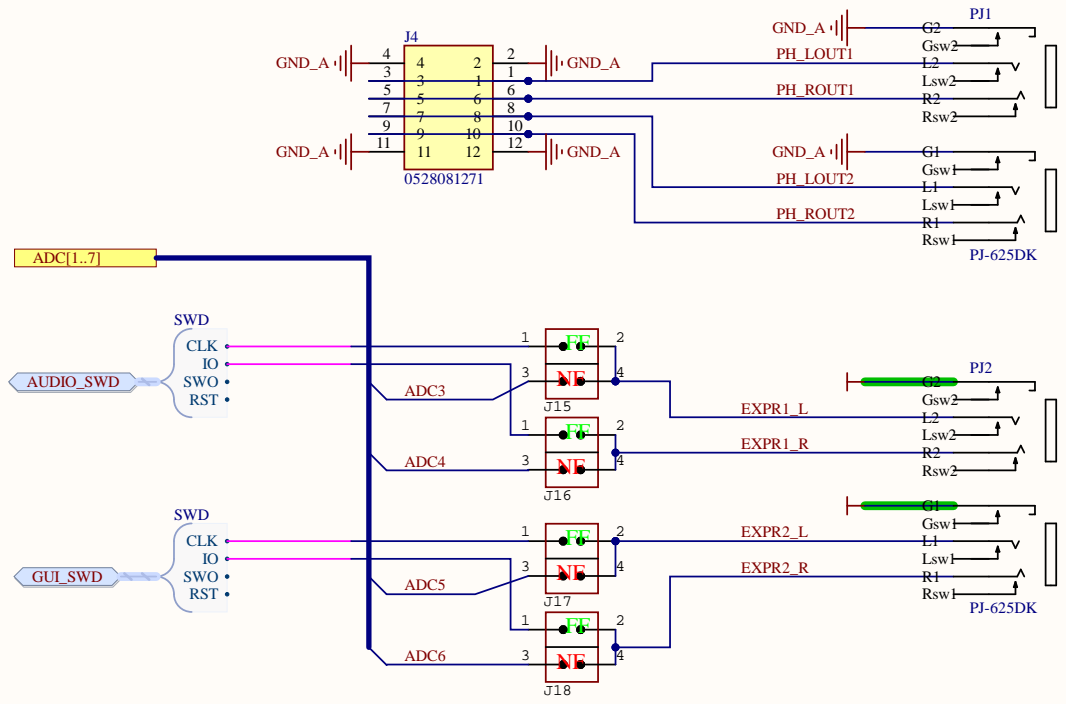
[picture p40: page 11]

9 9 10 | 10
11 11 12 | 12 | PH_LOUT2 | L1

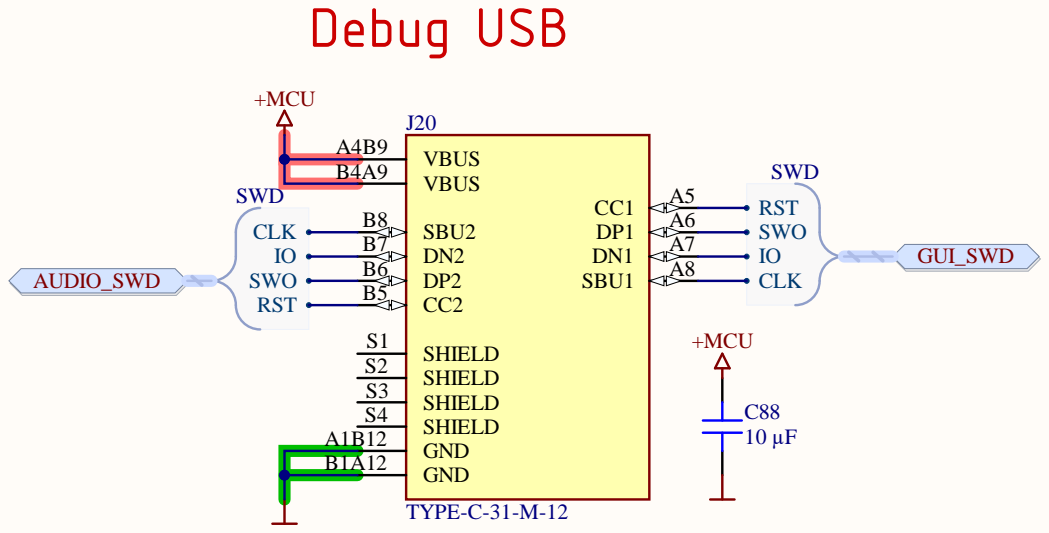
[picture p41: page 12]

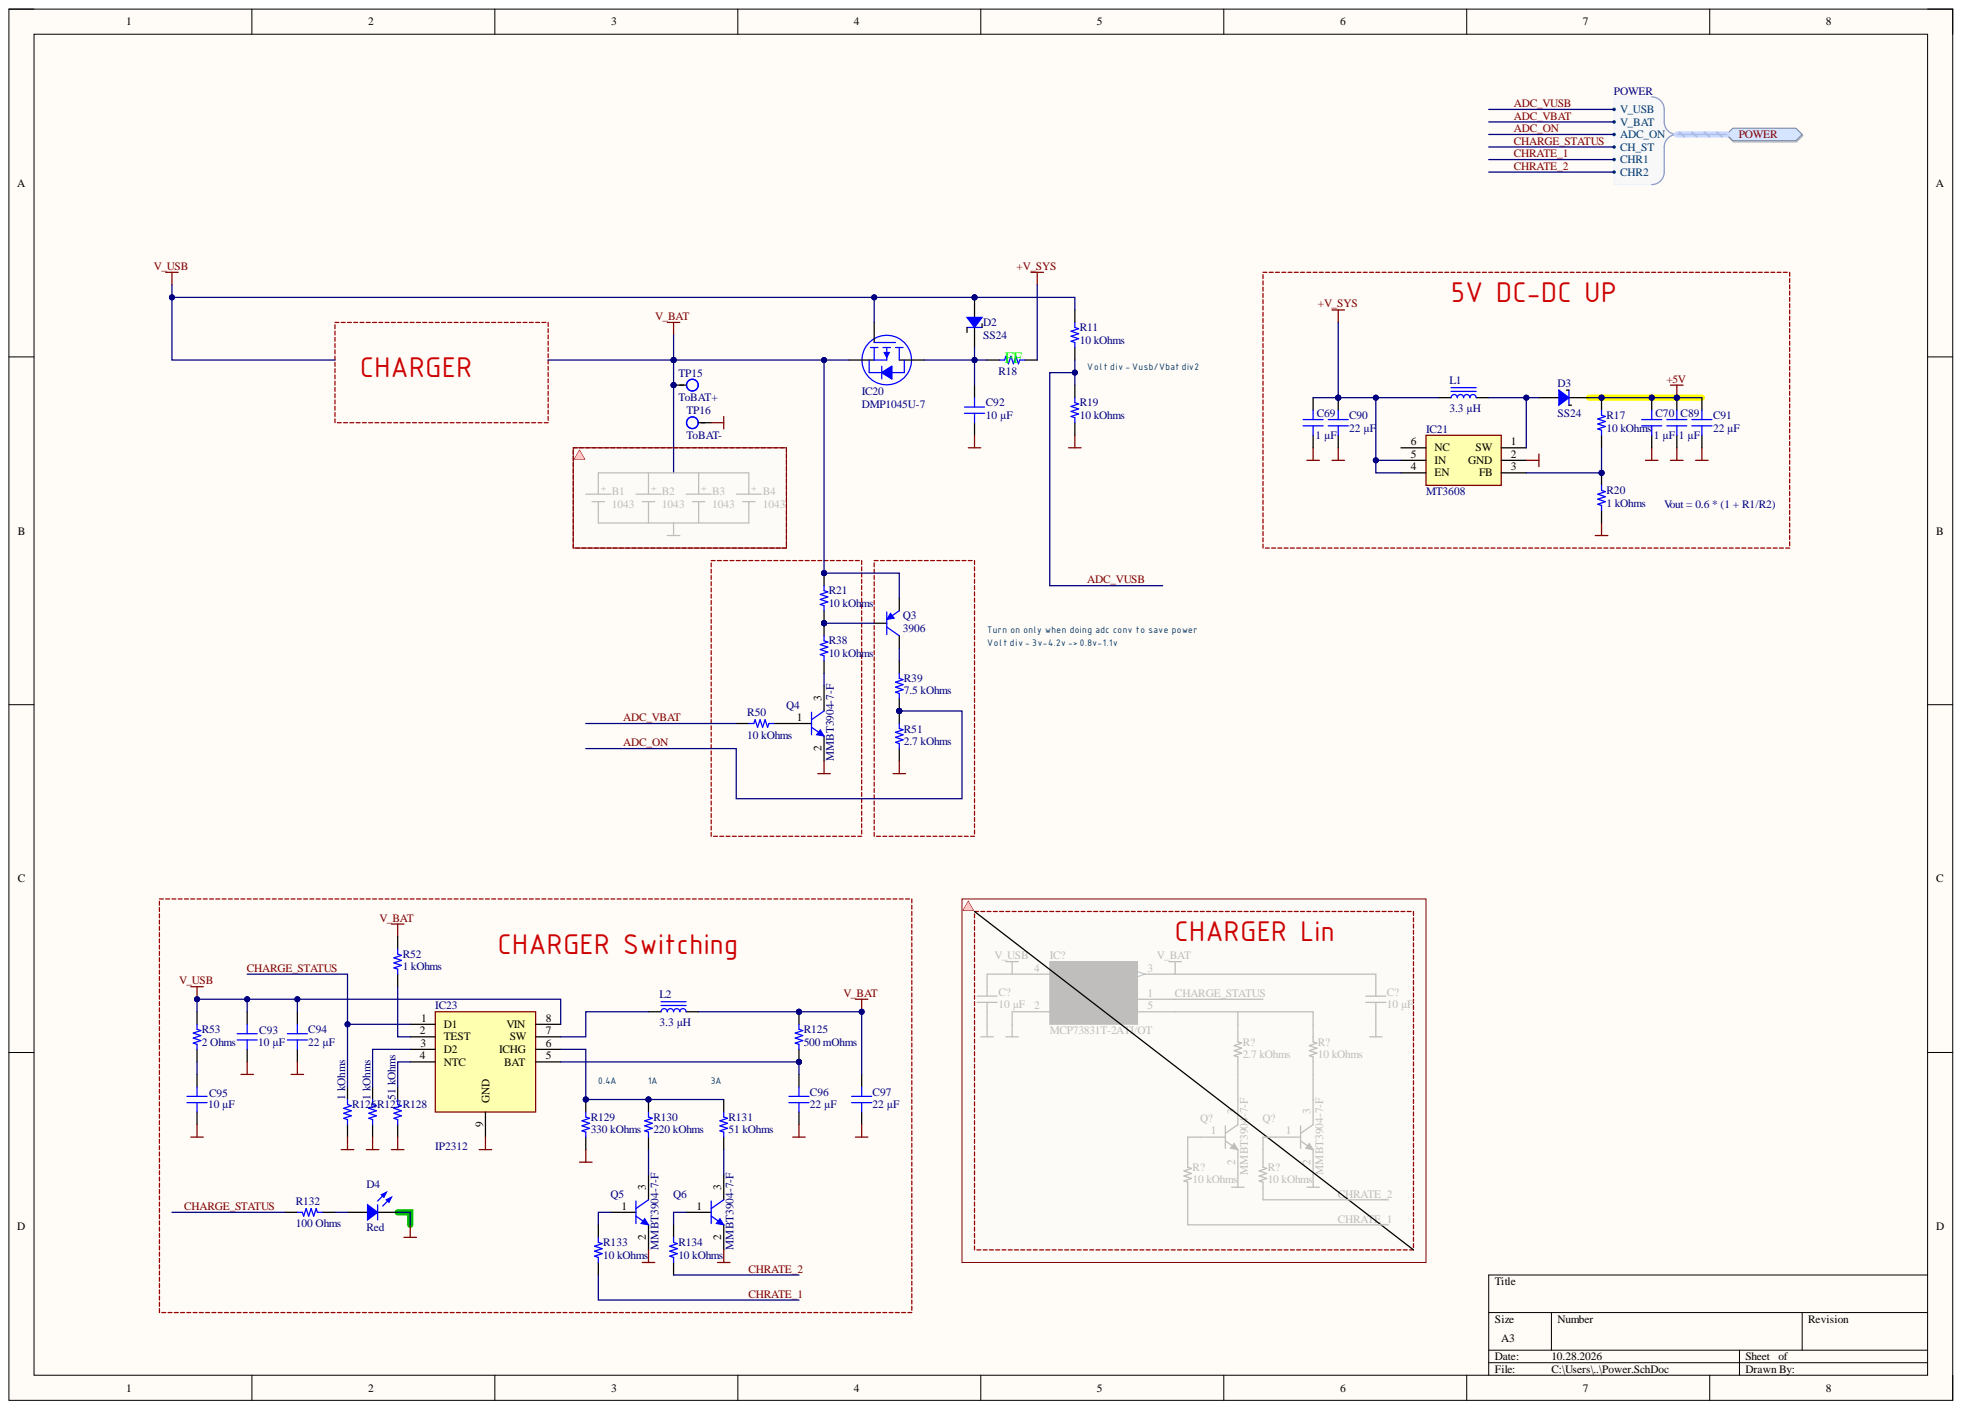
[picture p42: page 13]

Volt div - Vusb/Vbat div2

Turn on only when doing adc conv to save power
Volt div - 3v-4.2v -> 0.8v-1.1v

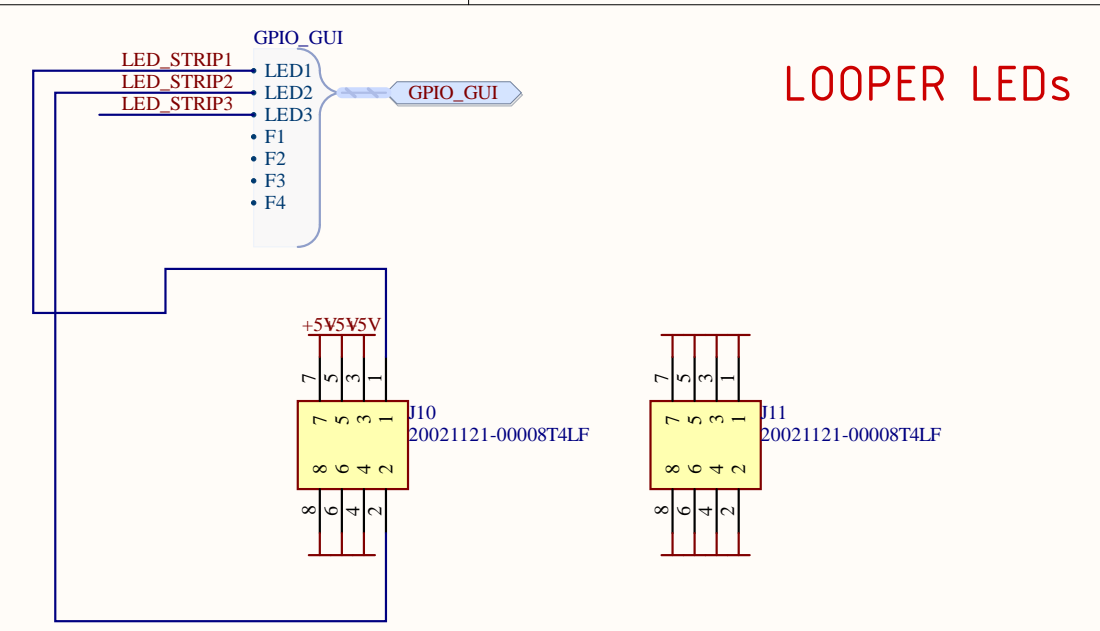
[picture p43: page 14]

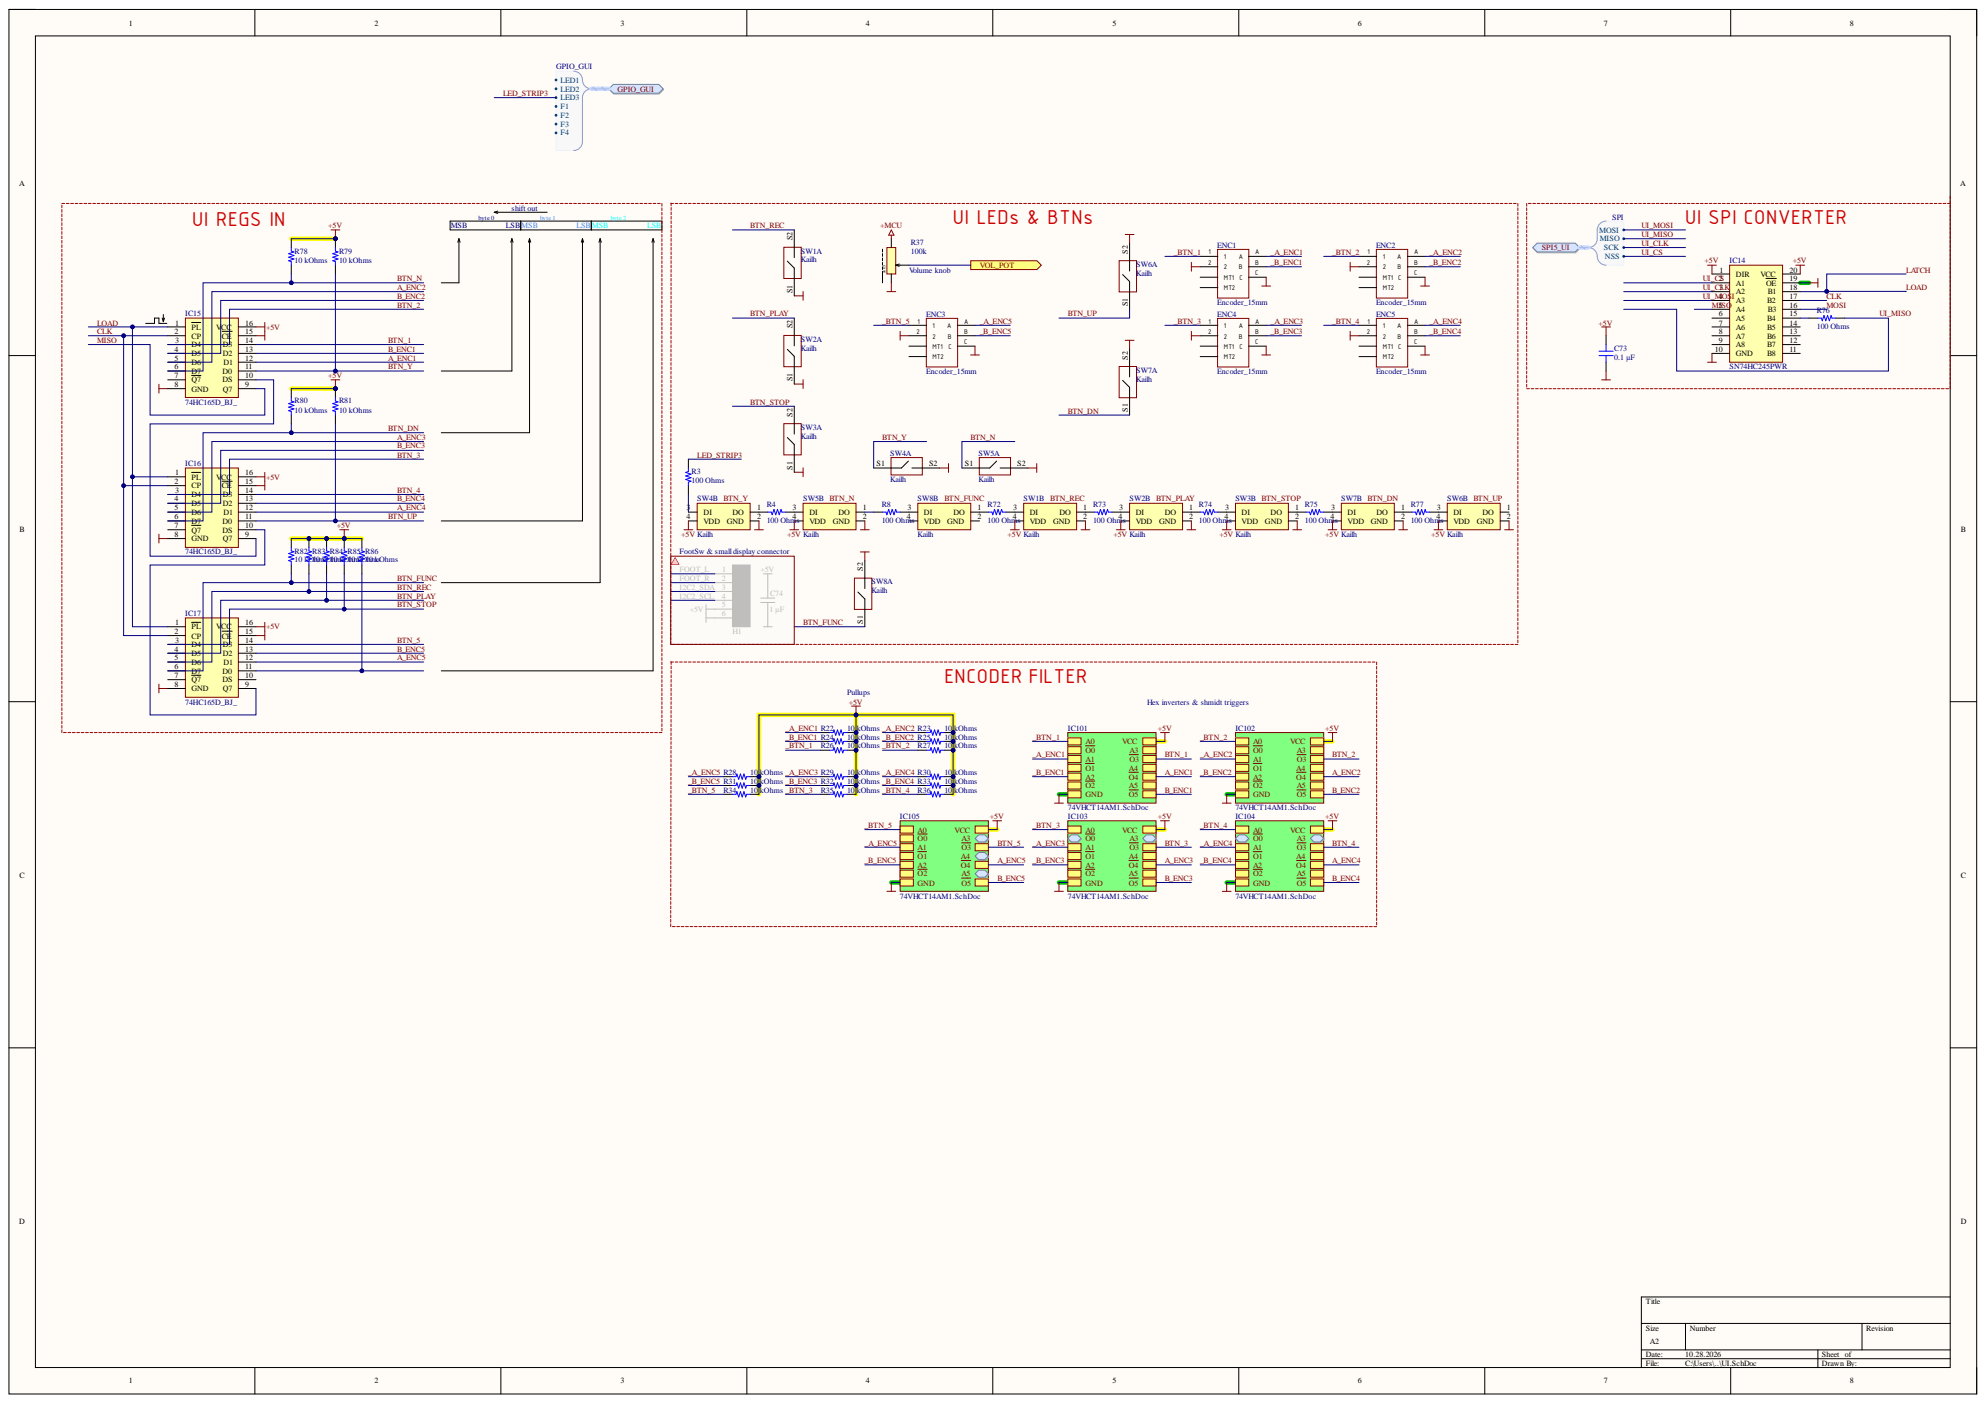
[picture p44: page 15]

A_ENC2
B_ENC2
BTN_2

IC15 | BTN_1

D5 4 D2 | 13 | B_ENC1
D6 5 D1 | 12 | A_ENC1

A_ENC3

IC16 | BTN_4

BTN_3

D5 4 D2 | 13 | B_ENC4

D7 6 | BTN_UP
Q7 7

FootSw & small display connector

D5 4 D2 | 13 | B_ENC5
D6 5 D1 | 12 | A_ENC5

Hex inverters & shmidt triggers

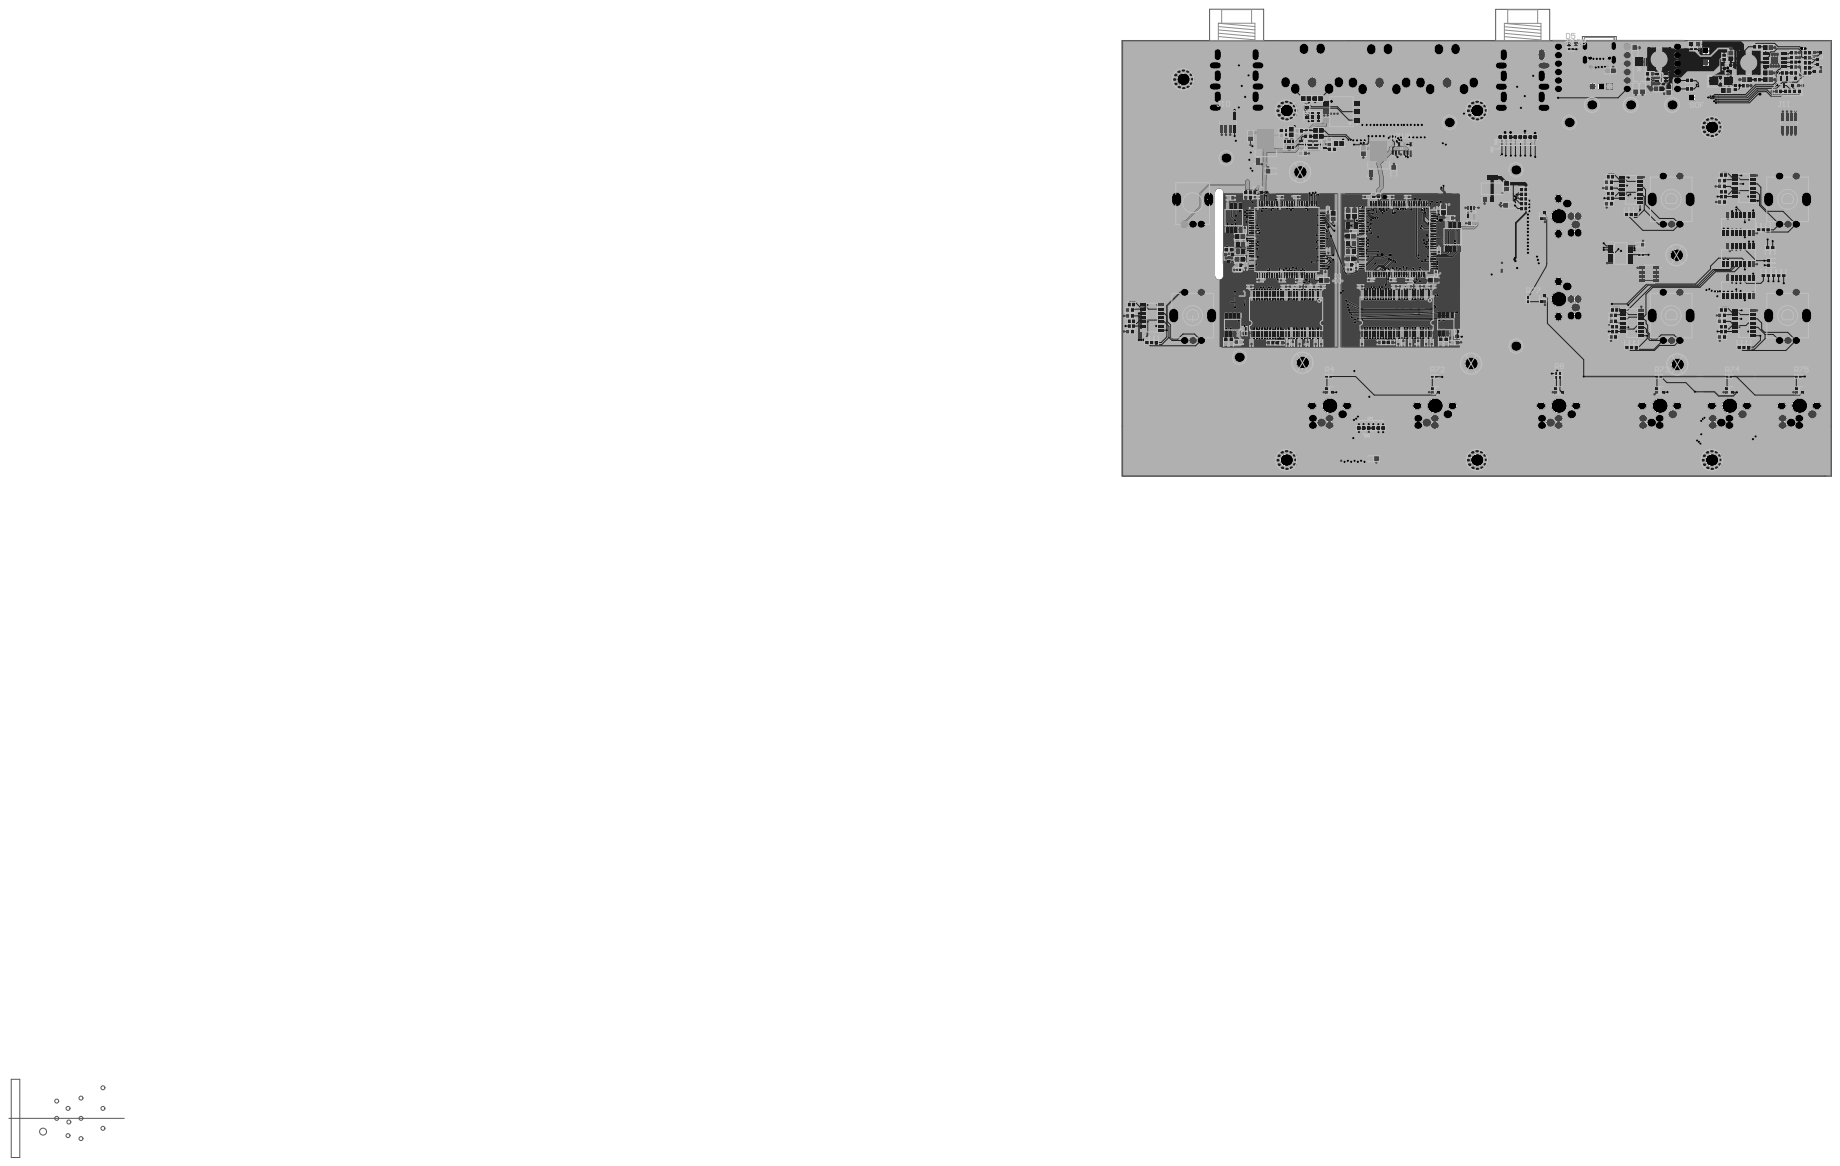
[picture p45: page 16]

Line # | Name | Description | Designator | Quantity | Price | Part Number | Manufacturer 1 | Manufacturer Part Number 1 | Manufacturer Lifecycle 1 | Supplier 1 | Supplier Part Number 1 | Supplier Unit Price 1 | Supplier Subtotal 1 | Supplier 2 | Supplier Part Number 2 | Supplier Unit Price 2 | Supplier Subtotal 2 | Manufacturer 3 | Manufacturer Part Number 3 | Manufacturer Lifecycle 3 | Supplier 3 | Supplier Part Number 3 | Supplier Unit Price 3 | Supplier Subtotal 3 | Supplier 4 | Supplier Part Number 4 | Supplier Unit Price 4 | Supplier Subtotal 4
| 2.2 µF | CAP CER 2.2UF 10V X7R 0805 | C1, C2, C9,
| | | C10 | | 4 0.03 | C0805C225K8RAC
| | | | | | 7800 | | | | DigiKey | 399-
| | | | | | | | | | | C0805C225K8RAC7800CT-
| | | | | | | | | | | ND
9pF | CAP CER 9PF 250V C0G/NP0 0805 | C3, C4, C5, C6 | | 4 0.28 | CBR08C909CAGAC | DigiKey | 399-8711-1-ND
0.1µF | CAP CER 0.1UF 16V X7R 0402 | C7, C8, C11, C12, C13, C14, C15, C16, C17, C18, C19, C20, C21, C22, C23, C24, C25, C26, C27, C28, C29, C30, C31, C32, C33, C34, C35, C36, C37, C38, C39, C40, C41, C42, C43, C44, C45, C46, C47, C48, C49, C50, C51, C52, C53, C54, C55, C56, C57, C58, C59, C60 | 52 0.01 | | C0402C104K4RAC AUTO | DigiKey | 399-6828-1-ND
0.1 µF | CAP CER 0.1UF 50V X7R 0603 | C61, C63, C64, C65, C73, C77_IC101, C77_IC102, C77_IC103, C77_IC104, C77_IC105, C78_IC101, C78_IC102, C78_IC103, C78_IC104, C78_IC105, C79_IC101, C79_IC102, C79_IC103, C79_IC104, C79_IC105, C80, C81, C86 | 23 0.01 | | C0603C104K5RAC 7411 | DigiKey | 399-C0603C104K5RAC7411CT-ND
7 pF | CAP CER 7PF 50V C0G/NPO 0805 | C67, C68 | | 2 0.01 | CC0805DRNPO9B N7R0 | DigiKey | 311-1096-1-ND
1 µF | CAP CER 1UF 16V X7R 0805 | C69, C70, C72, C75, C76, C89 | | 6 0.01 | C0805C105K4RAC 7800 | DigiKey | 399-C0805C105K4RAC7800CT-ND
10 µF | CAP CER 10UF 10V X5R 0805 | C71, C74, C85, C87, C88, C92, C93, C95 | | 8 0.02 | C0805C106K8PAC 7800 | DigiKey | 399-C0805C106K8PAC7800CT-ND
22 µF | CAP CER 22UF 25V X5R 0805 | C90, C91, C94, C96, C97 | | 5 0.09 | CC0805MKX5R8BB 226 | DigiKey | 311-1903-1-ND
1N4148W-TP | DIODE GEN PURP 100V 150MA SOD123 | D1 | | 1 0.01 | 1N4148W-TP | DigiKey | 1N4148WTPMSCT-ND
SS24 | DIODE SCHOTTKY 40V 2A DO214AA | D2, D3 | | 2 0.10 | SS24 | DigiKey | SS24FSCT-ND
Red | LED RED CLEAR 0805 SMD | D4, D5 | | 2 0.11 | LSM0805412V | DigiKey | 28-LSM0805412VCT-ND
Encoder_15mm | | ENC1, ENC2, ENC3, ENC4, ENC5 | | 5
220 Ohms @ 100 MHz | FERRITE BEAD 220 OHM 0805 1LN | FB1, FB2, FB3, FB4, FB5, FB6 | | 6 0.02 | BLM21PG221SN1 D | DigiKey | 490-1054-1-ND
arduino_header_6 | | H1, H2, H4 | | 3
FFC_50_DBG | | H3 | | 1
LED_RGB | | H7 | | 1
STM32H743ZIT6U | Integrated Circuit | IC1, IC2 | | 2
SN74LVC1G125DBVR N25Q128A13ESE40F | Integrated Circuit Integrated Circuit | IC4, IC18, IC19 IC6, IC55 | | 3 2
AT24C128BN-SH-B | Integrated Circuit | IC7, IC8 | | 2
LD1117DT33TR | Integrated Circuit | IC9, IC22 | | 2
ams1117-3.3v 74VHCT14AM | Integrated Circuit Integrated Circuit | IC10 IC11_IC101, IC11_IC102, IC11_IC103, IC11_IC104, IC11_IC105 | | 1 5 | | LCSC | C6186
SN74HC245PWR | Integrated Circuit | IC14 | | 1
74HC165D_BJ_ | Integrated Circuit | IC15, IC16, IC17 | | 3
DMP1045U-7 | MOSFET P-CH 12V 4A SOT23 | IC20 | | 1 0.07 | DMP1045U-7 | DigiKey | DMP1045U-7DICT-ND
MT3608 | Integrated Circuit | IC21 | | 1
IP2312 | Integrated Circuit | IC23 | | 1
3-1734248-0 | Connector | J1 J2, J5, J6, J7, J8, J9, J14, J15, J16, J17, J18, J19 | 12 | 1
0528081271 20021121-00008T4LF | Connector Connector | J3, J4 J10, J11 | | 2 2
TYPE-C-31-M-12 | USB Connectors 24 Receptacle 1 8.94*7.3mm RoHS | J20 | | 1 None
MIDI_IN | DIN5 | JK1 | | 1
MIDI_THRU MIDI_OUT | DIN5 DIN5 | JK2 JK3 | | 1 1
3.3 µH | FIXED IND 3.3UH 2.5A 28 MOHM SMD | L1, L2 | | 2 0.31 | SRR6028-3R3Y | DigiKey | 118-SRR6028-3R3YCT-ND
MountingHole | | MH1, MH2, MH3, MH4, MH5, MH6, MH7, MH8 | | 8
PJ-625DK | 6.3mm jack HOOYA | PJ1, PJ2 | | 2
MMBT3904-7-F | TRANS NPN 40V 0.2A SOT23-3 | Q1, Q2, Q4, Q5, Q6 | | 5 0.01 | MMBT3904-7-F | DigiKey | MMBT3904-FDICT-ND
3906 | | Q3 | | 1
YC164-JR-07100RL | RES ARRAY 4 RES 100 OHM 1206 | R1, R2 | | 2 0.01 | YC164-JR-07100RL | DigiKey | YC164J-100CT-ND
100 Ohms | RES SMD 100 OHM 1% 1/16W 0402 | R3, R4, R8, R72, R73, R74, R75, R76, R77, R132, R138 | 11 | 0.01 | CRCW0402100RFK EE | DigiKey | 541-2953-1-ND
10 kOhms | RES SMD 10K OHM 1% 1/10W 0603 | R5, R6, R7, R9, R10, R11, R12, R17, R19, R21, R22, R23, R24, R25, R26, R27, R28, R29, R30, R31, R32, R33, R34, R35, R36, R38, R46, R47_IC101, R47_IC102, R47_IC103, R47_IC104, R47_IC105, R48_IC101, R48_IC102, R48_IC103, R48_IC104, R48_IC105, R49_IC101, R49_IC102, R49_IC103, R49_IC104, R49_IC105, R50, R78, R79, R80, R81, R82, R83, R84, R85, R86, R106, R107, R109, | 57 | 0.01, [NoParam] | ERJ-3EKF1002V | DigiKey, [NoParam] | P10.0KHCT-ND, [NoParam]
5.6 kOhms | RES SMD 5.6K OHM 0.5% 1/10W 0603 | R13, R14, R15, R16 | | 4 0.01 | RT0603DRE075K6 L | DigiKey | 311-2635-1-ND
Value | RES SMD 0 OHM JUMPER 1/10W 0603 | R18 | | 1 0.01 | RCA06030000ZSEA | DigiKey | 541-2192-1-ND
1 kOhms | RES SMD 1K OHM 1% 1/10W 0603 | R20, R52, R127 | | 3 0.01 | CRCW06031K00FK EB | DigiKey | 541-2985-1-ND
100k | | R37 | | 1
7.5 kOhms 22 Ohms | RES 7.5K OHM 1% 1/10W 0603 SMD RES 22 OHM 5% 1/16W 0402 | R39 R40, R41, R54, R55, R56, R57, R58, R59, R60, R61, R62, R63, R64, R65, R66, R67, R68, R69, R70, R71, R104, R137, R140, R141, R142, R143, R144, R145, R146, R147, R148, R149, R150, R151, R152, R153, R154, R155, R156, R157, R158, R159, R160 | 43 | 1 0.01 0.01 | ERJ-U03F7501V RMCF0402JT22R0 | DigiKey DigiKey | 10-ERJ-U03F7501VCT-ND RMCF0402JT22R0CT-ND
10 Ohms | RES SMD 10 OHM 1% 1/3W 0603 | R42, R43, R44, R45, R102, R103, R105, R139 | 8 0.01 | ERJ-PA3F10R0V | DigiKey | P10.00BYCT-ND
2.7 kOhms | RES 2.7K OHM 1% 1/10W 0603 | R51 | 1 0.01 | CRCW06032K70FK EAC | DigiKey | 541-5328-1-ND
2 Ohms | RES 2 OHM 1% 1/10W 0603 SMD | R53 | 1 0.01 | ERJ-U03F2R00V | DigiKey | 10-ERJ-U03F2R00VCT-ND
500 mOhms | RES 0.5 OHM 1% 1/10W 0603 | R125 | 1 0.11 | RLT0816-C-R500-FNH | DigiKey | 2037-RLT0816-C-R500-FNHCT-ND
| RES SMD 1K OHM 1% 1/10W 0603 | R126 | 1 0.01 | CRCW06031K00FK EB | DigiKey | 541-2985-1-ND
51 kOhms | RES 51K OHM 1% 1/10W 0603 | R128, R131 | 2 0.01 | RMCF0603FT51K0 | DigiKey | RMCF0603FT51K0CT-ND
330 kOhms | RES 330K OHM 5% 1/10W 0603 | R129 | 1 0.01 | RMCF0603JG330K | DigiKey | RMCF0603JG330KCT-ND
220 kOhms | RES 220K OHM 1% 1/10W 0603 | R130 | 1 0.01 | CRCW0603220KFK EAC | DigiKey | 541-4039-1-ND
=Value | RES SMD 0 OHM JUMPER 1/10W 0603 | R135, R136 | 2 0.01 | RCA06030000ZSEA | DigiKey | 541-2192-1-ND
Kailh | Kailh keyboard switch, hotswap rgb, dual-side hotswap options + low prifile variant | SW1, SW2, SW3, SW4, SW5, SW6, SW7, SW8 | 8
UART4_TX | | TP1 | 1
UART4_RX SAI2_SCK | | TP2 TP3 | 1 1
SAI2_FS | | TP4 | 1
USER_DBG1 | | TP5 | 1
USER_DBG2 UART1_RX | | TP6 TP7 | 1 1
UART1_TX | | TP8 | 1
SOF | | TP9 | 1
UART1_RX_boot UART1_TX_boot | | TP10 TP11 | 1 1
ToPower | | TP12, TP13, TP14 | 3
ToBAT+ ToBAT- | | TP15 TP16 | 1 1
W9812G6KH-6 | | U1, U2, U3, U4 | 4
SN74LVC1G08DBVR | 1-ch, 2-input 1.65-V to 5.5-V 32 mA drive strength AND gate | U5, U7 | 2
H11L1 | OPTOISO 4.17KV OPN COLL 6SMD | U6 | 1
24MHz | CRYSTAL 24MHZ 9PF SMD | Y1, Y2 | 2 0.38 | NX3225SA-24MHZ-EXS00A-CS07532 | DigiKey | 644-1393-1-ND
ABS07-32.768KHZ-7-T | Crystal or Oscillator | Y3 | 1
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
