RATsynthesizers/FXcursion-HW/HW/Audio_testboard/Audio_testboard.pdf

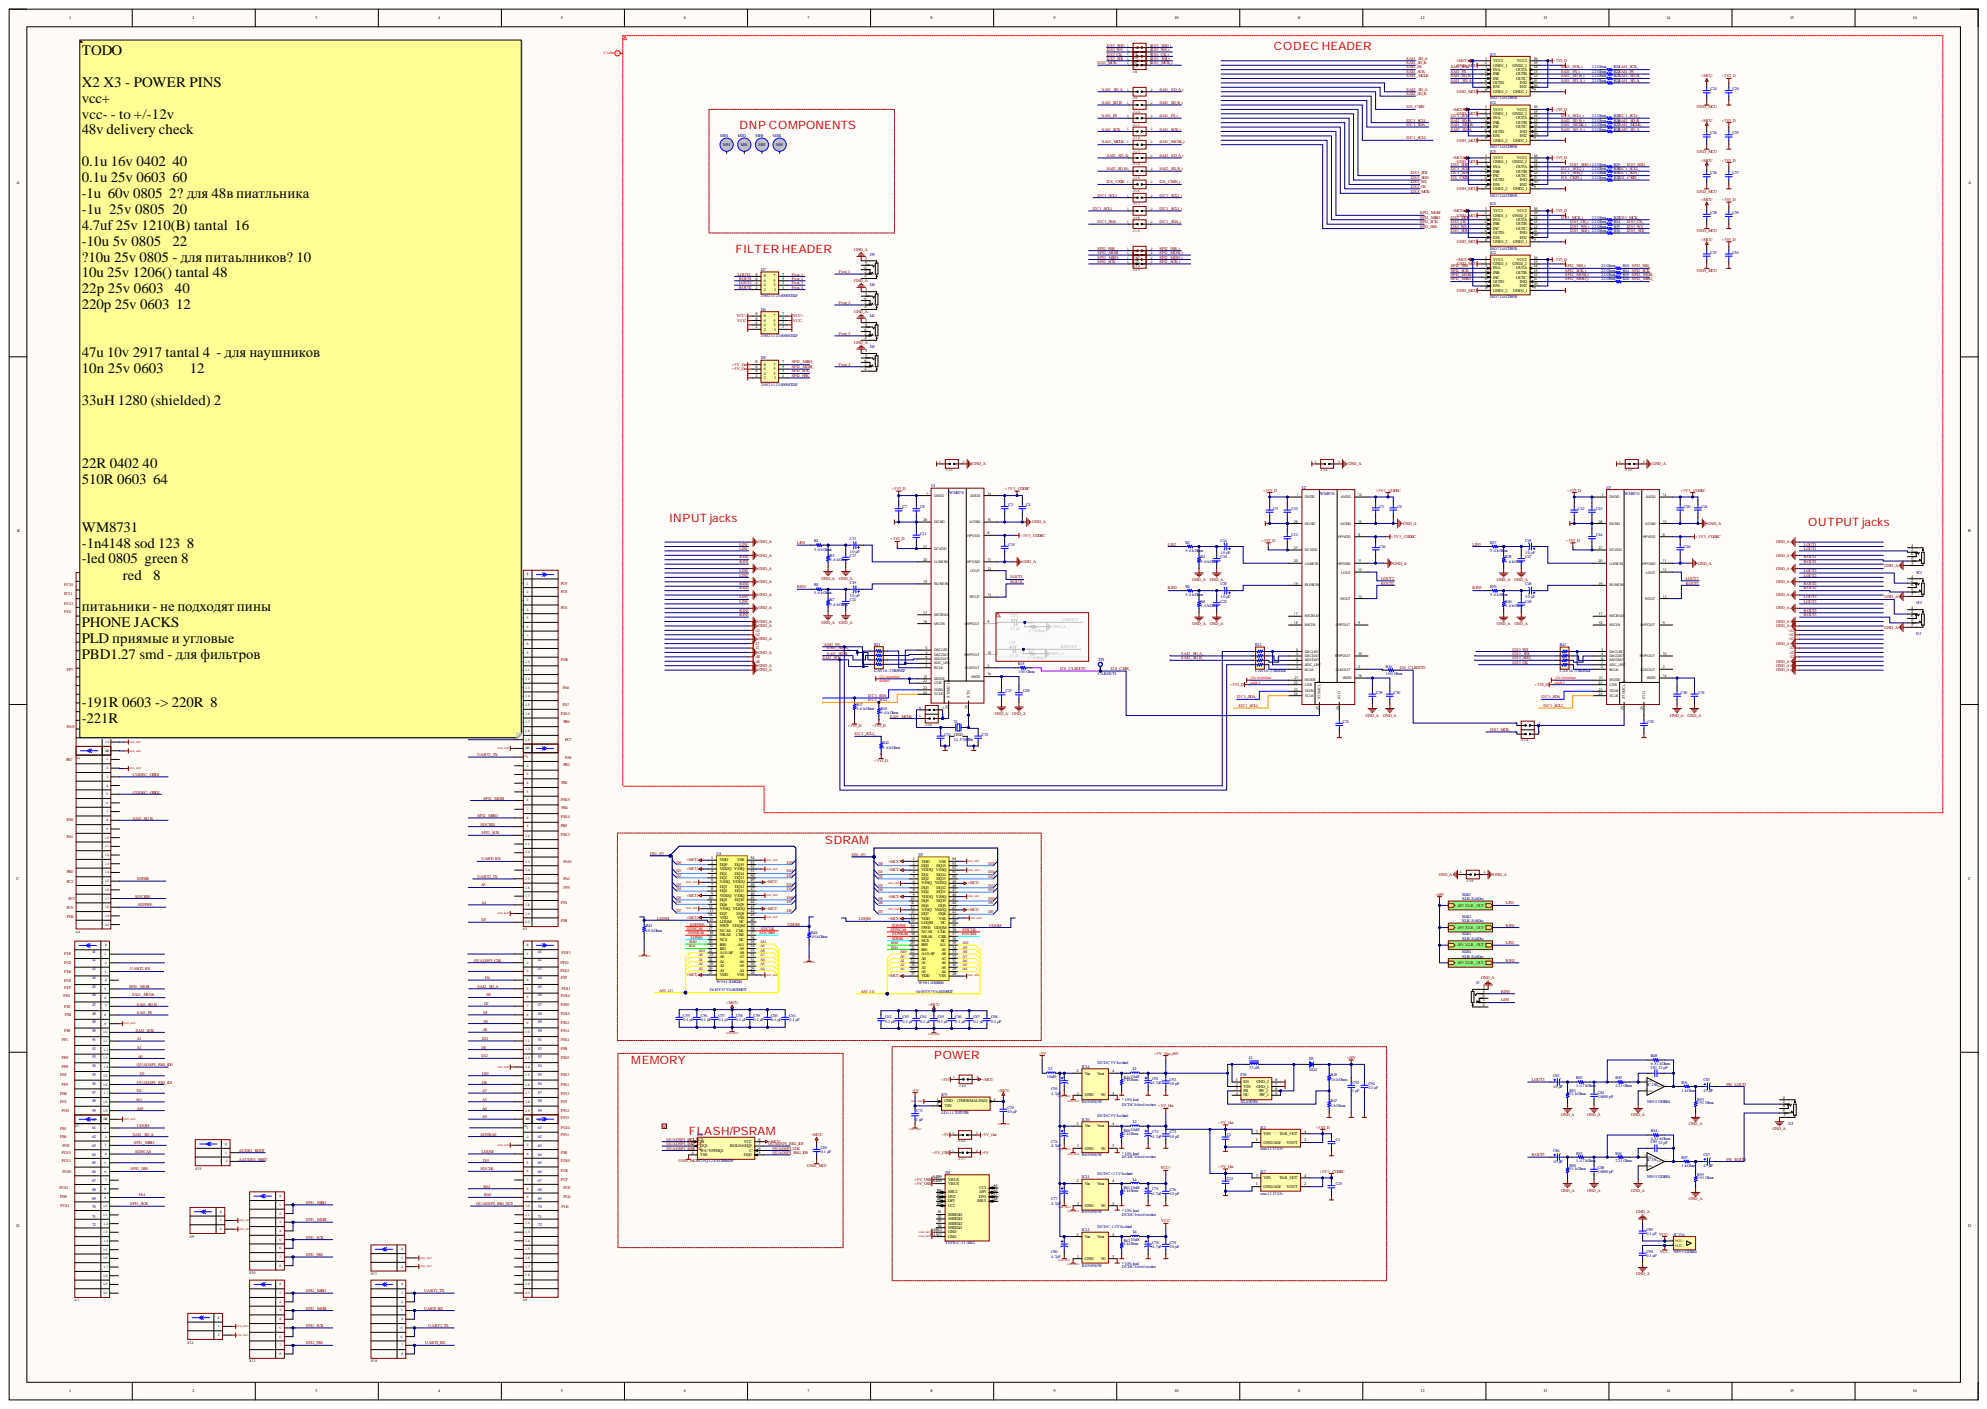
[picture p46: page 1]

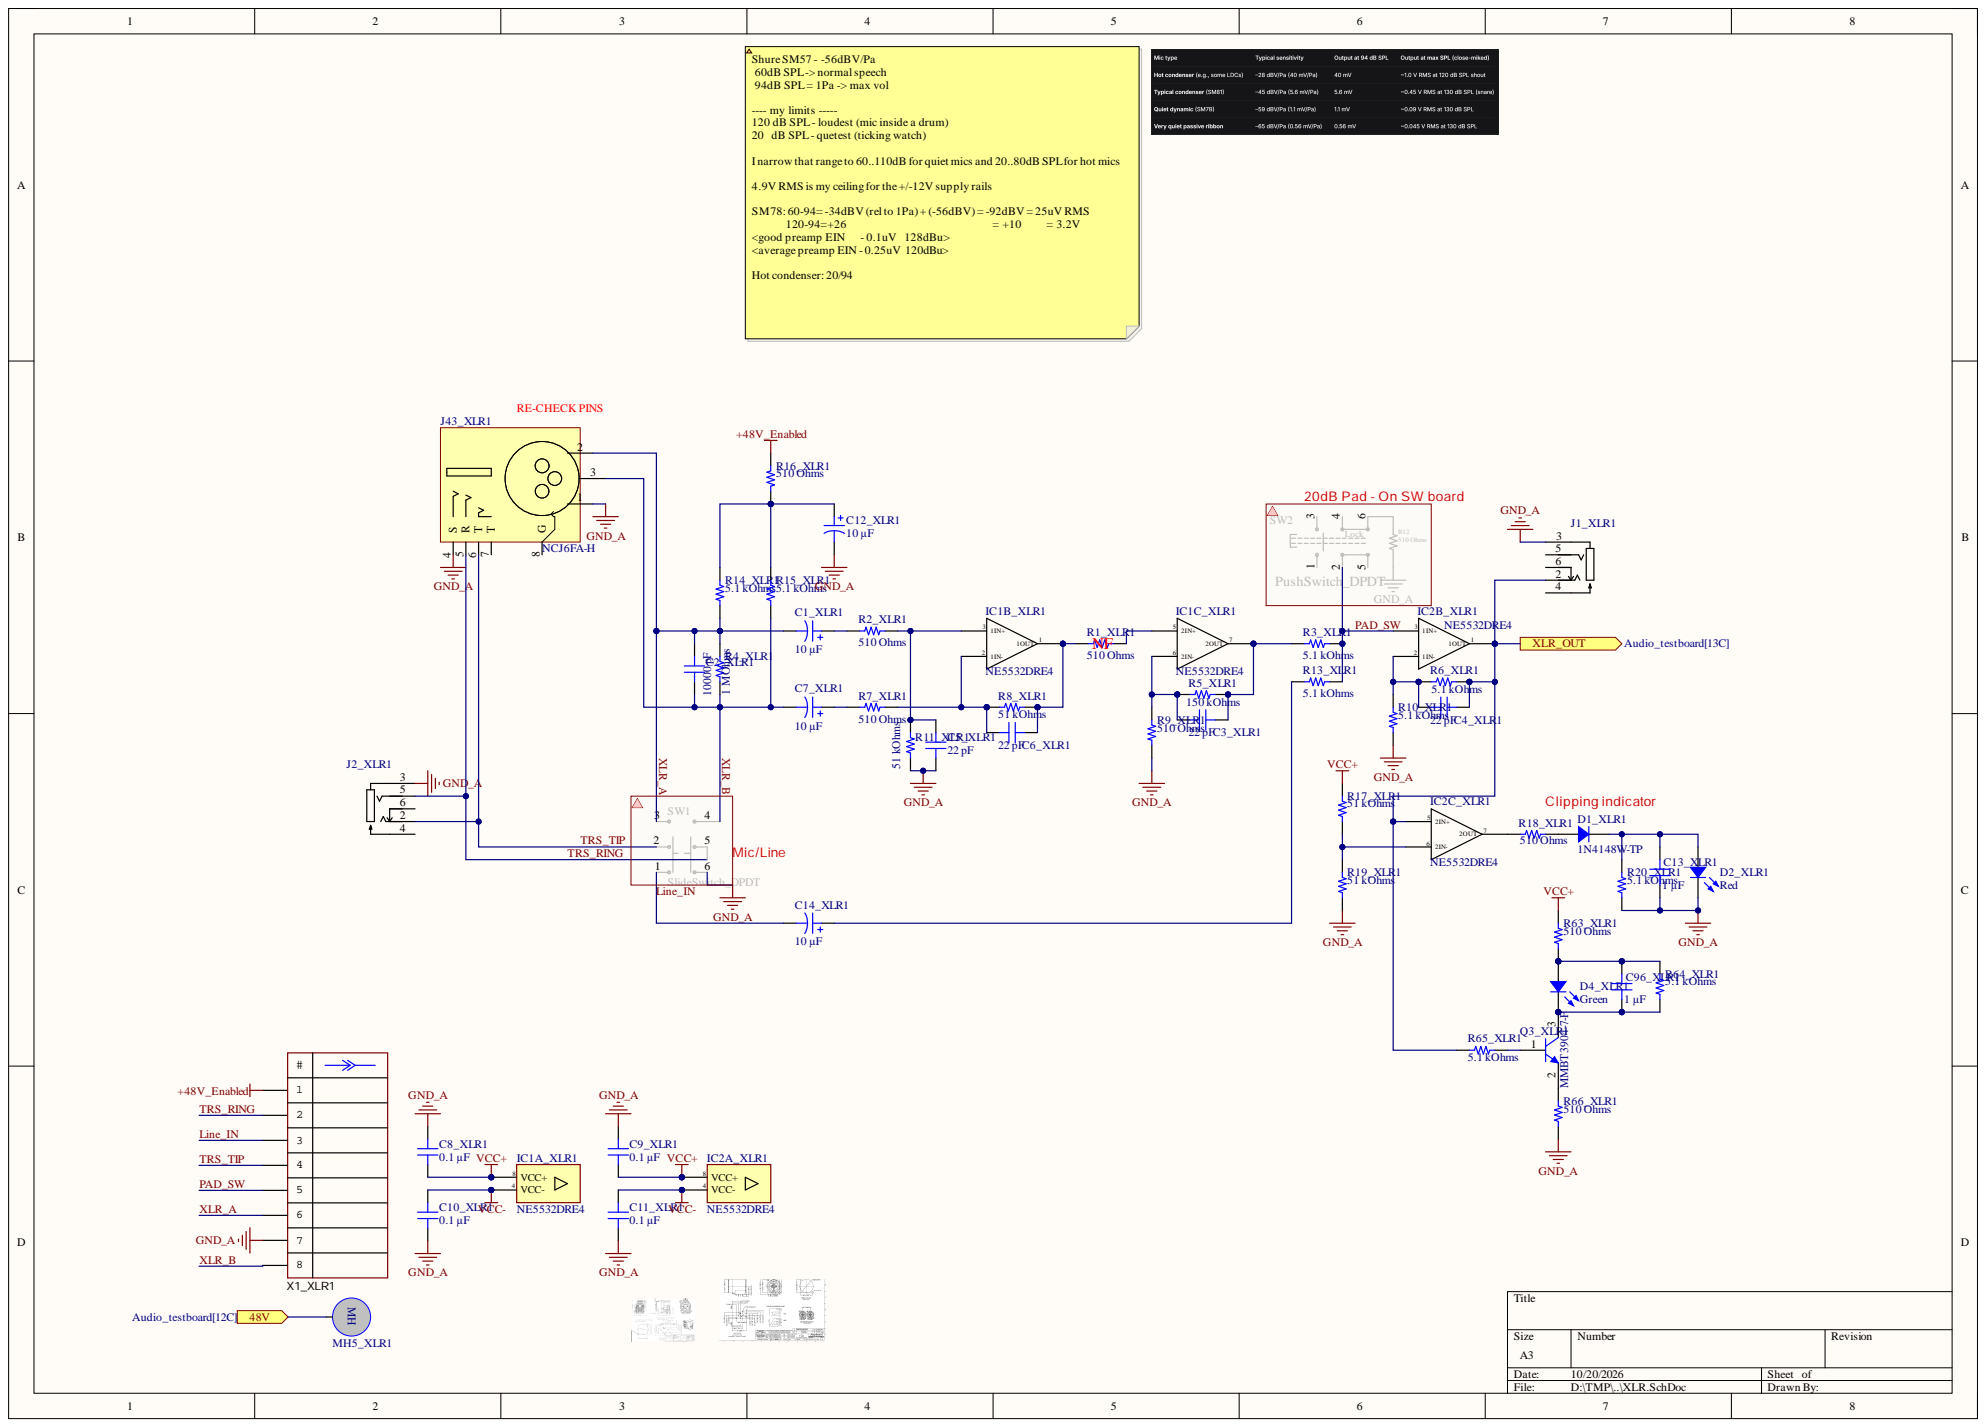
[picture p47: page 2]

---- my limits -----
120 dB SPL- loudest (mic inside a drum)
20 dB SPL- quetest (ticking watch)

I narrow that range to 60..110dB for quiet mics and 20..80dB SPLfor hot mics

4.9V RMS is my ceiling for the+/-12V supply rails

20dB Pad - On SW board

SlideSwitch_DPDT

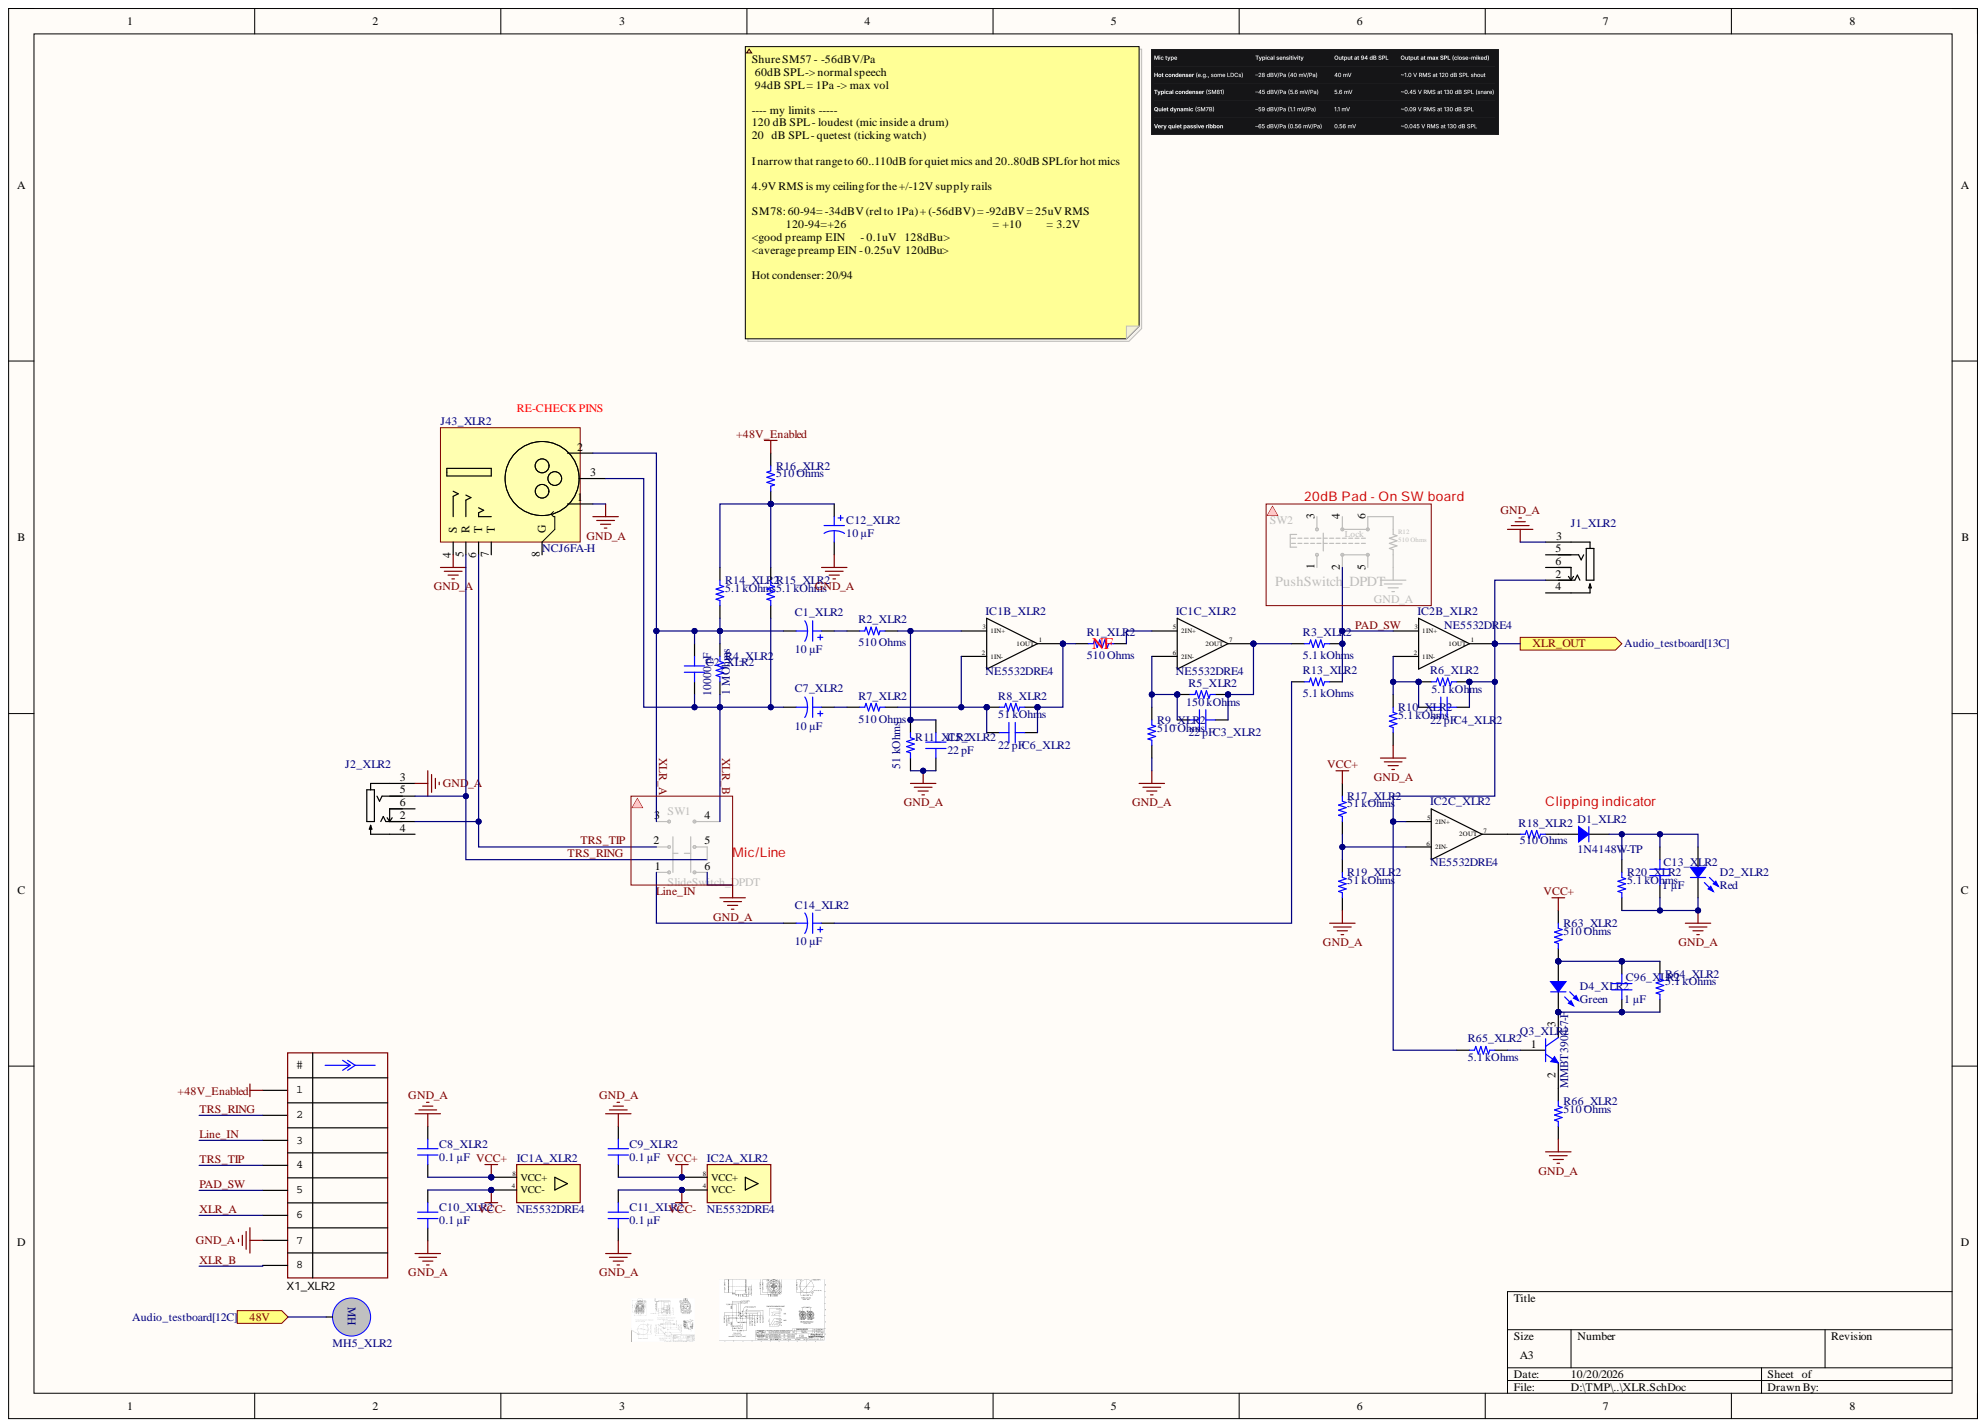
[picture p48: page 3]

---- my limits -----
120 dB SPL- loudest (mic inside a drum)
20 dB SPL- quetest (ticking watch)

I narrow that range to 60..110dB for quiet mics and 20..80dB SPLfor hot mics

4.9V RMS is my ceiling for the+/-12V supply rails

20dB Pad - On SW board

SlideSwitch_DPDT

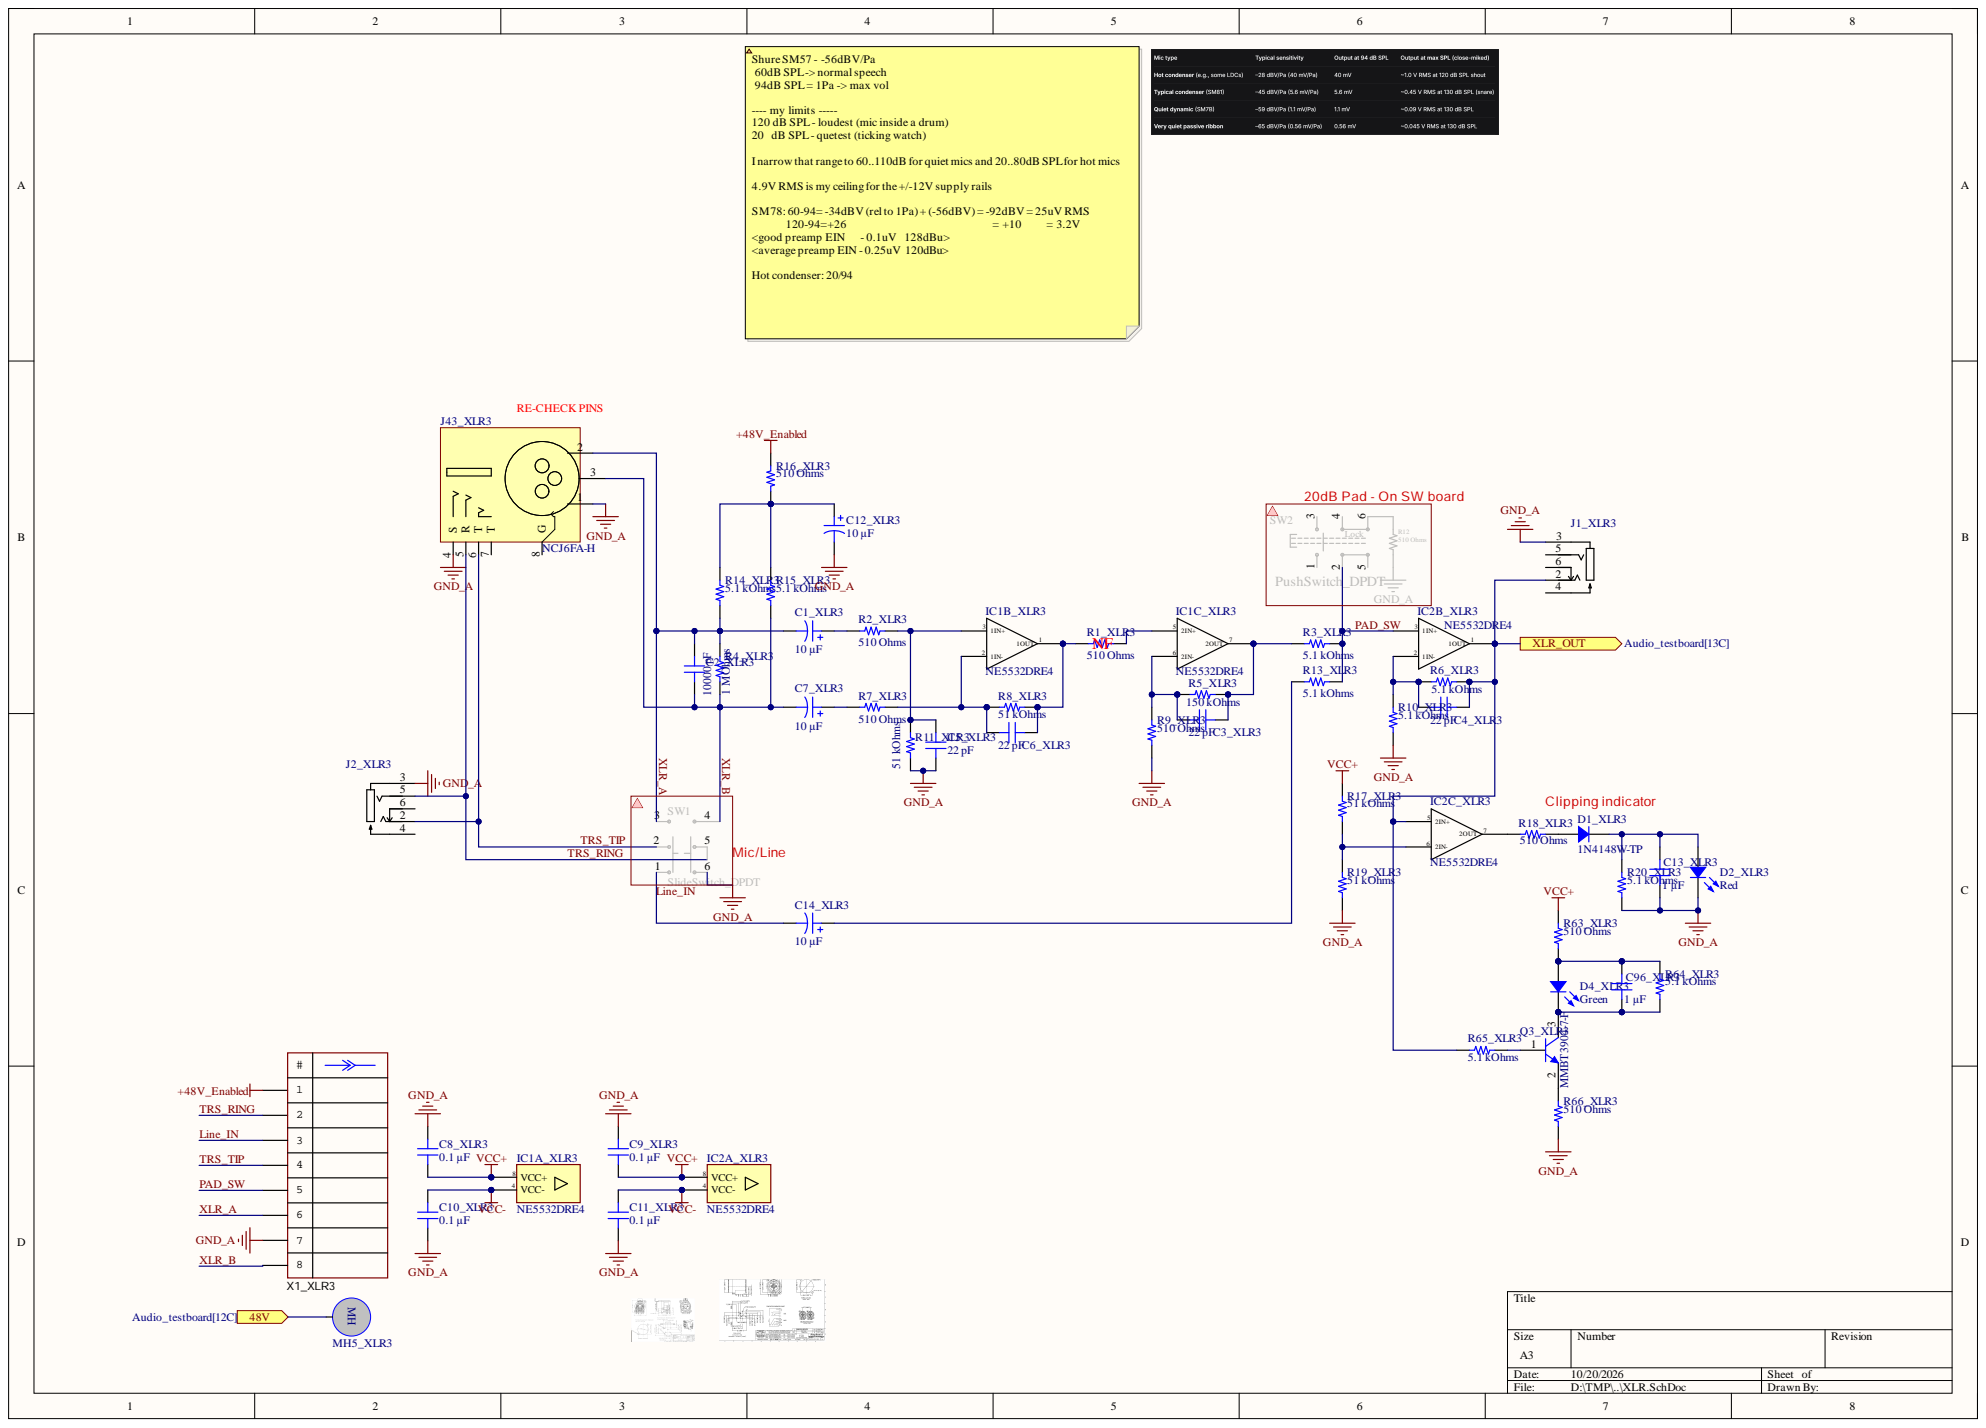
[picture p49: page 4]

---- my limits -----
120 dB SPL- loudest (mic inside a drum)
20 dB SPL- quetest (ticking watch)

I narrow that range to 60..110dB for quiet mics and 20..80dB SPLfor hot mics

4.9V RMS is my ceiling for the+/-12V supply rails

20dB Pad - On SW board

SlideSwitch_DPDT

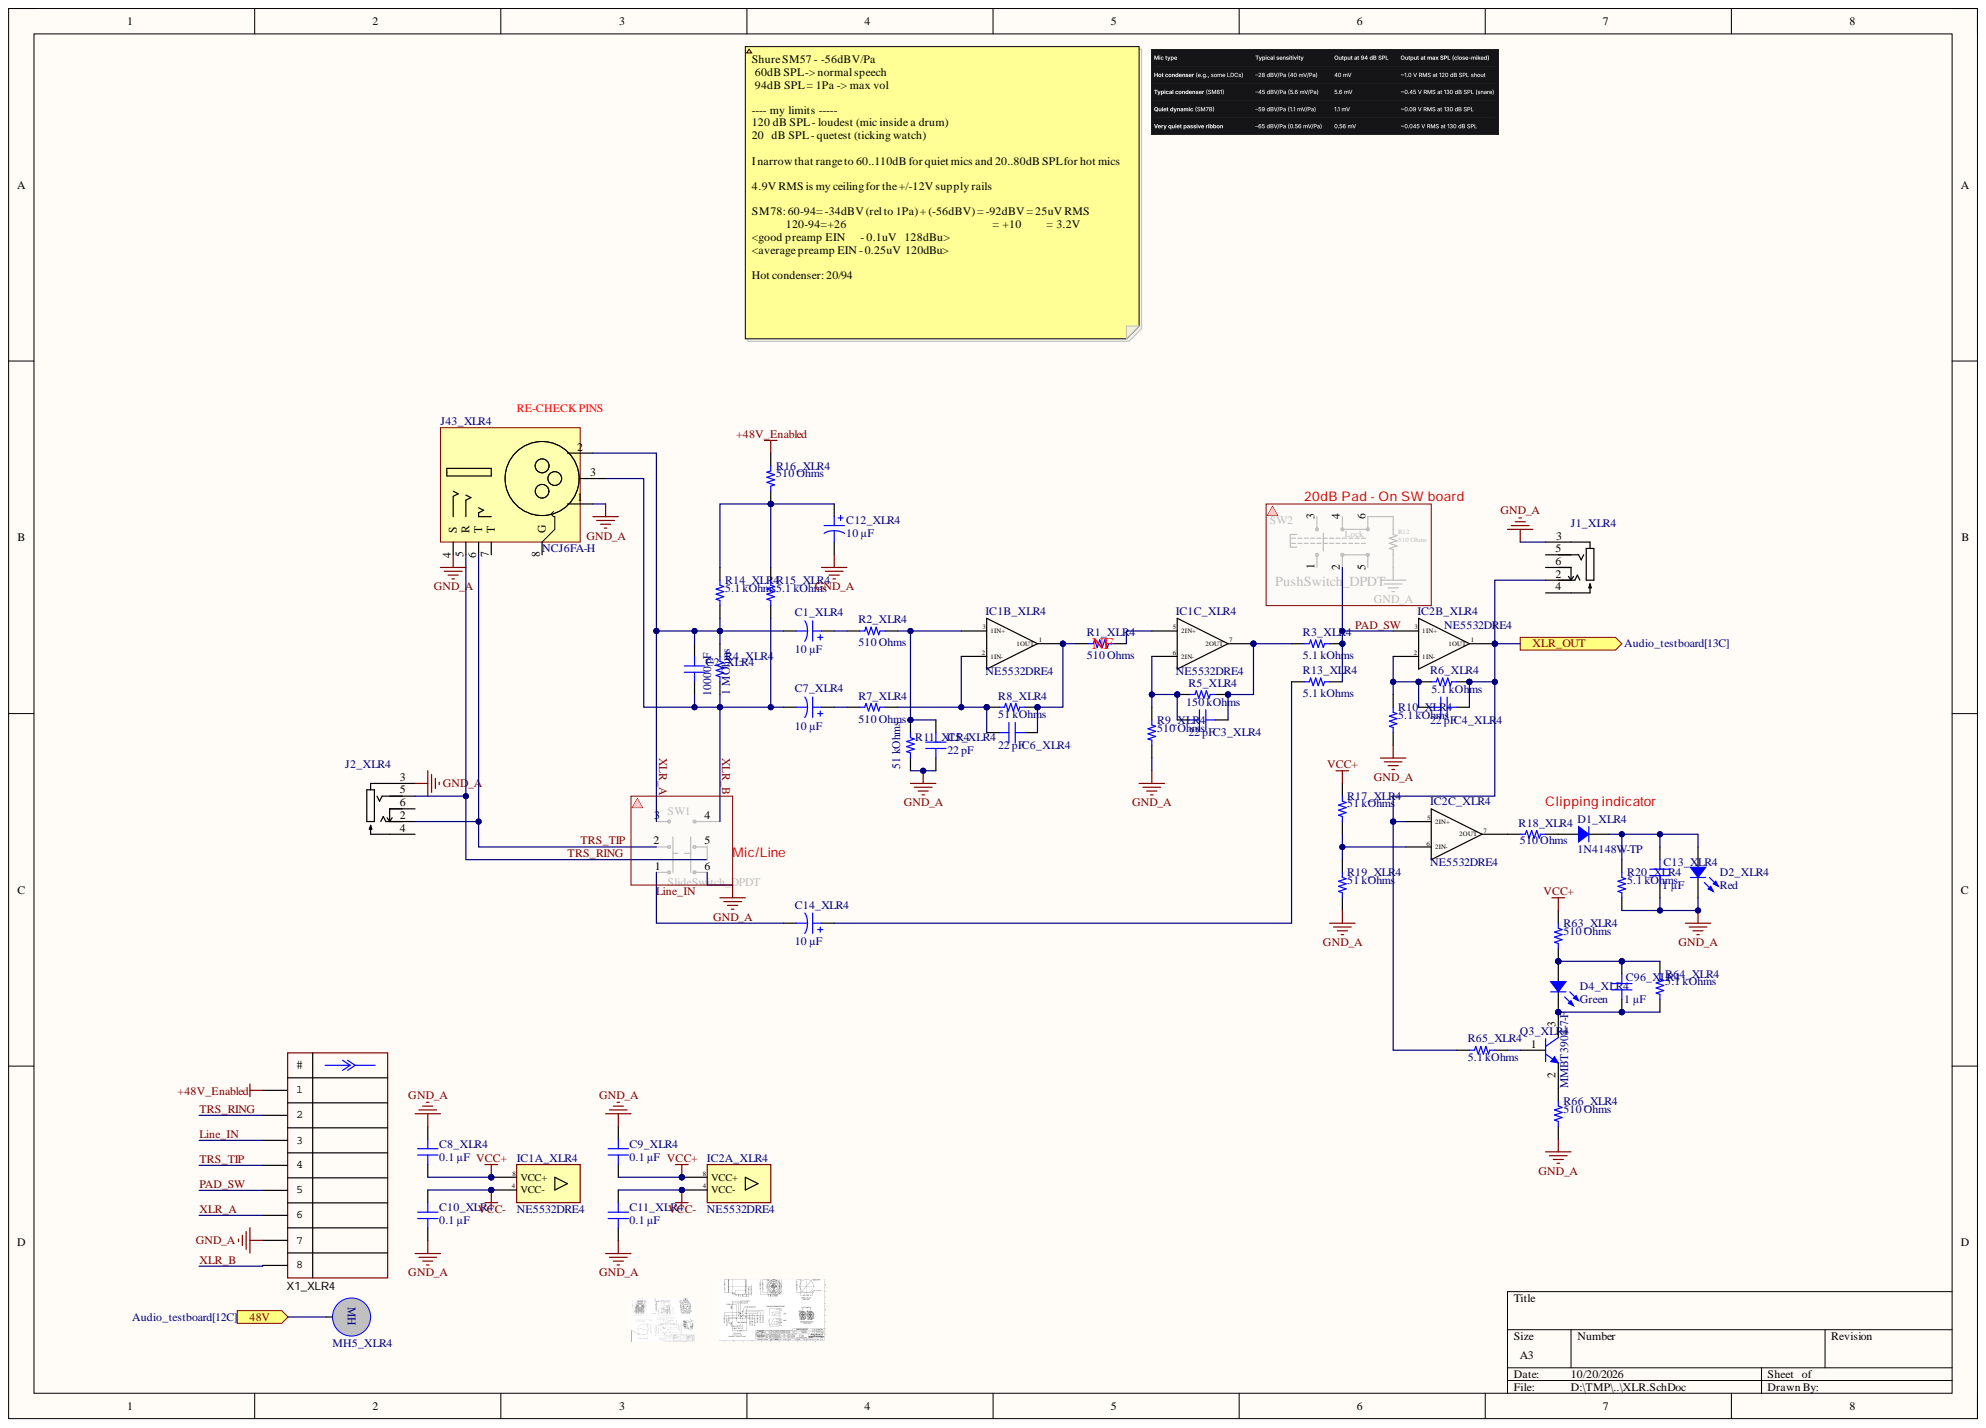
[picture p50: page 5]

---- my limits -----
120 dB SPL- loudest (mic inside a drum)
20 dB SPL- quetest (ticking watch)

I narrow that range to 60..110dB for quiet mics and 20..80dB SPLfor hot mics

4.9V RMS is my ceiling for the+/-12V supply rails

20dB Pad - On SW board

SlideSwitch_DPDT

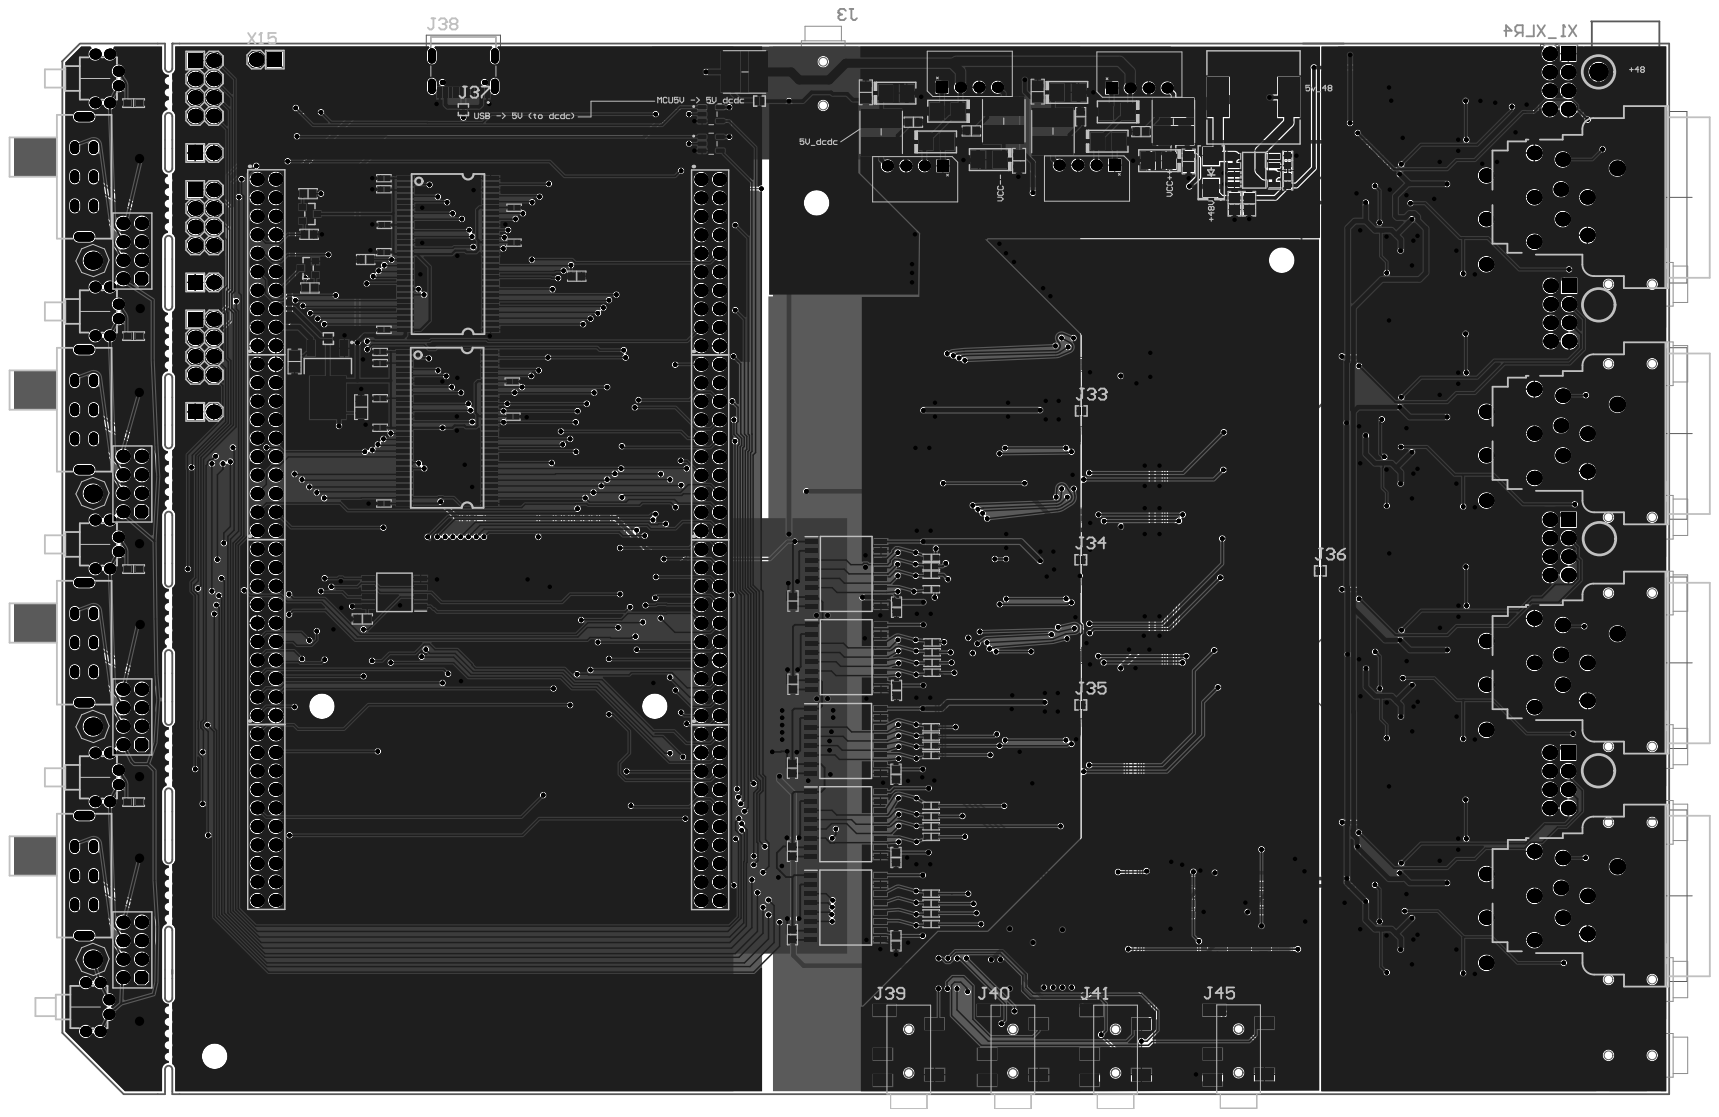
[picture p51: page 6]
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
