RATsynthesizers/FXcursion-HW/HW/_Docs/schematics/Main_board.pdf

# USB

NF

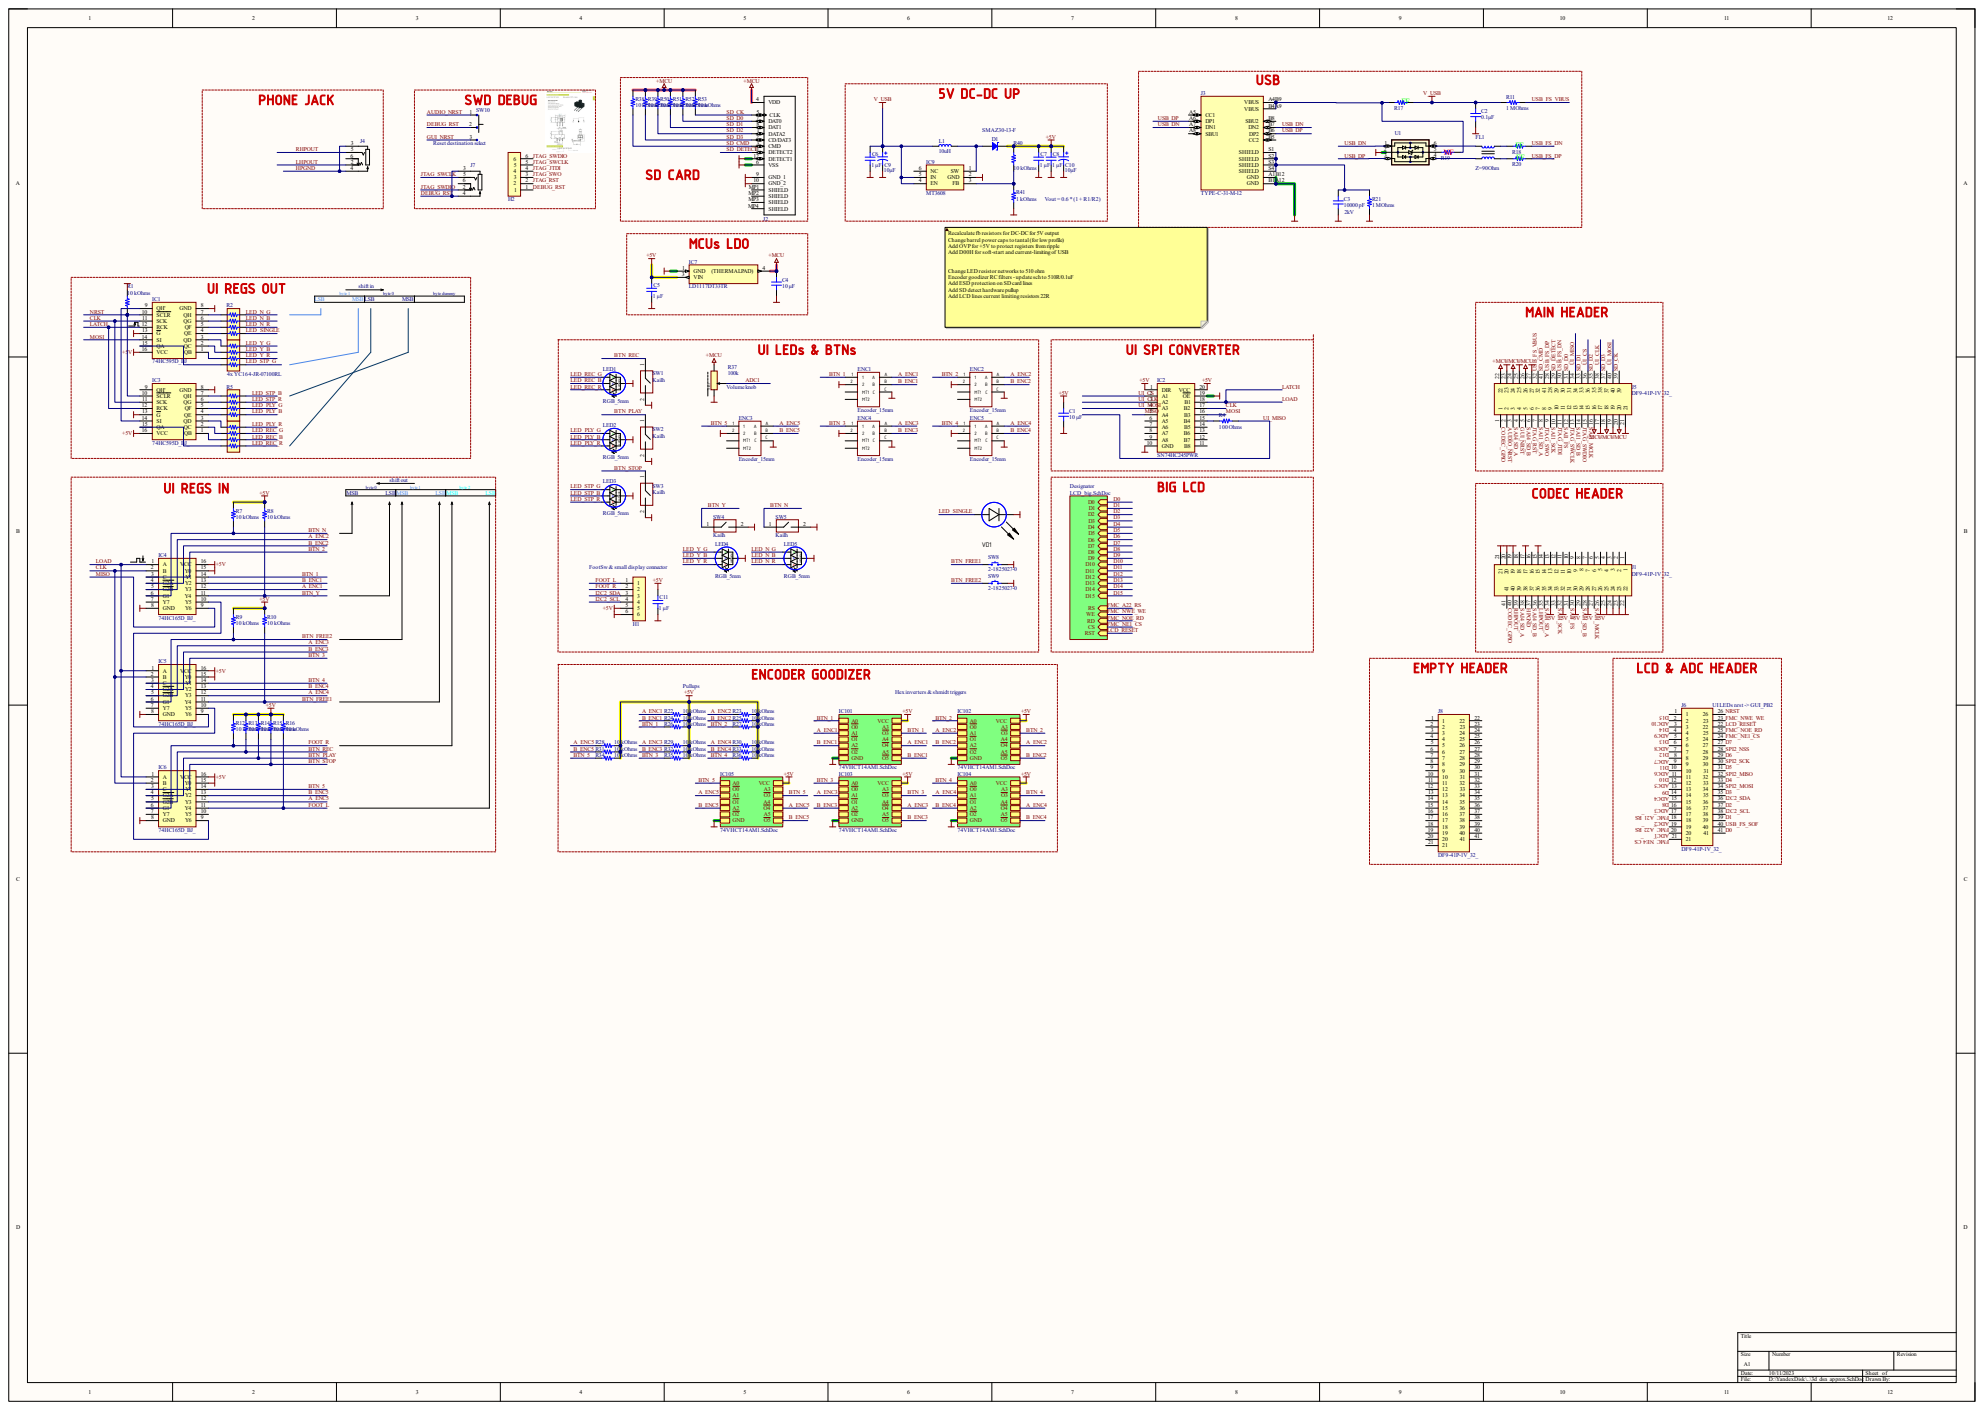
[picture p52: page 1]

Recalculate fb resistors for DC-DC for 5V output
Change barrel power caps to tantal (for low profile)
Add OVP for +5V to protect registers from ripple
Add D00H for soft-start and current-limiting of USB

Change LED resistor networks to 510 ohm
Encoder goodizer RC filters - update sch to 510R/0.1uF
Add ESD protection on SD card lines
Add SD detect hardware pullup
Add LCD lines current limiting resistors 22R

FootSw & small display connector

Hex inverters & shmidt triggers

11

22

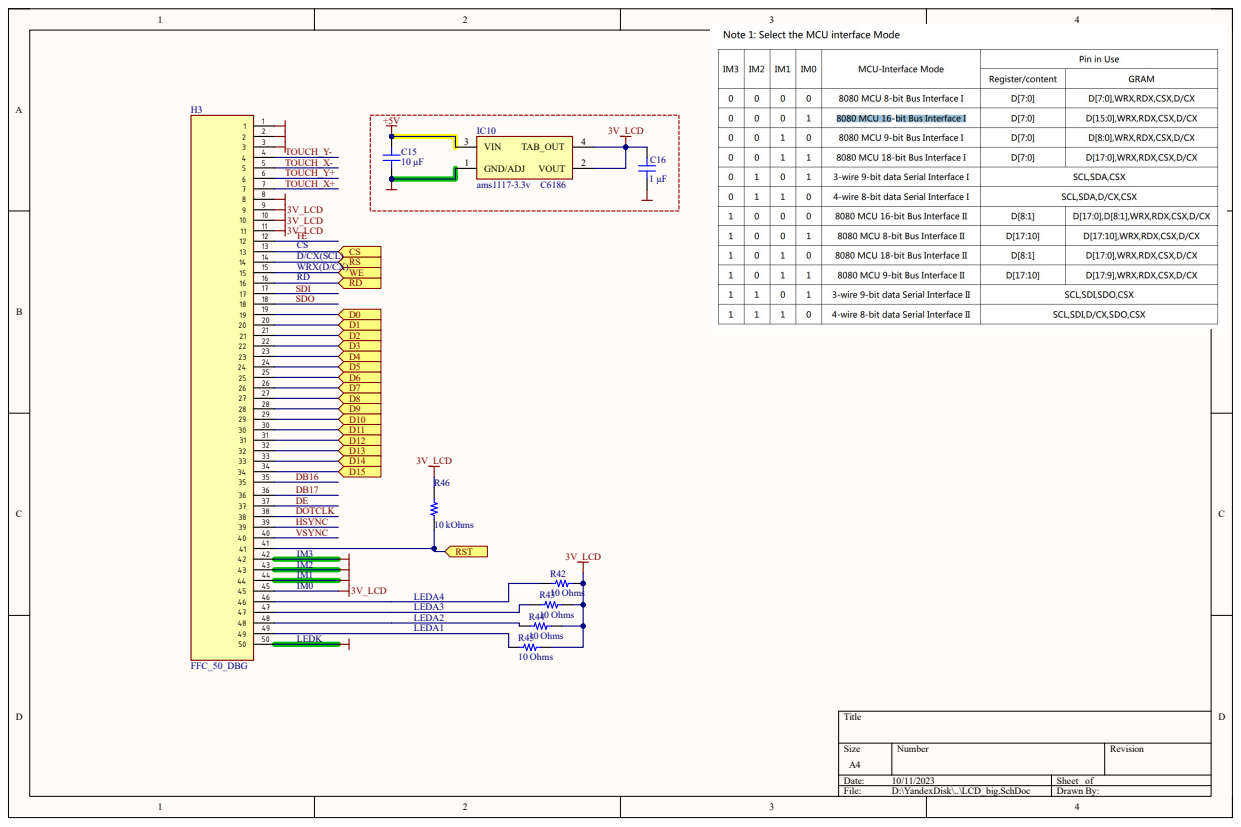
[picture p53: page 2]

1

2

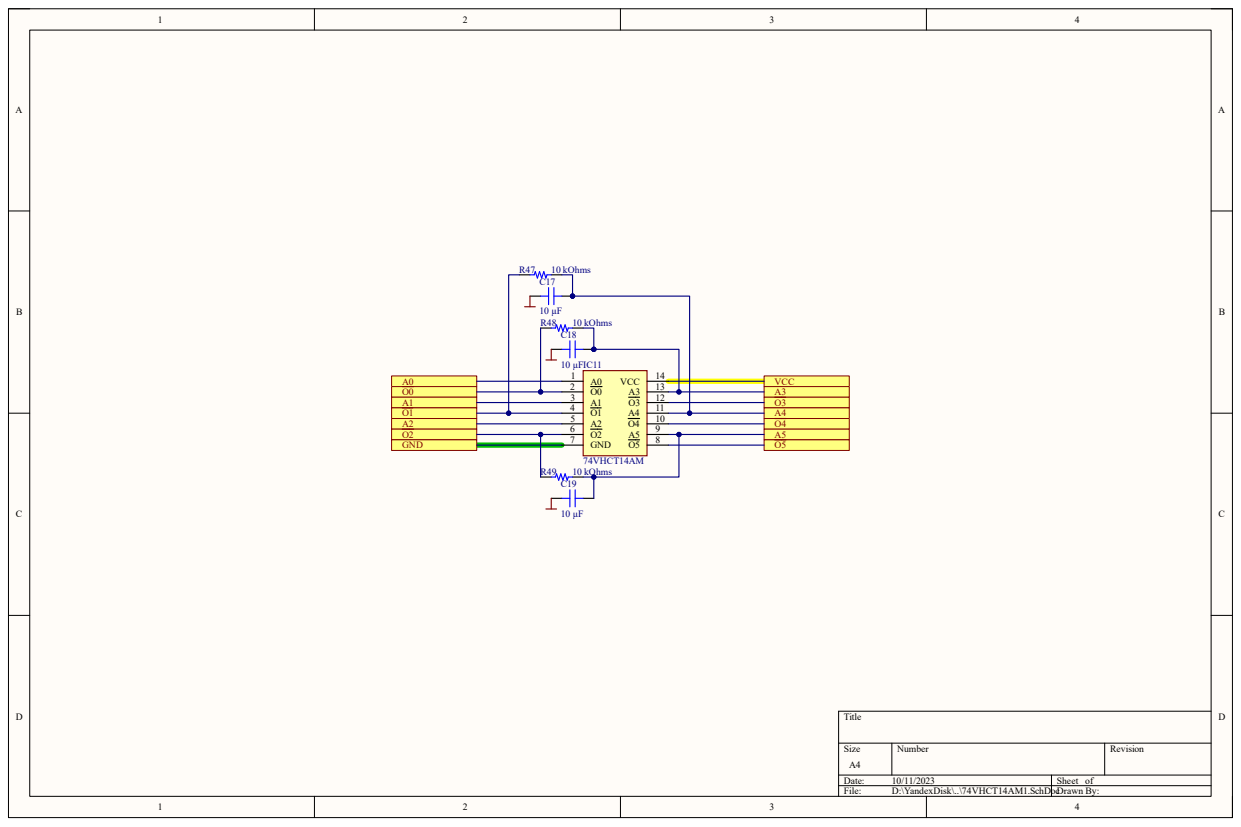
[picture p54: page 3]
Title; Size; Number; Revision; Date:; Sheet of; File:; D:\YandexDisk\..\74VHCT14AM1.SchDocDrawn By:; A0 O0 A1 O1 A2 O2 GND; VCC A3 O3 A4 O4 A5 O5; 10 kOhms; A0 1 O0 2 A1 3 O1 4 A2 5 O2 6 GND 7; VCC; 74VHCT14AM
