RATsynthesizers/FXcursion-HW/HW/H743ZI_SD_LCD_DRAM_Dev/H743ZI_SD_LCD_DRAM_Dev.pdf

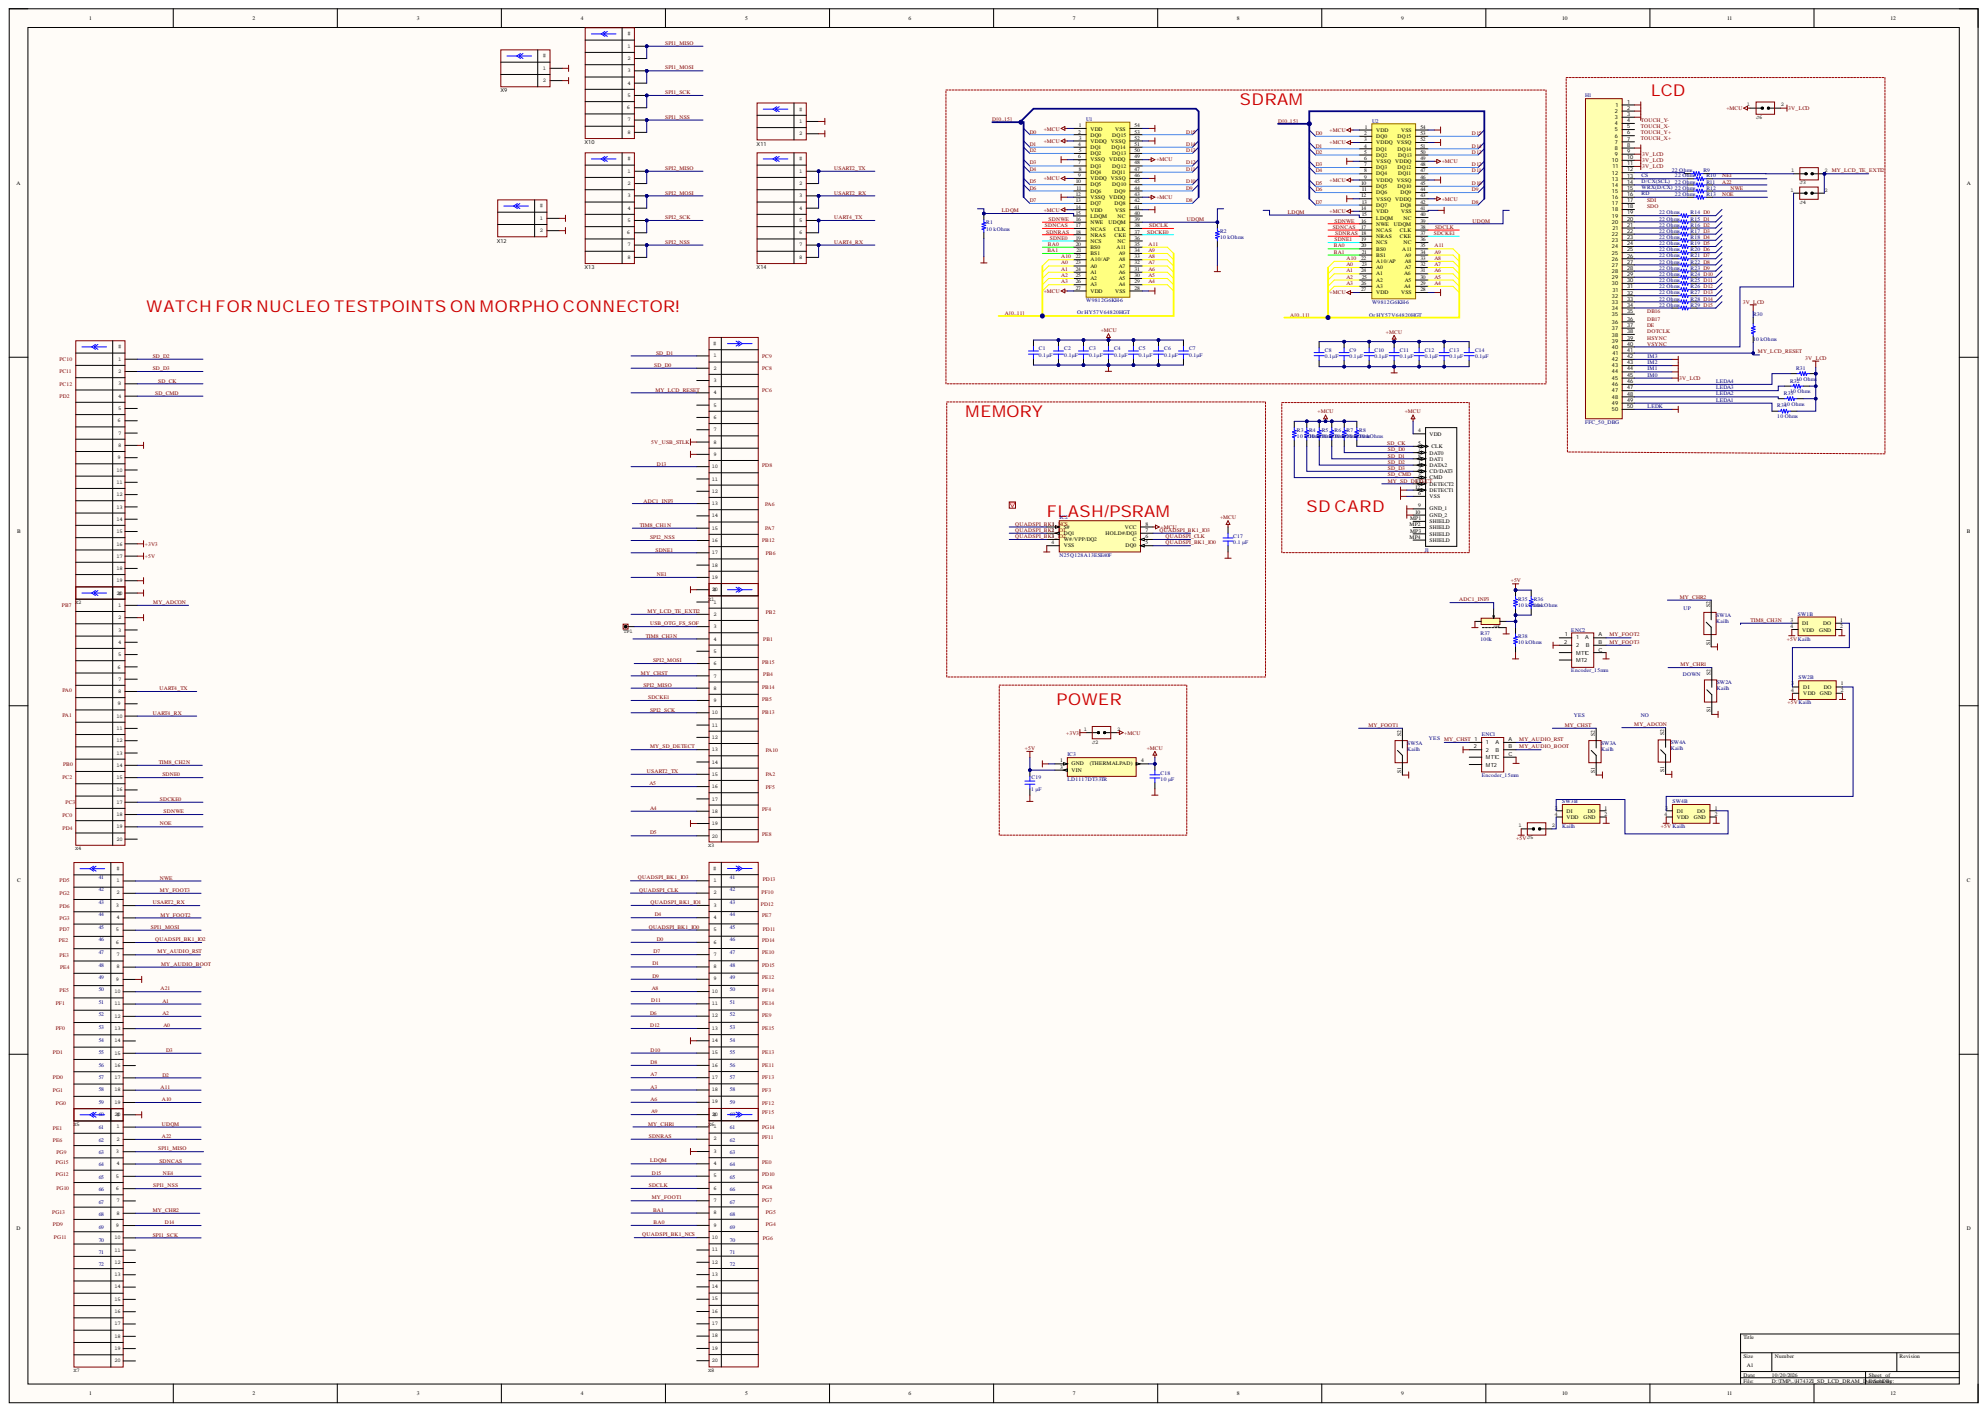
[picture p55: page 1]

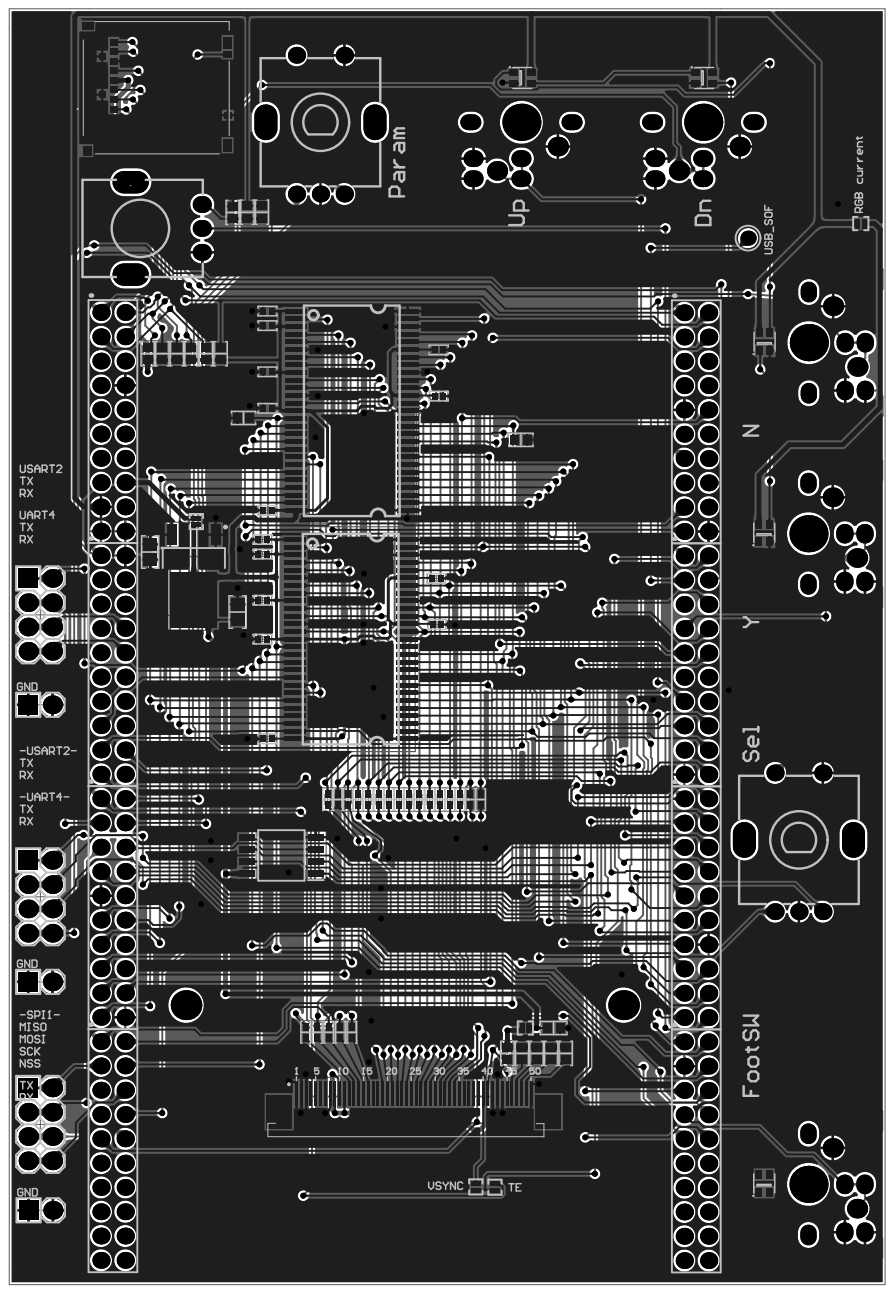
[picture p56: page 2]
