RATsynthesizers/FXcursion-HW/HW/_Docs/xlr/cdr-u-plm-daten-webseite-einlesen-in-sap-2019-03-26-zeichnungen-acjc10hl-bulk.pdf

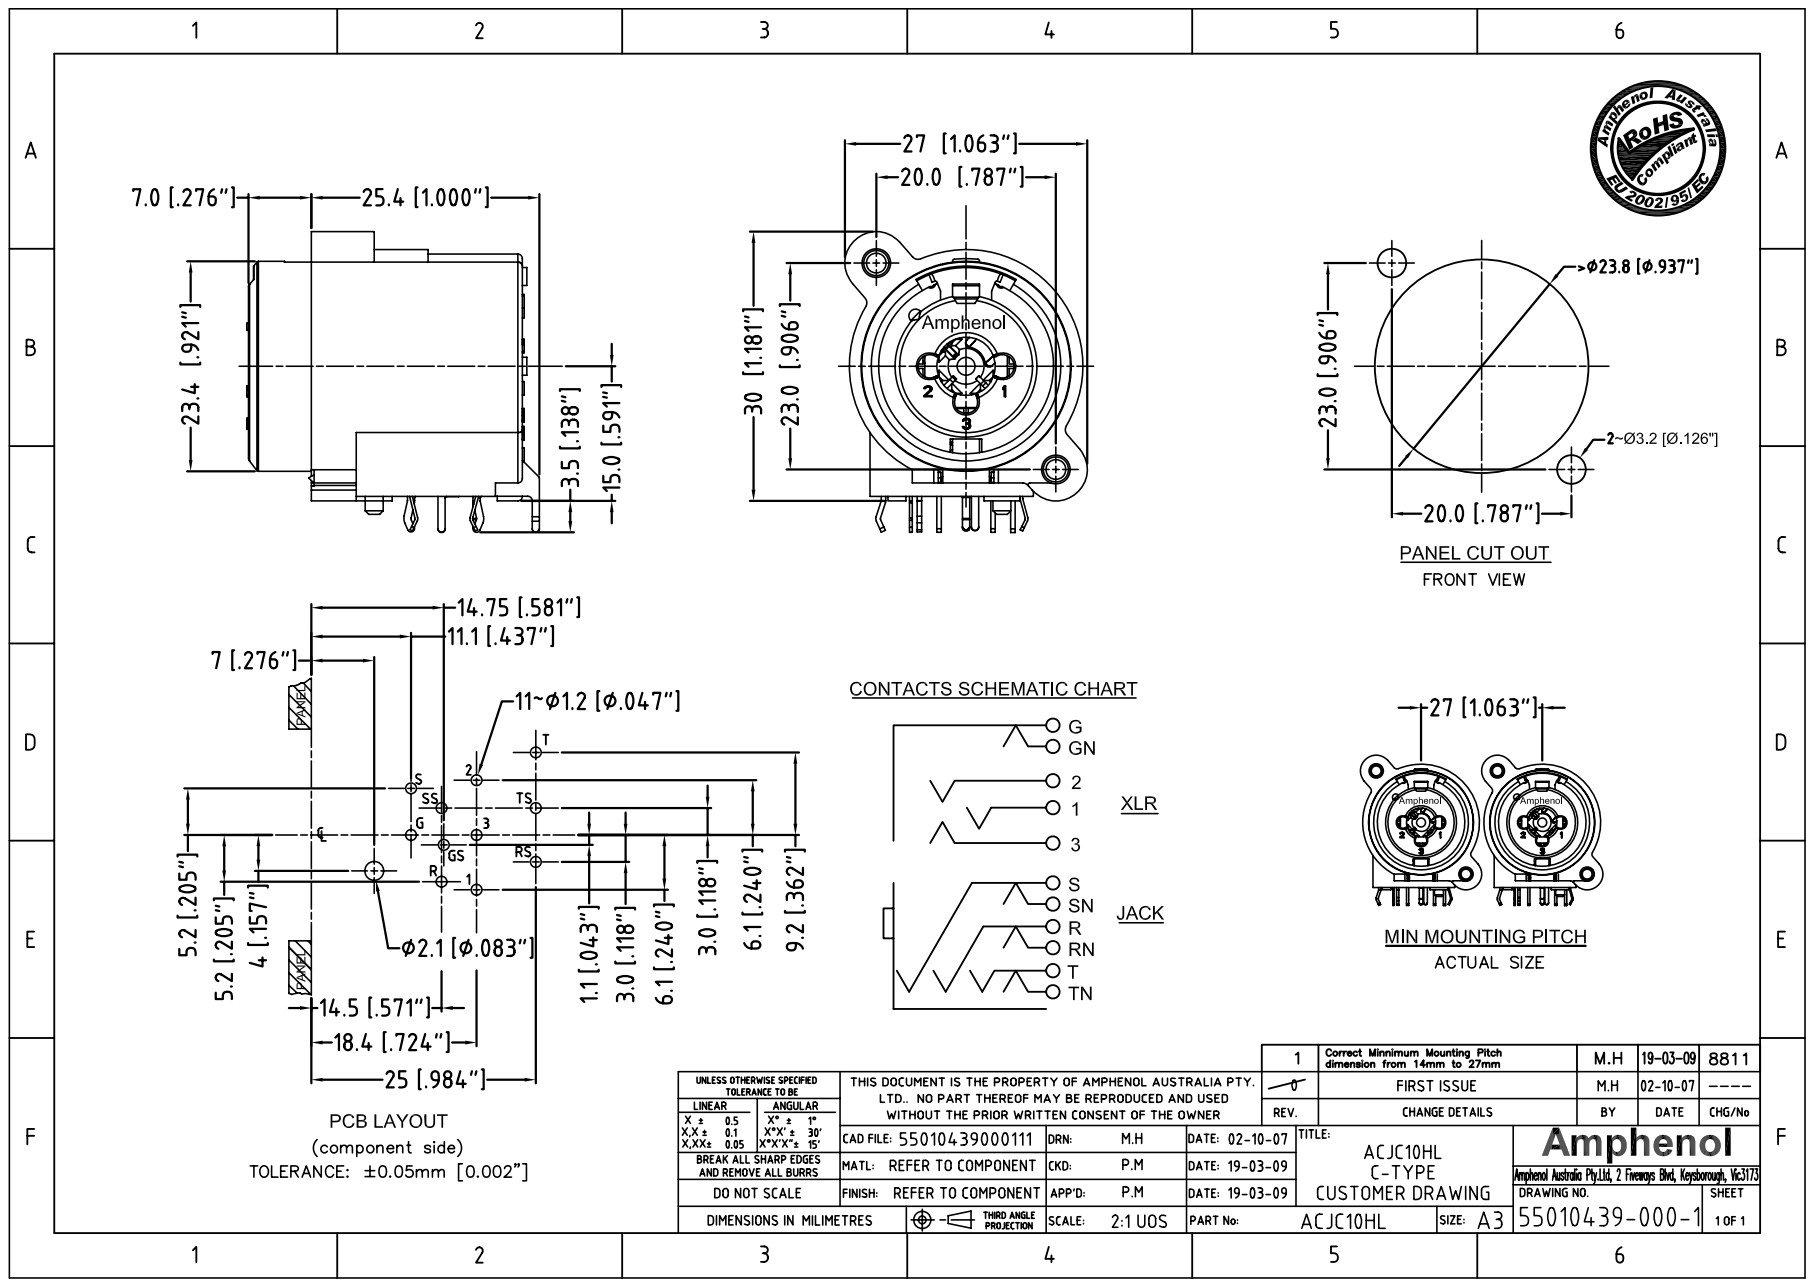
[picture p57: page 1]
