RATsynthesizers/FXcursion-HW/(list of files, drawings)

Other design files:
3d tmp/3d for picture/foot pcb/foot.PcbDoc
3d tmp/3d for picture/jacks pcb/jacks.PcbDoc
3d tmp/3d for picture/LCD_pcb/LCD.PcbDoc
3d tmp/3d for picture/main pcb/main.PcbDoc
3d tmp/3d for picture/xlr_pcb/xlr.PcbDoc
3d tmp/3d for picture/xlr_pcb/xlr_buttons.PcbDoc
HW/3D_design_approx/3d_dsn_approx - Copy.SchDoc
HW/3D_design_approx/3d_dsn_approx.SchDoc
HW/3D_design_approx/74VHCT14AM1.SchDoc
HW/3D_design_approx/Codec_CN.SchDoc
HW/3D_design_approx/FOOT_CN.SchDoc
HW/3D_design_approx/JACKS.SchDoc
HW/3D_design_approx/LCD_big.SchDoc
HW/3D_design_approx/LOOP_LEDS.SchDoc
HW/3D_design_approx/main.PcbDoc
HW/3D_design_approx/main_old.PcbDoc
HW/3D_design_approx/MCU_AUDIO.SchDoc
HW/3D_design_approx/MCU_GUI.SchDoc
HW/3D_design_approx/MCUs.SchLib
HW/3D_design_approx/MIDI.SchDoc
HW/3D_design_approx/MISO_LSH.SchDoc
HW/3D_design_approx/Pedal_MB1/3d_design_approx.PcbLib
HW/3D_design_approx/Pedal_MB1/Pedal_MB.SCHLIB
HW/3D_design_approx/Pedal_MB.PrjPcb
HW/3D_design_approx/Pedal_SOM_MCU1/Pedal_SOM_MCU.SCHLIB
HW/3D_design_approx/Pedal_SOM_MCU1/SOM_MCU.PcbLib
HW/3D_design_approx/Pedal_SOM_MCU/Pedal_SOM_MCU.SCHLIB
HW/3D_design_approx/Pedal_SOM_MCU/SOM_MCU.PcbLib
HW/3D_design_approx/Power.SchDoc
HW/3D_design_approx/SOM_MCU.SchDoc
HW/3D_design_approx/UI.SchDoc
HW/3D_design_approx/USB_DBG.SchDoc
HW/_bkp/Copy of ProtoStack_H750VBT.PcbDoc
HW/_bkp/ProtoStack_H750VBT_altium.PcbDoc
HW/_Modelling/DC-DC_filt/filter40-60khz.ms14
HW/_Modelling/XLR In/input stage.ms14
HW/Audio_testboard/Audio_testboard.PcbDoc
HW/Audio_testboard/Audio_testboard.PrjPcb
HW/Audio_testboard/Audio_testboard.SchDoc
HW/Audio_testboard/XLR.SchDoc
HW/FootSW/FootSW.PcbDoc
HW/FootSW/FootSW.SchDoc
HW/FootSW/FootSW_old.PcbDoc
HW/FootSW/Pedal_FootSW.PrjPcb
HW/H743ZI_SD_LCD_DRAM_Dev/Docs/NUCLEO-144pins_Altium_Schematics-Layout/Connectors.SchDoc
HW/H743ZI_SD_LCD_DRAM_Dev/Docs/NUCLEO-144pins_Altium_Schematics-Layout/Ethernet.SchDoc
HW/H743ZI_SD_LCD_DRAM_Dev/Docs/NUCLEO-144pins_Altium_Schematics-Layout/MB1137.PcbDoc
HW/H743ZI_SD_LCD_DRAM_Dev/Docs/NUCLEO-144pins_Altium_Schematics-Layout/MB1137.PcbLib
HW/H743ZI_SD_LCD_DRAM_Dev/Docs/NUCLEO-144pins_Altium_Schematics-Layout/MB1137.PrjPCB
HW/H743ZI_SD_LCD_DRAM_Dev/Docs/NUCLEO-144pins_Altium_Schematics-Layout/MB1137.SchDoc
HW/H743ZI_SD_LCD_DRAM_Dev/Docs/NUCLEO-144pins_Altium_Schematics-Layout/MB1137.SCHLIB
HW/H743ZI_SD_LCD_DRAM_Dev/Docs/NUCLEO-144pins_Altium_Schematics-Layout/MCU_144.SchDoc
HW/H743ZI_SD_LCD_DRAM_Dev/Docs/NUCLEO-144pins_Altium_Schematics-Layout/ST_LINK_V2-1.SCHDOC
HW/H743ZI_SD_LCD_DRAM_Dev/Docs/NUCLEO-144pins_Altium_Schematics-Layout/USB.SchDoc
HW/H743ZI_SD_LCD_DRAM_Dev/H743ZI_SD_LCD_DRAM_Dev.PcbDoc
HW/H743ZI_SD_LCD_DRAM_Dev/H743ZI_SD_LCD_DRAM_Dev.PrjPcb
HW/H743ZI_SD_LCD_DRAM_Dev/H743ZI_SD_LCD_DRAM_Dev.SchDoc
HW/Jacks/Jacks.PcbDoc
HW/Jacks/Jacks.SchDoc
HW/Jacks/Jacks_old.PcbDoc
HW/Jacks/Jacks_old_old.PcbDoc
HW/Jacks/Pedal_Jacks.PrjPcb
HW/Pedal_Back/Pedal_Back.PcbDoc
HW/Pedal_Back/Pedal_Back.PrjPcb
HW/Pedal_Back/Pedal_Back.SchDoc
HW/Pedal_Display/Pedal_Display.PcbDoc
HW/Pedal_Display/Pedal_Display.PrjPcb
HW/Pedal_Display/Pedal_Display.SchDoc
HW/Pedal_Filters/2Filters.SchDoc
HW/Pedal_Filters/Pedal_Filters.PcbDoc
HW/Pedal_Filters/Pedal_Filters.PrjPcb
HW/Pedal_Filters/Pedal_Filters.SchDoc
HW/Pedal_Filters/Pedal_Filters_45.PcbDoc
HW/Pedal_LoopLEDS/Pedal_LoopLEDS.PcbDoc
HW/Pedal_LoopLEDS/Pedal_LoopLEDS.PrjPcb
HW/Pedal_LoopLEDS/Pedal_LoopLEDS.SchDoc
HW/Pedal_Power/Pedal_Power.PcbDoc
HW/Pedal_Power/Pedal_Power.PrjPcb
HW/Pedal_Power/Pedal_Power.SchDoc
HW/Pedal_Power/PowerModule.PcbDoc
HW/Pedal_Power/PowerModule.PrjPcb
HW/Pedal_Power/PowerModule.SchDoc
HW/Pedal_SD_USB/Pedal_SD_USB.PcbDoc
HW/Pedal_SD_USB/Pedal_SD_USB.PrjPcb
HW/Pedal_SD_USB/Pedal_SD_USB.SchDoc
HW/Pedal_SW/Pedal_SW.PcbDoc
HW/Pedal_SW/Pedal_SW.PrjPcb
HW/Pedal_SW/Pedal_SW.SchDoc
HW/Pedal_SW/Pedal_SW_old.PcbDoc
HW/Pedal_WS2812/Pedal_WS2812.PcbDoc
HW/Pedal_WS2812/Pedal_WS2812.PrjPcb
HW/Pedal_WS2812/Pedal_WS2812.SchDoc
HW/Pedal_WS2812/Pedal_WS2812_old.PcbDoc
HW/Pedal_XLR/analog_tmp.SchDoc
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
