RATsynthesizers/FXcursion-HW/HW/_Docs/schematics/microphone-preamp-master/microphone-preamp.kicad_pcb

## KiCad design HW/_Docs/schematics/microphone-preamp-master/microphone-preamp.kicad_pcb (2025-07-26)

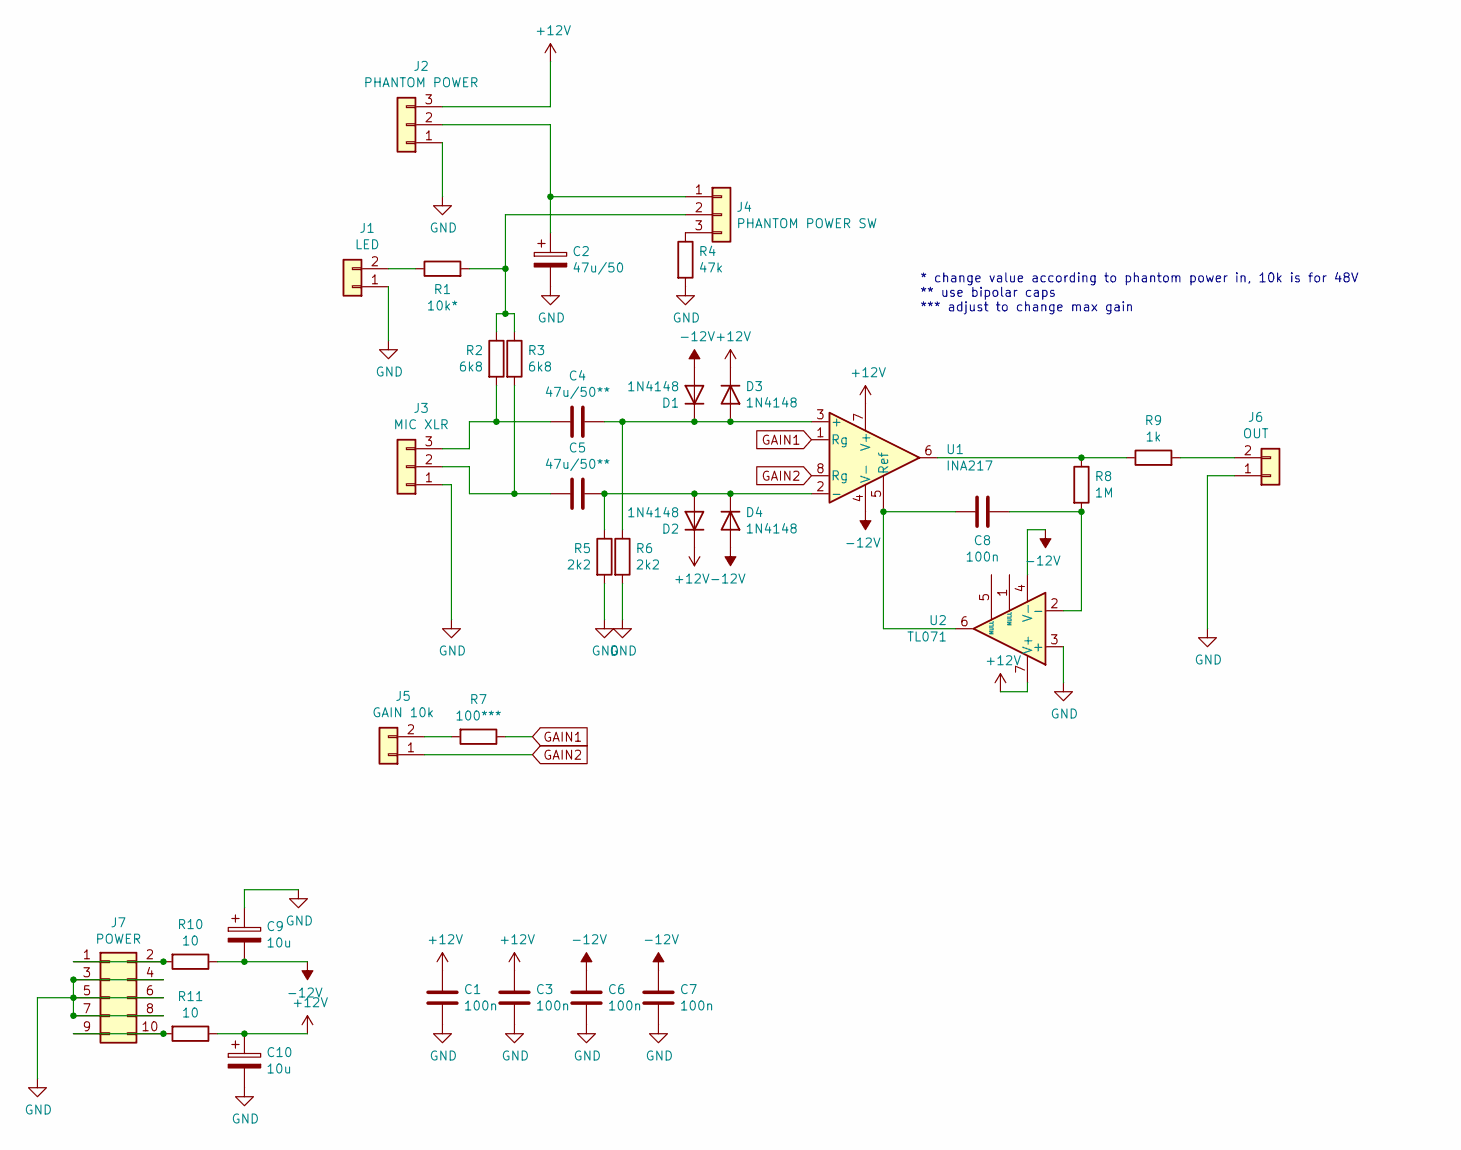
[picture p58: schematic microphone-preamp.sch, Microphone preamp with phantom power]

Parts:
C1, C3, C6, C7, C8: 100n; C_Disc_D3.0mm_W2.0mm_P2.50mm
C2: 47u/50; CP_Radial_D6.3mm_P2.50mm
C4, C5: 47u/50**; C_Radial_D10.0mm_H12.5mm_P5.00mm
C9, C10: 10u; CP_Radial_D5.0mm_P2.50mm
D1, D2, D3, D4: 1N4148; D_DO-35_SOD27_P7.62mm_Horizontal
J1: LED; Molex_KK-254_AE-6410-02A_1x02_P2.54mm_Vertical
J2: PHANTOM POWER; Molex_KK-254_AE-6410-03A_1x03_P2.54mm_Vertical
J3: MIC XLR; Molex_KK-254_AE-6410-03A_1x03_P2.54mm_Vertical
J4: PHANTOM POWER SW; Molex_KK-254_AE-6410-03A_1x03_P2.54mm_Vertical
J5: GAIN 10k; Molex_KK-254_AE-6410-02A_1x02_P2.54mm_Vertical
J6: OUT; Molex_KK-254_AE-6410-02A_1x02_P2.54mm_Vertical
J7: POWER; IDC-Header_2x05_P2.54mm_Vertical
R1: 10k*; R_Axial_DIN0207_L6.3mm_D2.5mm_P10.16mm_Horizontal
R2, R3: 6k8; R_Axial_DIN0207_L6.3mm_D2.5mm_P10.16mm_Horizontal
R4: 47k; R_Axial_DIN0207_L6.3mm_D2.5mm_P10.16mm_Horizontal
R5, R6: 2k2; R_Axial_DIN0207_L6.3mm_D2.5mm_P10.16mm_Horizontal
R7: 100***; R_Axial_DIN0207_L6.3mm_D2.5mm_P10.16mm_Horizontal
R8: 1M; R_Axial_DIN0207_L6.3mm_D2.5mm_P10.16mm_Horizontal
R9: 1k; R_Axial_DIN0207_L6.3mm_D2.5mm_P10.16mm_Horizontal
R10, R11: 10; R_Axial_DIN0207_L6.3mm_D2.5mm_P10.16mm_Horizontal
U1: INA217; DIP-8_W7.62mm_Socket_LongPads
U2: TL071; DIP-8_W7.62mm_Socket_LongPads

Connections:
+12V: C1.1, C3.1, C10.1, D2.1 (K), D3.1 (K), J2.3, R11.1, U1.7 (V+), U2.7 (V+)
-12V: C6.1, C7.1, C9.2, D1.2 (A), D4.2 (A), R10.1, U1.4 (V-), U2.4 (V-)
GAIN1: R7.1, U1.1 (Rg)
GAIN2: J5.1, U1.8 (Rg)
GND: C1.2, C2.2, C3.2, C6.2, C7.2, C9.1, C10.2, J1.1, J2.1, J3.1, J6.1, J7.3, J7.4, J7.5, J7.6, J7.7, J7.8, R4.2, R5.2, R6.2, U2.3 (+)
unnamed: C2.1, J2.2, J4.1
unnamed: C4.1, J3.3, R2.2
unnamed: C4.2, D1.1 (K), D3.2 (A), R6.1, U1.3 (+)
unnamed: C5.1, J3.2, R3.2
unnamed: C5.2, D2.2 (A), D4.1 (K), R5.1, U1.2 (-)
unnamed: C8.1, R8.2, U2.2 (-)
unnamed: C8.2, U1.5 (Ref), U2.6
unnamed: J1.2, R1.1
unnamed: J4.2, R1.2, R2.1, R3.1
unnamed: J4.3, R4.1
unnamed: J5.2, R7.2
unnamed: J6.2, R9.2
unnamed: J7.1, J7.2, R10.2
unnamed: J7.9, J7.10, R11.2
unnamed: R8.1, R9.1, U1.6

Notes on the sheet:
* change value according to phantom power in, 10k is for 48V ** use bipolar caps *** adjust to change max gain

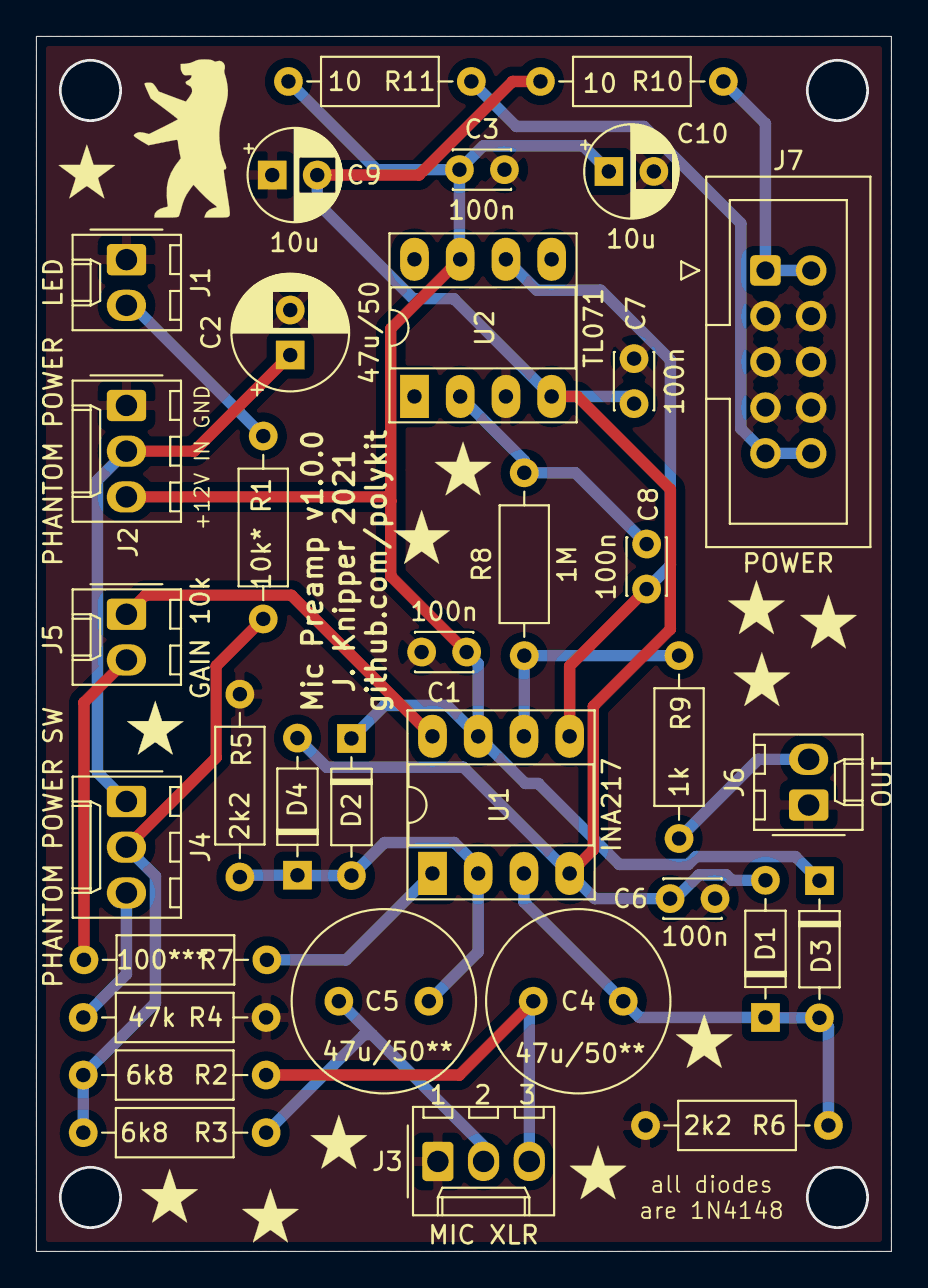
[picture p59: board microphone-preamp.kicad_pcb from above]

Board: 2 copper layers, 47.5 x 67.5 mm, 34 parts (0 on the bottom side), 20 nets.
