RATsynthesizers/FXcursion-HW/HW/_Docs/_AUDIO_PINOUT/_AUDIO_PINOUT.ioc

Mcu.UserName=STM32H743ZITx
PA0.Signal=SAI2_SD_B
PA10.Signal=USART1_RX
PA11.GPIO_Label=USER_DBG2
PA11.Signal=GPIO_Output
PA12.GPIO_Label=USER_DBG1
PA12.Signal=GPIO_Output
PA2.Signal=USART2_TX
PA3.Signal=USART2_RX
PA7.Signal=FMC_SDNWE
PA9.Signal=USART1_TX
PB10.Signal=I2C2_SCL
PB11.Signal=I2C2_SDA
PB12.Signal=SPI2_NSS
PB13.Signal=SPI2_SCK
PB14.Signal=SPI2_MISO
PB15.Signal=SPI2_MOSI
PB5.Signal=FMC_SDCKE1
PB6.Signal=FMC_SDNE1
PB8.Signal=I2C1_SCL
PB9.Signal=I2C1_SDA
PC10.Signal=I2S3_CK
PC11.Signal=I2S3_SDI
PC12.Signal=I2S3_SDO
PC13.GPIO_Label=USER_CODEC_GPIO1
PC13.Signal=GPIO_Output
PC3_C.Signal=FMC_SDCKE0
PC4.Signal=FMC_SDNE0
PC7.Signal=I2S3_MCK
PC9.Signal=I2S_CKIN
PD0.Signal=FMC_D2_DA2
PD1.Signal=FMC_D3_DA3
PD10.Signal=FMC_D15_DA15
PD11.Signal=SAI2_SD_A
PD12.Signal=SAI2_FS_A
PD13.Signal=SAI2_SCK_A
PD14.Signal=FMC_D0_DA0
PD15.Signal=FMC_D1_DA1
PD7.Signal=SPI1_MOSI
PD8.Signal=FMC_D13_DA13
PD9.Signal=FMC_D14_DA14
PE0.Signal=FMC_NBL0
PE1.Signal=FMC_NBL1
PE10.Signal=FMC_D7_DA7
PE11.Signal=FMC_D8_DA8
PE12.Signal=FMC_D9_DA9
PE13.Signal=FMC_D10_DA10
PE14.Signal=FMC_D11_DA11
PE15.Signal=FMC_D12_DA12
PE2.Signal=SAI1_MCLK_A
PE3.Signal=SAI1_SD_B
PE4.Signal=SAI1_FS_A
PE5.Signal=SAI1_SCK_A
PE6.Signal=SAI1_SD_A
PE7.Signal=FMC_D4_DA4
PE8.Signal=FMC_D5_DA5
PE9.Signal=FMC_D6_DA6
PF0.Signal=FMC_A0
PF1.Signal=FMC_A1
PF10.Signal=QUADSPI_CLK
PF11.Signal=FMC_SDNRAS
PF12.Signal=FMC_A6
PF13.Signal=FMC_A7
PF14.Signal=FMC_A8
PF15.Signal=FMC_A9
PF2.Signal=FMC_A2
PF3.Signal=FMC_A3
PF4.Signal=FMC_A4
PF5.Signal=FMC_A5
PF6.Signal=QUADSPI_BK1_IO3
PF7.Signal=QUADSPI_BK1_IO2
PF8.Signal=QUADSPI_BK1_IO0
PF9.Signal=QUADSPI_BK1_IO1
PG0.Signal=FMC_A10
PG1.Signal=FMC_A11
PG10.Signal=SPI1_NSS
PG11.Signal=SPI1_SCK
PG15.Signal=FMC_SDNCAS
PG4.Signal=FMC_A14_BA0
PG5.Signal=FMC_A15_BA1
PG6.Signal=QUADSPI_BK1_NCS
PG8.Signal=FMC_SDCLK
PG9.Signal=SPI1_MISO
