RATsynthesizers/FXcursion-HW/(commit log)

2023-10-15 add HW and 3D dirs
    [3PDT Body.prt, 3PDT Cover.prt, 3PDT Pin.prt, 3PDT Schalter.prt, 3PDT.prt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]
2023-10-19 Couple GND improves
2024-02-17 Added system diagram
    [bottom.stl, korp.stl, oled_stand.stl]
2024-02-17 Addeed FFC50 3d-model
    [LCD_big.SchDoc]
2024-02-17 Added FFC50 3d-model to main board
    [LCD_big.SchDoc]
2024-02-20 new test assebmbly with 18650 batteries and display pcb
    [18650 Li Ion Battery.STEP, 18650x2 holder.STEP, 3d_design_approx.brd]
2024-02-23 Korp & electronix updates
    Made new korp and korp retrofit for current boards. Changed FFC and rotated SD card on main board
    [3d_dsn_approx.SchDoc, filter40-60khz.ms14, korp - assy2 retrofit old HW.stl, stand holder.stl]
2024-02-23 Added EMC resistors to LCD FFC
    [3d_dsn_approx.SchDoc, LCD_big.SchDoc]
2024-02-24 Added 4pin debug sockets to main board
    Need to route debug + jtag + codec sai on all boards
    [3d_dsn_approx.SchDoc, Jack-audio-3.5mm(PJ-327F-5A).step, ProtoStack_H750VBT.SchLib]
2024-02-24 On SOM_MCU remover JTDI and JTAG_Reset and began splitting two debug swd ports
    [3d_dsn_approx.SchDoc]
2024-03-01 Power PCB draft
    [3d_dsn_approx.SchDoc, Pedal_Jacks.PrjPcb, Pedal_Power.PcbDoc, Pedal_Power.PrjPcb, Pedal_Power.SchDoc, ProtoStack_H750VBT.SchLib, SFW12S-2STE1LF.stp]
2024-03-01 Pedal korp expansion for bat pack
    [korp - assy2 retrofit old HW.3mf]
2024-03-01 cleanup - old 3d boards delete
2024-03-01 Added switching charger schematic & layout
    [Pedal_Power.PcbDoc, Pedal_Power.SchDoc]
2024-03-06 Added print stl
    Going to start redoing SOM_MCU schematic
    [Pedal_Power.PcbDoc, Pedal_Power.SchDoc, filter40-60khz.ms14, korpCopy.stl]
2025-07-26 New Multiboard
    New Multiboard project and WIP 3D folder
    [3D Model NCJ6FA-H.stp, 3d_design_approx.PcbLib, 3d_dsn_approx - Copy.SchDoc, 3d_dsn_approx.SchDoc, 74VHCT14AM1.SchDoc, Codec_CN.SchDoc, FOOT_CN.SchDoc, FootSW.PcbDoc]
2025-07-26 test change on boards
    project files are changed as the altium version on my laptop is older
    [3d_dsn_approx.SchDoc, Pedal_SW.PcbDoc, Pedal_SW.SchDoc]
2025-07-26 started XLR board routing
    [Pedal_SW.SchDoc, Pedal_XLR.PcbDoc, XLR.SchDoc]
2025-07-26 XLR placement wip
    Added rooms, need to bring buttons and LED to another PCB, maybe make PLS bigger
    [Pedal_XLR.PcbDoc, Pedal_XLR.SchDoc]
2025-07-31 update from PC
    [Pedal_Codec_4x4.PrjPcb, Pedal_MB.PrjPcb]
2025-07-31 Started adding digital codec connection and isolation options
    Maybe do it on the codec side? idk, so it was easier to study isolation effect while everything works
    [Codec_CN.SchDoc, SOM_Codec_WM8731.SchDoc]
2025-08-06 Added WS2812 project
    Added WS2812 project and cleaned up workspace
    [Codec_CN.SchDoc, MCU_AUDIO.SchDoc, MCU_GUI.SchDoc, Pedal_SW.PcbDoc, Pedal_WS2812.PrjPcb, Pedal_WS2812.SchDoc, Pedal_XLR.PcbDoc]
2025-08-07 Added license
    [Pedal_XLR (2).PcbDoc]
2025-08-25 Schematic cleanup & new FFC 30pin
    Need to add 17mm PLS to fit new jack board with headphone and expression jacks
    [3d_dsn_approx.SchDoc, Codec_CN.SchDoc, FOOT_CN.SchDoc, FootSW.PcbDoc, FootSW.step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]
2025-08-25 FFC replacement + Jack boards added, MBS & MBA update
    [3d_dsn_approx.SchDoc, Codec_CN.SchDoc, JACKS.SchDoc, Jacks.PcbDoc, Jacks.SchDoc, MIDI.SchDoc, Pedal_Back.PcbDoc, Pedal_Back.PrjPcb]
2025-08-25 XLR & SW routing
    [Pedal_SW.PcbDoc, Pedal_SW.SchDoc, Pedal_SW.step, Pedal_XLR.PcbDoc, Pedal_XLR.SchDoc, Pedal_XLR.step, XLR.SchDoc]
2025-08-30 Added dual jacks for HP & Expr
    Need to reconnect jacks and get rid of old jack-boards
    [HOOYA PJ-625CK.stp, Jacks.PcbDoc, ProtoStack_H750VBT.PcbLib, main.PcbDoc]
2025-09-03 Added jumper list to desolder for Nucleo and updated devboard pinout
    [H743ZI_SD_LCD_DRAM_Dev.SchDoc, pinout_devboard.ods]
2025-09-03 Add correct reference project for our H743ZI Nucleo devboard
    [Connectors.SchDoc, Ethernet.SchDoc, MB1137.PcbDoc, MB1137.PcbLib, MB1137.PrjPCB, MB1137.SCHLIB, MB1137.SchDoc, MCU_144.SchDoc]
2025-09-14 added shopping list for recent purchases
    [закупки на 14.09.25.ods]
2025-09-18 purchase table update
    [закупки на 14.09.25.ods]
2025-11-09 Codec connection and Audio MCU interfaces
    [3d_dsn_approx.SchDoc, Codec_CN.SchDoc, H743ZI_SD_LCD_DRAM_Dev.PrjPcb, H743ZI_SD_LCD_DRAM_Dev.SchDoc, MCU_AUDIO.SchDoc, MCU_GUI.SchDoc, SOM_MCU.SchDoc, main.PcbDoc]
2025-11-25 Add loop leds to mba
    [3d_dsn_approx.SchDoc, Codec_CN.SchDoc, JACKS.SchDoc, LOOP_LEDS.SchDoc, MCU_AUDIO.SchDoc, MCU_GUI.SchDoc, MIDI.SchDoc, Pedal_LoopLEDS.PcbDoc]
2025-11-26 starting to work on codec pcb
    [SOM_Codec_WM8731.PcbDoc, SOM_Codec_WM8731.SchDoc]
2025-11-27 New Codec pcb, started Filter pcb
    [Pedal_Codec_4x4.PrjPcb, Pedal_Filters.PcbDoc, Pedal_Filters.PrjPcb, Pedal_Filters.SchDoc, SOM_Codec_WM8731.PcbDoc, SOM_Codec_WM8731.SchDoc, SOM_MCU.SchDoc]
2025-11-28 Filter update
    Made first logic and filter routing
    [Pedal_Filters.PcbDoc, Pedal_Filters.PrjPcb, Pedal_Filters.SchDoc, SOM_Codec_WM8731.PcbDoc, SOM_Codec_WM8731.SchDoc]
2025-11-28 Filter update
    [2Filters.SchDoc, Pedal_Filters.PcbDoc, Pedal_Filters.PrjPcb, Pedal_Filters.SchDoc]
2025-12-09 Filters & codec & main - finishing routing
    [2Filters.SchDoc, Pedal_Filters.PcbDoc, Pedal_Filters.PrjPcb, Pedal_Filters.SchDoc, Pedal_Filters_45.PcbDoc, SOM_Codec_WM8731.PcbDoc, UI.SchDoc, main.PcbDoc]
2025-12-14 Routing finishing
    [JACKS.SchDoc, ProtoStack_H750VBT.PcbLib, ProtoStack_H750VBT.SchLib, SOM_Codec_WM8731.PcbDoc, SOM_Codec_WM8731.SchDoc, main.PcbDoc]
2026-01-04 Motherboard routing
    [Codec_CN.SchDoc, main.PcbDoc]
2026-01-07 Main board - first routing complete
    [3d_dsn_approx.SchDoc, FootSW.PcbDoc, FootSW.SchDoc, Jacks.PcbDoc, Jacks.SchDoc, analog_tmp.SchDoc, main.PcbDoc]
2026-01-07 Jacks components populated
    [Jacks.PcbDoc]
2026-01-08 Jacks board first route
    [Jacks.PcbDoc, Jacks.SchDoc]
2026-01-23 jacks header update
    [Jacks.PcbDoc]
2026-02-13 New assembly
    [Copy of main - shifted.PcbDoc, Pedal_SW.PcbDoc, Pedal_SW.step, newkorp_tmp7.stl, newkorp_tmp7_1.stl, newkorp_tmp7_2.stl, newkorp_tmp7_3.stl, newkorp_tmp7_4.stl]
2026-02-13 3d assembly progress
    [Display.stp, Jacks.PcbDoc, Jacks.step, Pedal_Display.PcbDoc, Pedal_Display.step, Pedal_LoopLEDS.step, Pedal_SD_USB.step, bottom1.stl]
2026-02-17 3d assembly & korp7 for 3d print
    [Pedal_Filters.step, SOM_Codec_WM8731.step, newkorp_tmp7.stl, newkorp_tmp7_1.stl, newkorp_tmp7_2.stl, newkorp_tmp7_3.stl, newkorp_tmp7_4.stl]
2026-02-18 added full korp7 stl for print
    [newkorp_tmp7.stl]
2026-02-18 3d print
    [newkorp_tmp7_1.stl, newkorp_tmp7_2.stl]
2026-02-20 added bent bottom lid
    [Copy of main - shifted.PcbDoc, newkorp_tmp7_2.3mf]
2026-03-05 New assembly6
    [Copy of main - shifted.PcbDoc, FootSW.PcbDoc, FootSW.step, Jacks.PcbDoc, Jacks.step, Pedal_Display.PcbDoc, Pedal_Display.step, Pedal_Filters.PcbDoc]
2026-03-06 screw selection
    some 3d screws models to choose from
    [18650 1x Holder - Compressed.stp, 18650 1x Holder.stp, BC2-3AE.stp, BK-18650-PC2.stp, BK-18650-PC4.stp, BK-18650-PC6.stp, BK-18650-PC8.stp, ISO 7380 - DIN 7380.SLDPRT]
2026-03-06 3d upd
    [ProtoStack_H750VBT.PcbLib, ProtoStack_H750VBT.SchLib, XLR.SchDoc, c3d-c-users-nlang-nextcloud-desktop-amphenol-projekte-drawings-3d-models-data-audio-c3d-acjc10hl.stp, c3d-c-users-nlang-nextcloud-desktop-amphenol-projekte-drawings-3d-models-data-audio-c3d-acjc6ahl.stp, main.PcbDoc, xlr_ACJC10HL_foot.dxf]
2026-04-04 exploded view & audio testboard added
    [0402 cap_1.step.SLDPRT, 0402 cap_2.step.SLDPRT, 0402 cap_3.step.SLDPRT, 0402 resistor.SLDPRT, 0402 resistor_1.step.SLDPRT, 0402 resistor_2.step.SLDPRT, 0402 resistor_3.step.SLDPRT, 0603 cap.SLDPRT]
2026-04-04 Audio Testboartd
    [Audio_testboard.PcbDoc, Audio_testboard.SchDoc, Pedal_MB.PrjPcb]
2026-04-04 Audio Testboard
    [Audio_testboard.PrjPcb, XLR.SchDoc]
2026-05-12 pcb routing
    [Audio_testboard.PcbDoc]
2026-05-13 audio test pcb
    [Audio_testboard.PcbDoc, Audio_testboard.SchDoc, XLR.SchDoc]
2026-05-13 added phone jack
    [Audio_testboard.PcbDoc, Audio_testboard.SchDoc, XLR.SchDoc]
2026-05-13 added green led
    [Audio_testboard.PcbDoc]
2026-05-13 added dc-dc isolated supplies
    [Audio_testboard.PcbDoc, Audio_testboard.SchDoc, Pedal_Filters.PcbDoc]
2026-05-13 audio pcb routing
    [Audio_testboard.PcbDoc, Audio_testboard.PrjPcb, Audio_testboard.SchDoc, Pedal_Filters.PcbDoc, Pedal_SW.SchDoc]
2026-05-14 Audio testboard - first route
    there are 3 nets unrouted - it's okay
    [Audio_testboard.PcbDoc, XLR.SchDoc]
2026-05-14 empty vias assignment gnd
    [Audio_testboard.PcbDoc]
2026-06-03 Input Stage modelling
    [Audio_testboard.PcbDoc, Audio_testboard.SchDoc, SOM_Codec_WM8731.SchDoc, XLR.SchDoc, input stage.ms14]
2026-07-20 Added BOM template and input stage simulations
    [input stage.ms14]
2026-07-20 Testboard checking
    [Audio_testboard.SchDoc]
2026-07-23 Audio_testboard sch & pcb net connections check
    [Audio_testboard.SchDoc]
2026-08-09 Testboard complete
    [Audio_testboard.GBL, Audio_testboard.GBO, Audio_testboard.GBP, Audio_testboard.GBS, Audio_testboard.GTL, Audio_testboard.GTO, Audio_testboard.GTP, Audio_testboard.GTS]
2026-09-04 Pinout checking, bridging audio testboard and main board
    [3d_dsn_approx.SchDoc, Audio_testboard.SchDoc, MCU_AUDIO.SchDoc, MCU_GUI.SchDoc, MIDI.SchDoc, Pedal_MB.PrjPcb, aydio testboard pinout.ods, pinout ioc h743zi_gui.csv]
